juanjodiaz04/Proyecto_Diseno_Productos/Reportes/Proyecto_Diseño_E2.pdf

Diseno Electr ˜ | onico y Captura Esquem ´ | atica CubeSat ´
UD34

Juan Jose Diaz, Kevin Echeverri Universidad de Antiquia
Diseno de Productos Electr ˜ | onicos ´
1. INTRODUCCION´
El presente informe tecnico documenta el dise ´ | no electr ˜ | onico detallado y la captura esquem ´ | atica de la tarjeta de Comunica- ´
ciones y Computador a Bordo (Comms+OBC), correspondiente a la arquitectura segmentada del nanosatelite acad ´ | emico tipo ´
CubeSat 1U (UD34). Partiendo de la arquitectura funcional, las interfaces y la matriz de requisitos consolidadas en las etapas
previas del proyecto, este trabajo aborda la transicion desde la definici ´ | on de bloques a nivel de sistema hacia la especificaci ´ | on´
e implementacion esquem ´ | atica rigurosa a nivel de componentes. ´

La PCB asignada constituye el nucleo de procesamiento central y el enlace de RF de la plataforma espacial. Sus funciones ´
principales abarcan la gestion del software de vuelo, el empaquetado de telemetr ´ | ía y ejecucion de comandos, la recepci ´ | on´
y almacenamiento masivo de las imagenes multiespectrales provenientes de la carga ´ | util, y el acondicionamiento de los ´
enlaces de radiofrecuencia para la descarga de datos hacia la estacion terrestre de referencia en Medell ´ | ín. Para satisfacer estos
requerimientos dentro del volumen y potencia restringidos de un CubeSat 1U, se selecciono una arquitectura h ´ | íbrida System-
on-Chip (SoC Microchip SmartFusion2) combinada con una cadena de comunicacion dual en bandas UHF y Banda S. ´
2. DESCRIPCION´ , FUNCIONES Y REQUISITOS DE LA TARJETA
El alcance de esta seccion del proyecto comprende la definici ´ | on de la arquitectura electr ´ | onica del CubeSat, la selecci ´ | on´
justificada de componentes, la elaboracion de esquem ´ | aticos detallados, el enrutamiento de las tarjetas de circuito impreso ´
(PCBs) y la integracion tridimensional b ´ | asica del hardware. ´
2.1. Descripcion´
La tarjeta COMMS+OBC es la segunda de las tres PCB en que se divide el CubeSat 1U UD34, junto con la tarjeta de
potencia (EPS) y la de carga util y actitud. Re ´ | une en una sola placa la computadora de a bordo y los enlaces de radio del sat ´ | elite. ´
Se conecta con el resto del sistema mediante el bus PC/104, para el que se usan dos conectores Samtec ESQ-126-14-G-D de 52 pines. Un conector de depuracion Samtec HTST10501-LDVDA de 10 pines permite programar y depurar la tarjeta, y dos ´ conectores SMP Rosenberger 18S142-40ML5 sacan las senales de radiofrecuencia hacia las antenas de UHF y banda S. ˜

La tarjeta se organiza en cuatro bloques funcionales: procesamiento y memoria, enlace UHF, enlace en banda S y gestion´ de energía:

2.11. Procesamiento y memoria: El elemento central es el SoC Microchip M2S050-FGG484I (SmartFusion2), que combina un procesador ARM y una FPGA en un mismo encapsulado. Sus controladores de memoria admiten DDR3 con correccion´ de errores SECDED, y el protocolo de la memoria eMMC se implementa en la logica programable. Una memoria ISSI ´ IS43TR16256A-125KBLI (DDR3L) funciona como RAM de trabajo. El firmware se guarda en memoria MRAM Everspin MR4A16BCYS35, de 2 MB por dispositivo, en encapsulado TSOP2-54, con un mínimo de dos y un maximo de cuatro unidades. ´ El almacenamiento masivo esta a cargo de una eMMC Micron MTFC32GAPALBH-AAT. Un oscilador Aker S3A33025 de 50 ´ MHz proporciona el reloj del sistema, y un supervisor con watchdog Texas Instruments TPS3823-33-EP vigila la alimentacion´ de 3.3 V y reinicia el sistema ante fallos.
2.12. Enlace UHF (435 a 438 MHz): Utiliza un transceptor Silicon Labs Si4468-A2A-IM, que sustituye al AX5043
considerado inicialmente. La codificacion de canal Reed-Solomon se ejecuta en la FPGA del SoC. En transmisi ´ | on, un ´
amplificador de potencia Analog Devices ADL5324 entrega cerca de 0.5 W, y un filtro pasa-bajos LC discreto limpia la
salida. Un conmutador SPDT pSemi PE4259 comparte la antena entre transmision y recepci ´ | on. En recepci ´ | on, un LNA Qorvo ´
PSA4-5043 precede a un filtro SAW RFMi SF2446E, de 23 MHz de ancho de banda, colocado solo en la ruta de recepcion. ´

2.13. Enlace en banda S (2.4 a 2.45 GHz): Se basa en el transceptor de radio definido por software Analog Devices AD9364BBCZ, en encapsulado CSP-BGA de 144 bolas, con un oscilador de referencia Aker S733025T de 40 MHz. El AD9364 entrega unos 7.5 dBm, por lo que la cadena de transmision a ´ nade un driver ADL5320 y un amplificador ADL5324, ˜ el mismo de la ruta UHF con otra red de adaptacion, para una potencia estimada de 0.4 a 0.5 W en la antena. Los baluns ´
Johanson 2450BL15B100 convierten entre las senales diferenciales del transceptor y las asim ˜ | etricas de la ruta de RF, y un filtro ´
TDK DEA202450BT limita las emisiones fuera de banda en transmision. La antena se comparte con un segundo conmutador ´
PE4259. El transceptor ya integra un LNA de recepcion; un Maxim MAX2644 queda como opci ´ | on, sujeto a evaluar si se ´
necesita.
2.14. Gestion de energ ´ | ía: La tarjeta recibe su alimentacion desde el bus del sat ´ | elite y genera localmente los rieles que ´
necesita. Un regulador conmutado Texas Instruments TPS62903 produce los rieles de 1.2 V, 1.35 V, 1.8 V. Un regulador lineal de ultra bajo ruido Analog Devices LT3045 alimenta las secciones analogicas del AD9364. Los amplificadores de potencia ´ trabajan con un riel de 5 V que un interruptor de carga Texas Instruments TPS22918-Q1 conecta solo durante los pases de comunicacion, lo que reduce el consumo medio. Un monitor de corriente Texas Instruments INA226 mide el consumo y protege ´ contra latch-up por radiacion (SEL). ´
2.2. Requisitos de la Tarjeta

Tabla I: Requisitos aplicables a la tarjeta de OBC + COMMS (PCB 2)

ID | Tipo | Requisito | Origen o justificacion | Prioridad Criterio de aceptaci ´ | on´
RF-02 | Funcional | El CubeSat debera almacenar tempo- ´ ralmente los datos generados por la
carga util antes de su transmisi ´ | on a ´
| | tierra. | S-05 / Operacion de la ´ carga util. ´
Alta | La capacidad de almacenamiento
| | | | | definida en la eMMC/MRAM de la
PCB debera ser igual o superior al ´ volumen maximo de datos generado ´
| | | | | entre oportunidades de descarga.
RF-03 | Funcional | El CubeSat debera transmitir a la ´
estacion terrestre los datos de misi ´ | on´
| | y la telemetría correspondiente al estado del satelite. ´ | S-08 / Comunicacion´ satelite–tierra. ´
Alta | El presupuesto de enlace de la etapa
| | | | | RF de la tarjeta debera demostrar ´ la capacidad de realizar el enlace descendente durante una ventana de

comunicacion prevista. ´
RF-04 | Funcional | El CubeSat debera recibir comandos ´ provenientes de la estacion terrestre. ´ | S-08 / Comunicacion´ bidireccional.
Alta | La arquitectura de comunicaciones en
la PCB debera contemplar un enlace ´
| | | | | ascendente (UHF) capaz de recibir y entregar comandos al sistema de

manejo de datos.

RNF-01 | No funcional | La plataforma espacial debera ser ´ capaz de operar nominalmente en orbita baja terrestre durante un ´ período mínimo de seis (6) meses sin
degradacion cr ´ | ítica de sus funciones.
| | | S-02 / Duracion nominal ´ de la mision. ´
Alta | La seleccion y an ´ | alisis de los ´
| | | | | componentes activos y pasivos de la
PCB debera demostrar compatibilidad ´
con una duracion m ´ | ínima de mision´
| | | | | de seis meses en el ambiente orbital
considerado.
RNF-03 | No funcional | El sistema de comunicaciones debera proporcionar un enlace con ´ margen positivo bajo las condiciones nominales de comunicacion con la ´ estacion terrestre de referencia. ´ | S-04 y S-08 / Enlace de comunicaciones.
Alta | El presupuesto de enlace de las
| | | | | etapas UHF y Banda S integradas en
la PCB debera presentar un margen ´
| | | | | superior a 0 dB para las condiciones nominales adoptadas.
RNF-04 | No funcional
Los subsistemas electricos deber ´ | an´
| | utilizar interfaces de alimentacion y ´ datos compatibles entre sí.
Integracion del sistema. | Alta | La etapa de regulaci ´ | on local (POL) ´
| | | | | y los buses de datos de la PCB
deberan demostrar compatibilidad ´ de tension, corriente, niveles ´ electricos y protocolos con el resto ´ de subsistemas.
RA-01 | Ambiental | El hardware del CubeSat debera ser ´
compatible con la operacion en vac ´ | ío
| | durante la fase orbital de la mision. ´ | S-03 / Ambiente espacial de operacion. ´
Alta | Los componentes, conectores y ma-
| | | | | teriales de la PCB (sustrato híbrido)
deberan disponer de caracter ´ | ísticas
| | | | | documentadas compatibles con la
operacion en vac ´ | ío.
Continua en la siguiente p ´ | agina ´

Continuacion de la Tabla I ´
ID | Tipo | Requisito | Origen o justificacion | Prioridad Criterio de aceptaci ´ | on´
RA-02 | Ambiental | El CubeSat debera soportar el entorno ´ termico asociado con los ciclos de ´
iluminacion y eclipse de la ´ | orbita ´
| | definida para la mision. ´ | S-03 / Entorno termico ´ orbital.
Alta | El analisis t ´ | ermico de la tarjeta ´
debera demostrar que las temperaturas ´
| | | | | estimadas de los integrados (SoC, PAs de RF, memorias) permanecen dentro de sus límites admisibles.
RA-03 | Ambiental | La estructura y los componentes del CubeSat deberan permanecer ´
mecanicamente ´ | íntegros frente
| | a las cargas previstas durante el lanzamiento y despliegue. | Entorno de lanzamiento / Seguridad.
Alta | La verificacion estructural de la PCB ´
debera demostrar la integridad de los ´
| | | | | encapsulados BGA, TSOP, conectores PC/104 y uniones de soldadura frente a los niveles de vibracion adoptados. ´
RA-04 | Ambiental | Los equipos electronicos cr ´ | íticos
| | del CubeSat deberan mantener su ´ funcionalidad despues de una Dosis ´ Ionizante Total de diseno de al menos ˜ 5 krad(Si). | S-02 y S-03 / Entorno de radiacion correspondiente ´ a una mision de seis ´ meses en SSO a 550 km.
Alta | La tolerancia documentada a TID
| | | | | de los integrados críticos de la PCB (SmartFusion2, MRAM, eMMC,

RFICs) debera ser igual o superior ´ al valor de diseno determinado. ˜
RA-05 | Ambiental | Los componentes electronicos cr ´ | íticos
| | susceptibles a latch-up deberan pre- ´ sentar un umbral de susceptibilidad a SEL por iones pesados igual o superior a 60 MeV cm²

/mg.

| | | S-03 / ECSS-E-ST-10- 12C, entorno de radiacion´ y efectos de evento unico. ´
Alta | Verificar documentalmente o mediante
| | | | | circuitos de proteccion local (*Load ´ Switches*) que los componentes de la PCB susceptibles a SEL presenten LETth ≥ 60 MeV · cm²

/mg.

RN-04 | Normativo | El subsistema de comunicaciones debera operar dentro de bandas y ´ condiciones de emision compatibles ´ con la reglamentacion de espectro ´ aplicable a la mision. ´ | S-08 / Regulacion´ de comunicaciones satelitales.
Alta | Las etapas de transmision UHF y ´
| | | | | Banda S de la PCB deberan ajustarse ´
a la asignacion de frecuencias, anchos ´
| | | | | de banda y potencias de emision´
autorizadas.
2.3. Especificaciones Tecnicas ´
Las especificaciones tecnicas se derivan de los requisitos definidos previamente y establecen los par ´ | ametros necesarios para orientar la ´
arquitectura, la seleccion tecnol ´ | ogica y las interfaces entre subsistemas; se establecen los m ´ | etodos de verificaci ´ | on utilizando las abreviaturas ´
A (analisis), I (inspecci ´ | on o revisi ´ | on documental), T (ensayo) y D (demostraci ´ | on). ´

Tabla II: Especificaciones tecnicas de la tarjeta COMMS+OBC ´

ID de especificacion´

Requisitos
asociados
Parametro t ´ | ecnico | Valor, rango o ´
tolerancia
Unidad Fundamento | Metodo ´
previsto de
verificacion´
ET-MIS-01 | RNF-01 | Vida util nominal de la ´
mision´
≥ 6 | meses | Duracion m ´ | ínima establecida en el
supuesto S-02. Condiciona la seleccion´ de componentes de la tarjeta.

A, I

ET-ORB-01 RA-02, RA-04 Altitud orbital de referencia | 550 nominal | km | Orbita adoptada en el supuesto S-03. Se ´ usa en el presupuesto de enlace y en el
analisis de radiaci ´ | on de la tarjeta. ´

A

ET-GS-01 | RNF-03 | Estacion terrestre de ´
referencia
Medellín | – | Ubicacion definida en el supuesto S-04. ´
Base del presupuesto de enlace de las bandas UHF y S.

A

ET-OBC-01 | RF-02 | Elemento de procesamiento | Microchip M2S050-FGG484I (ARM + FPGA)
– | Se requiere logica programable para im- ´
plementar el host eMMC y la codificacion´ Reed-Solomon del enlace UHF, ademas del ´ procesador de a bordo.

I

ET-OBC-02 | RF-02 | Frecuencia del reloj del sistema
50 | MHz | Oscilador Aker S3A33025 alimentado a 3.3
V.

I

ET-OBC-03 | RNF-01 | Supervision de alimentaci ´ | on´
| | y watchdog

Supervisor de 3.3 V
con watchdod

– Texas Instruments TPS3823-33-EP. Reinicia el sistema ante caídas de tension o bloqueo ´ del software.

A, I, D

ET-MEM-01

RF-02 | Memoria RAM de trabajo | 512 (4 Gb) | MB | ISSI IS43TR16256A-125KBLI (DDR3L, 1.35 V). Capacidad deducida de la
organizacion 256M ´ | × 16;

A, I

ET-MEM-02

RF-02 Memoria no volatil para ´ firmware

2 por dispositivo, de 2
a 4 dispositivos

MB Everspin MR4A16BCYS35 en TSOP2-54. La cantidad de unidades depende de la redundancia de firmware que se adopte.

A, I

Continua en la siguiente p ´ | agina ´

Continuacion de la Tabla II ´

ID de especificacion´

Requisitos
asociados
Parametro t ´ | ecnico | Valor, rango o ´
tolerancia
Unidad Fundamento | Metodo ´
previsto de
verificacion´

ET-MEM-03

RF-02 Capacidad nominal de almacenamiento masivo

32 | GB | Micron MTFC32GAPALBH-AAT (eMMC).
El host se implementa en la fabric del SoC. La capacidad util se verifica contra ´ ET-DAT-02.

A, I

ET-DAT-01 RF-01, RF-02 Volumen de datos por adquisicion´

21 | MB | Se calculara a partir de la resoluci ´ | on del ´
| | sensor, numero de bandas, profundidad de ´ bits y esquema de compresion adoptado. ´

Dimensiona el almacenamiento de la
| | tarjeta.

A

ET-DAT-02 | RF-02 | Capacidad util m ´ | ínima de
almacenamiento masivo
8 | GB | Se calculara a partir del m ´ | aximo volumen ´
de datos acumulado entre oportunidades consecutivas de descarga, y se comparará con ET-MEM-03.

A, I

ET-COM-01

RF-03 Tasa neta mínima de enlace descendente

1.0 | Kbps
Mbps | Se calculara a partir del volumen de datos ´
que debe transmitirse y del tiempo efectivo
de comunicacion con la estaci ´ | on terrestre. ´

A

ET-COM-02

RNF-03 Margen del enlace de comunicaciones

> 0 | dB | Condicion establecida por RNF-03. Se ´ verificara mediante el presupuesto de ´ enlace de cada banda en condiciones nominales.
A

ET-COM-03

RF-03, RF-04,
RN-04

Banda de operacion del ´
enlace UHF
435 a 438 | MHz | Seleccionada en la arquitectura de la tarjeta (Si4468-A2A-IM). La coordinacion y la ´
regulacion de espectro aplicables est ´ | an por ´
| | confirmar.

A, I

ET-COM-04

RF-03, RF-04,
RN-04

Banda de operacion del ´
enlace en banda S
2.4 a 2.45 | GHz | Seleccionada en la arquitectura de la tarjeta (AD9364BBCZ).
A, I

ET-COM-05

RF-03,
RNF-03

Potencia de transmision´
UHF
0.5 nominal | W | Amplificador Analog Devices ADL5324. El valor de P1dB a 436 MHz
A, T

ET-COM-06

RF-03,
RNF-03

Potencia de transmision en ´ banda S en la antena

0.4 a 0.5 (estimada) | W | El AD9364 entrega unos 7.5 dBm. El driver ADL5320 y el amplificador ADL5324 elevan la senal, y el filtro TDK ˜ DEA202450BT introduce unos 1.8 dB de perdida. ´
A, T

ET-COM-07

RF-03, RF-04 Codificacion de canal del ´ enlace UHF

Reed-Solomon en la
fabric del SoC

– El Si4468 no incluye correccion de errores, ´ por lo que la FEC debe implementarse en la logica programable. ´ A, D

ET-COM-08

RF-03, RF-04 Modo de acceso a la antena por banda

Conmutacion TX/RX ´
(semiduplex) ´

– Conmutador SPDT pSemi PE4259 por banda para compartir la antena. I, D

ET-INT-01 | RNF-04 | Tension nominal del bus ´
electrico principal ´
5 | V | Se definira mediante la selecci ´ | on de la ´
arquitectura EPS. Es la entrada de los
| | reguladores de la tarjeta.

A, I

ET-PWR-01 RNF-02,
RNF-04

Rieles generados en la
tarjeta
1.2; 1.35; 1.8 | V | Regulador conmutado TPS62903. Alimentan SoC, DDR3L (incluye VTT y VREF), eMMC, memorias MRAM, transceptores y relojes.
A, I, T

ET-PWR-02 RF-03,
RNF-02

Alimentacion de bajo ruido ´ para el transceptor de banda S

Riel dedicado con
LDO de ultra bajo
ruido
– | Analog Devices LT3045 para limpiar la
alimentacion del AD9364 (n ´ | ucleo de 1.3 ´
V).

A, T

ET-PWR-03 | RNF-02 | Riel de los amplificadores de
potencia

5, conmutado, activo
solo durante los pases
| | V | Interruptor de carga TPS22918-Q1. Reduce el consumo medio de la tarjeta.
A, T

ET-PWR-04 RF-07,
RNF-02
Potencia pico de la tarjeta | 5.5 a 9 | W | Se obtendra del presupuesto de potencia, ´ con los amplificadores UHF y banda S activos. Alimenta el presupuesto del CubeSat.
A, T
ET-PRO-01 | RA-05 | Proteccion contra latch-up de ´ la tarjeta
Corte por hardware
ante sobrecorriente;
umbral

– El pin ALERT del INA226 se conecta por hardware a la habilitacion del interruptor ´ de carga, sin intervencion del software. ´

A, I, T

ET-INT-03 | RNF-04 | Conectores del bus CubeSat
(PC/104)
2 conectores de 52 | pines | Samtec ESQ-126-14-G-D. La asignacion de ´
pines se define en la matriz de interfaces.

I

ET-INT-04 | RNF-04 | Conector de programacion y ´
depuracion´
10 | pines | Samtec HTST10501-LDVDA. Acceso al
SoC para programacion y depuraci ´ | on. ´

I, D

Continua en la siguiente p ´ | agina ´

Continuacion de la Tabla II ´

ID de especificacion´

Requisitos
asociados
Parametro t ´ | ecnico | Valor, rango o ´
tolerancia
Unidad Fundamento | Metodo ´
previsto de
verificacion´

ET-INT-05 RF-03,
RNF-04
Conectores de antena | 2 SMP (UHF y banda
S), 50

Ω Rosenberger 18S142-40ML5. La impedancia de 50 Ω es una inferencia por confirmar con la hoja de datos.

I, T

ET-MEC-01 | RN-01 | Configuracion mec ´ | anica | 1U | – | Formato definido por S-01 y la CubeSat ´
Design Specification Rev. 14.1. Acota el area disponible de la tarjeta. ´

I

ET-PCB-01 RF-03, RF-04 Material del apilamiento de la PCB

Rogers RO4350B +
Isola 370HR; 8 Capas

– Material de bajas perdidas para las capas ´ de RF y material estandar para el resto. ´ El apilamiento se detalla en la guía de enrutamiento. A, I

ET-PCB-02 RF-03, RF-04 Blindaje contra interferencia electromagnetica ´

Blindaje Harwin sobre
las secciones de RF;
referencia TBD

– Separa los circuitos de RF de los circuitos digitales y de potencia de la tarjeta. A, I

ET-ENV-01 | RA-01 | Ambiente de operacion´ durante la fase orbital
Vacío orbital | – | Condicion ambiental derivada de la ´
operacion en ´ | orbita definida en S-03. ´

A, I

ET-TH-01 | RA-02 | Rango termico de dise ´ | no | -20 a 85 ˜
◦C | Se determinara mediante an ´ | alisis ´
termico. La MRAM (-40 a +85 ´

◦C) y el
conmutador PE4259 (maximo 85 ´

◦C) fijan
el límite superior.

A

ET-STR-01 | RA-03 | Nivel de cargas y vibracio-
nes de lanzamiento
14.1 | Grms | Perfil de vibracion aleatoria envolvente ´
(NASA GEVS GSFC-STD-7000A) y
cargas cuasi-estaticas para la verificaci ´ | on´
de encapsulados BGA, TSOP y conectores de la tarjeta.

A, T

ET-RAD-01 | RA-04 | Dosis Ionizante Total de disenõ
5 | krad(Si) Dosis ionizante acumulada calculada para
6 meses en SSO a 550 km, considerando blindaje equivalente de 1.5 mm de aluminio y un margen de diseno RDM de 2.5x. ˜

A

ET-RAD-02 | RA-05 | Umbral mínimo de susceptibilidad a SEL
≥ 60 | MeV·cm²
mg

Valor establecido en RA-05 para los componentes críticos de la tarjeta susceptibles a Single Event Latch-up.

I

ET-RAD-03 | RA-04 | Mitigacion de errores en ´ memoria
SECDED en la
DDR3L; firmware
replicado en 2 a 4
MRAM

– Los controladores DDR del SoC admiten SECDED. La redundancia de MRAM protege el firmware frente a errores por radiacion. ´

A, D

2.4. Funciones
A partir de las funciones requeridas para el cumplimiento de la mision, se realiz ´ | o una asignaci ´ | on preliminar entre hardware ´
y software. Esta clasificacion considera los recursos electr ´ | onicos necesarios para ejecutar cada funci ´ | on y las responsabilidades ´
que debera asumir posteriormente el software de vuelo. Aunque dicho software no ser ´ | a implementado durante el proyecto, ´
esta distribucion permite estimar las necesidades de procesamiento, memoria, almacenamiento, interfaces y temporizaci ´ | on del ´
sistema.

Tabla III: Funciones de hardware y software asignadas a la tarjeta OBC + COMMS

Funcion | Tipo de ´
implementacion´
Recursos de hardware necesarios | Responsabilidad del software futuro | Justificacion´

Procesamiento de datos
de la carga util ´
Software | Procesador dedicado/SoC (Smart-
Fusion2 con matriz FPGA y nucleo ARM), RAM DDR3L y ´ almacenamiento masivo local. | Gestionar los datos adquiridos, generar metadatos, verificar integridad y realizar
operaciones de preparacion o compresi ´ | on´
| antes del almacenamiento o transmision. ´ | La funcion es principal- ´ mente algorítmica. La FPGA y el procesador de la PCB 2 constituyen el recurso físico sobre el cual se ejecuta el software de procesamiento.
Continua en la siguiente p ´ | agina ´

Continuacion de la Tabla III ´

Funcion | Tipo de ´
implementacion´
Recursos de hardware necesarios | Responsabilidad del software futuro | Justificacion´

Almacenamiento de
imagenes ´
| | Mixta | Memoria no volatil (eMMC / NAND ´ Flash de 8–32 GB) con interfaz compatible montada en la tarjeta central.
Administrar archivos o bloques de datos, controlar la ocupacion, verificar integridad ´ mediante CRC y eliminar los datos descargados correctamente.

RF-02. La memoria masiva
local realiza físicamente el almacenamiento,
mientras que el software
administra la organizacion´ e integridad de la
informacion. ´
Buffer temporal de
imagenes ´ | | Software | Memoria RAM disponible mínima de 16 MB en la cadena de procesamiento de la tarjeta.
Gestionar buffers de entrada y salida, controlar transferencias entre la camara, RAM ´
y memoria no volatil y evitar p ´ | erdida de ´
informacion. ´

La funcion corresponde ´
principalmente a gestion de ´ memoria de trabajo para
manipular los paquetes
de imagen antes de su
compresion o guardado. ´
Control y coordinacion´
central del CubeSat
| | Software | Computador de a bordo basado en SoC ARM Cortex-M3, memoria no volatil y buses CAN, SPI, UART, ´ I 2C y LVDS.
Ejecutar la maquina de estados de misi ´ | on, ´
coordinar subsistemas, gestionar modos de operacion, procesar eventos y ejecutar las ´ acciones asociadas a los comandos recibidos.

La coordinacion del siste- ´ ma depende principalmente
de la logica del software ´ de vuelo; el hardware
del OBC proporciona los
recursos computacionales
necesarios.
Temporizacion y ´
referencia temporal
| | Mixta | RTC, oscilador de referencia (TCXO) y temporizadores disponibles en el computador de a bordo.

Mantener el tiempo de mision, generar marcas ´
temporales para imagenes y telemetr ´ | ía y
programar eventos de operacion. ´

El hardware de la tarjeta
proporciona la referencia
temporal estable y el
software la utiliza para
sincronizar los eventos de mision. ´
Deteccion y recuperaci ´ | on´
ante fallos | | Mixta | Watchdog hardware externo, supervisores de alimentacion locales ´ y limitadores de corriente (Load Switches).

Detectar condiciones anomalas, registrar ´ eventos, reiniciar subsistemas y llevar el satelite a un estado seguro cuando sea ´ necesario.

Combina mecanismos
autonomos de protecci ´ | on´
en hardware local
con estrategias de
deteccion y recuperaci ´ | on´
implementadas mediante
software.
Recepcion de comandos ´ críticos | | Mixta | Transceptor UHF (AX5043 / CC1120 o equivalente) en el rango de 400 MHz con tasa nominal de 9,6 kbps.
Validar la integridad de las tramas recibidas, interpretar los comandos y generar las acciones correspondientes sobre los subsistemas.

RF-04. El transceptor
realiza la recepcion´
física en radiofrecuencia, mientras que el software
interpreta y ejecuta el
contenido del comando.
Transmision de telemetr ´ | ía | Mixta | Transceptor UHF con tasa nominal de 9,6 kbps y conexion digital ´ directa con el procesador central.
Construir paquetes de housekeeping con tensiones, corrientes, temperaturas, estados, alarmas y eventos, y gestionar su envío.

RF-03. El software genera
y organiza la telemetría
mientras el hardware de
radiofrecuencia realiza el enlace físico descendente.
Transmision de im ´ | agenes | Mixta | Transmisor de alta velocidad ´
| | | en Banda S (2.2–2.4 GHz) con capacidad de 1 Mbps a 8 Mbps.

Fragmentar las imagenes, organizar los ´ paquetes, gestionar la cola de transmision´ y mantener registro de la informacion´ descargada.

RF-03. El software
gestiona el flujo de
paquetes desde la eMMC
hacia la etapa RF de
Banda S para su descarga
durante la ventana sobre
Medellín.
| 3. RESTRICCIONES PARA EL DISENO DE LA ˜ | PCB

Basado en las hojas de datos, las arquitecturas discutidas y los requisitos del proyecto CubeSat 1U documentados en tus
fuentes, a continuacion se presenta la matriz de restricciones f ´ | ísicas, electricas y t ´ | ermicas para el dise ´ | no de la placa OBC + ˜
COMMS.

Tabla IV: Restricciones para el diseno PCB OBC + COMMS ˜

ID y Trazabilidad | Restriccion y Alcance | Fuente y Fundamento | Aplicaci ´ | on y Verificaci ´ | on´

PCB-01
(RF-03, RN-04)

Apilamiento Híbrido (Stackup): Placa de 8 a 12 capas. Capas externas (Top/Bottom) en Rogers RO4350B (alta frecuencia) y capas internas en FR-4 High-Tg / Isola 370HR para logica digital. ´

Recomendacion de arquitectura ´ RF/Digital: El FR-4 estandar ´ presenta perdidas inaceptables en ´ Banda S (2.4 GHz). El stackup híbrido optimiza costos e integridad de senal. ˜

Directiva de fabricacion: ´ Supuesto preliminar para el fabricante de
PCBs. Verificacion en el ´ | Layer Stack
Manager del CAD.

PCB-02
(RA-01, RA-02)
Disipacion T ´ | ermica (V ´ | ías): Arreglos
de vías termicas ( ´ | | thermal vias) bajo
los PAs de RF (ADL5324) y el SoC SmartFusion2, conectando a planos gruesos de cobre (2 oz) vinculados al chasis.

Inferencia justificada (Entorno Espacial): En el vacío no existe conveccion. Los integrados de alto ´ consumo colapsaran t ´ ermicamente ´ sin conduccion directa a la ´ estructura.

Regla de layout: Colocacion de ´ polígonos termicos y matrices de ´
vías. Verificacion mediante an ´ | alisis ´
termico del CAD y revisi ´ | on visual. ´

PCB-03
(RNF-03, RF-03)

Impedancia Controlada RF y Aislamiento: Microcintas Coplanares con Plano de Masa (CPWG) a 50 Ω hacia conectores SMP, rodeadas por apantallamiento de vías (via fencing).

Datasheet SMP y RFICs: Evita perdidas por desacople, ondas ´ reflejadas y radiacion que degraden ´ la figura de ruido o danen las etapas ˜ de salida.

Directiva de ruteo: El ancho de pista dependera del stackup final. ´ Verificacion por calculadora de ´ impedancia y regla DRC en el CAD.

PCB-04
(RNF-04, IF-02,
IF-07)

Integridad de Senales Diferenciales ˜ (LVDS): Enlaces LVDS/MIPI con impedancia diferencial de 100 Ω. Acoplamiento de longitud (desfase
< 0,3 mm) y plano de masa continuo adyacente.

Estandar LVDS / ECSS Space- ´ Wire: Cancela el ruido de modo comun, minimiza emisiones EMI ´ y previene desalineacion de fase a ´ altas velocidades.

Regla DRC de alta velocidad: Differential Pairs Routing y Length Tuning (Meandering). Verificacion´ automatica en el DRC. ´

PCB-05
(RNF-03, EMC)

Apantallamiento Electromagnetico ´ (EMI): Cajas de blindaje SMD independientes (Shielding Cans) para las secciones UHF, Banda S y reguladores Buck conmutados.

Buena practica RF (Aislamiento): ´ El ruido digital del SoC y la emision UHF (1 W) pueden ´ ensordecer los receptores LNA o acoplar ruido al enlace de Banda S.

Regla de layout: Footprints para clips de blindaje y zonas keep-out sin pistas en la capa top. Revision´ de modelo 3D.

PCB-06
(RNF-04, POL(Point
of Load))
Ubicacion de Regulaci ´ | on RF ´
(LDOs): LDOs de ultra-bajo
ruido (LT3042/LT3045) ubicados a milímetros de las entradas analogicas ´ del AD9364 (1,3 V) y LNAs.

Datasheet AD9364 y LNAs: Los PLLs y sintetizadores son sensibles al rizado de tension. Separarlos de ´ reguladores conmutados asegura un PSRR optimo. ´

Directiva de placement: Aislamiento de dominios de energía en la hoja POL y ruteo directo. Revision´ manual del esquematico. ´

PCB-07
(OBC, Power)

Desacoplamiento SoC y Filtrado LC: Multiples capacitores en paralelo ´ pegados al BGA (1,2 V). Filtrado pasivo LC (ferrita + cap) exclusivo para las líneas VDD PLL.

Guía de aplicacion SmartFusion2: ´ Inductores en el nucleo provocan ´ caídas por dI/dt. Los PLLs requieren filtrado pasivo al consumir corriente estable.

Restriccion de ruteo: ´ | Capacitores
colocados en la misma capa del BGA o con vías cortas directas.
Verificacion visual 3D e inspecci ´ | on´
de ERC.
PCB-08
(RNF-02, EPS)

Control de Pico de Corriente (Soft-Start): Capacitores de 3,3 nF a
10 nF en el pin SS/TR de los Bucks TPS62130A para un arranque suave de ≈ 2 − 4 ms.

Datasheet TPS62130A y dinamica ´
sistemica: ´ | Previene colapsos en el
bus de alimentacion global del EPS ´ al cargar el banco de capacitores del SoC/DDR3L.
Comprobacion esquem ´ | atica ´
(ERC): Verificacion de selecci ´ | on de ´
dielectricos C0G/X7R en la BOM y ´ simulacion de tiempo de arranque. ´
4. CONDICIONES DE FABRICACION´

Con el fin de garantizar la manufacturabilidad (Design for Manufacturing - DFM) y asegurar la confiabilidad del ensamblaje de la tarjeta integrada de OBC + COMMS, se selecciono al proveedor PCBWay (https://www.pcbway.com/advanced-pcb-capabilities.html) como fabricante de referencia (Consultado ´
20/10/2026). Esta eleccion se fundamenta en su capacidad tecnol ´ | ogica para procesar circuitos impresos multicapa de alta ´
densidad (HDI), el soporte para acabados superficiales de grado fino y QFN, y la disponibilidad de procesos para stackups híbridos con sustratos de alta frecuencia.
A partir de las especificaciones y tolerancias del proceso de fabricacion, se definieron los l ´ | ímites geometricos y el ´ | ectricos que ´
deben configurarse como reglas de diseno (Design Rules) en el entorno CAD (Altium Designer). Estas condiciones aseguran ˜ la integridad física de las pistas de impedancia controlada (50 Ω RF y 100 Ω diferencial LVDS), la viabilidad en la perforacion´
y metalizado de vías termicas, y el cumplimiento de los m ´ | argenes de aislamiento electromagn ´ | etico. ´
La Tabla V sintetiza los parametros l ´ | ímite de fabricacion adoptados para el dimensionamiento del layout de la PCB. ´

Tabla V: Parametros de dise ´ | no DFM vs. l ˜ | ímites de fabricacion de PCBWay ´
Parametro DFM | Par ´ | ametro Escogido ´
(PCB 2)
Límite del Fabricante (PCBWay) | Fundamento / Criterio de Seleccion´
Numero de capas | 8 capas | Hasta 64 capas | Requerido para el escape (*fanout*) del BGA ´
de 484 pines (SmartFusion2), ruteo de buses LVDS y planos de masa para RF.
Material base y Stackup | Híbrido: Rogers RO4350B (capas ext.) + FR-4 High- Tg / Isola 370HR (capas int.) | FR-4 High-Tg (Tg170–220), Rogers 4350/4003, PTFE, Ceramico, ´ Prensado mixto (2–20 capas)
Minimiza la atenuacion diel ´ | ectrica en la etapa ´
de Banda S (2,4 GHz) en capas externas y optimiza costos en capas digitales internas.
Espesor nominal de la placa | 1,6 mm ± 7 % | 0,21 mm − 6,0 mm (±7 % para espesores entre 1,0 mm y 2,5 mm)
Estandar mec ´ | anico compatible con los ´
conectores apilables PC/104 de la estructura CubeSat 1U y rigidez ante vibraciones.
Ancho de pista y espaciamiento (W/S) | 4,0 mil/4,0 mil (0,10 mm) | Mínimo 2,0 mil/2,0 mil (0,05 mm) en capas internas y externas
Facilita el ruteo entre los pines del BGA (0,8 mm pitch) manteniendo un alto rendimiento de fabricacion (*yield*). ´
Diametro de perforaci ´ | on´
vía (Drill) | 0,20 mm (8 mil) mecanico ´ pasante | Mínimo 0,15 mm (Mecanizado CNC) / 0,10 mm (Microvía Laser ´ ciega/enterrada)
Permite la transicion entre capas sin recurrir a ´
microvías laser de alto costo (tecnolog ´ | ía HDI
estandar pasante). ´

Relacion de aspecto ´
(*Aspect Ratio*)
8 : 1 (1,6 mm/0,20 mm) | Hasta 12 : 1 (estandar) / ´ | 20 : 1
| | (capacidad maxima) ´

Garantiza la homogeneidad y continuidad del cobreado electrolítico en las paredes internas de las vías pasantes.

Anillo de cobre (*Annular Ring*) | 4,0 mil (0,10 mm) en vías / 6,0 mil en orificios THT | Mínimo 3,0 mil en vías / 5,0 mil en orificios de componentes
Previene la desalineacion de la perforaci ´ | on´
(*breakout*) y asegura la integridad bajo
delaminacion por ciclos t ´ | ermicos. ´
Capacidad para componen- tes BGA | Pitch de 0,8 mm / Pad de 0,35 mm | Pitch mínimo de BGA: 0,4 mm /
Diametro m ´ | ínimo de BGA: 8 mil
| | (0,20 mm)

Adaptado a la matriz FGG484 del SoC SmartFusion2 (M2S050) y chips de memoria masiva.

Puente de mascara de ´ soldadura (*Solder Mask Dam*) | 4,0 mil (0,10 mm) | Mínimo 3,0 mil (mascara verde) / ´ 4,0 mil (mascara negra/otras) ´
Retiene el flujo de soldadura entre pads adyacentes de alta densidad para prevenir cortocircuitos por puentes durante el *reflow*.
Acabado superficial (*Surface Finish*) | **ENIG** (*Electroless Nickel Immersion Gold*) | ENIG, HASL, Lead Free HASL, OSP, Immersion Ag/Sn, Plating Hard Gold

Superficie plana indispensable para encapsulados BGA/QFN de paso fino y excelente resistencia a la oxidacion en ´ almacenamiento/vacío.

Tolerancia de control de impedancia | ±10 % (50 Ω RF CPWG / 100 Ω diferencial LVDS) | ±10 % (±5 Ω para impedancias ≤ 50 Ω)
Asegura la integridad de senal en la interfaz ˜ del SDR AD9364, conector SMP y las trazas de alta velocidad de la camara. ´
Distancia vía a conductor (*Hole to Conductor*) | 8,0 mil (0,20 mm) | Mínimo 6,0 mil (0,15 mm) a conductores internos y externos
Evita acoplamientos capacitivos no deseados y perforaciones sobre pistas activas por tolerancias de taladrado.
Espesor del cobre (*Copper Thickness*) | Capas ext.: 1,0 oz (35 µm) / Capas int.: 0,5 − 1,0 oz | Cobre base mín. 1/3 oz (12 µm) hasta 8 oz maximo final ´
Proporciona la capacidad de conduccion´ necesaria para los reguladores POL y estabilidad para el grabado de líneas de RF.
5. RESTRICCIONES PROYECTO DE ALTIUM
Las restricciones siguientes corresponden a la etapa de captura esquematica ´ | de la tarjeta Comms+OBC. Se distinguen
las comprobaciones que pueden ejecutarse en Altium de las restricciones de PCB que unicamente podr ´ | an verificarse despu ´ | es´
del diseno f ˜ | ísico. Los límites de impedancia, geometría y materiales descritos en las secciones anteriores se conservan como
objetivos de disenõ , no como resultados de fabricacion demostrados. ´

Tabla VI: Matriz de restricciones del proyecto Altium y criterio de comprobacion. ´

ID | Restriccion / criterio de aceptaci ´ | on | Evidencia y m ´ | etodo ´
AL-01 | Cada componente montado debe tener desig-
nador unico, valor o referencia, fabricante, ´ MPN y huella compatible.

Inspeccion de propiedades y compara- ´
cion esquem ´ | atico–BOM; revisar com- ´
ponentes sin footprint.

ID | Restriccion / criterio de aceptaci ´ | on | Evidencia y m ´ | etodo ´
AL-02 | No deben existir redes sin conductor inten-
cional, conflictos de direccion el ´ | ectrica ni pi- ´
nes de alimentacion indebidamente abiertos. ´

Compilacion y ´ Electrical Rules Check (ERC); registrar y justificar excepciones.

AL-03 Todas las hojas deberan usar nombres de ´ red, puertos y conexiones jerarquicas cohe- ´

rentes, sin uniones implícitas no previstas.

| | | | Navegador de redes, cross-probing y
revision manual hoja a hoja. ´
AL-04 | Cada dominio de alimentacion deber ´ | a indi- ´
| car tension nominal, secuencia de encendi- ´
do, retorno y protecciones aplicables.

Revision de hojas POL, reguladores, ´
| | | | load switches, supervisor y secuencia
de arranque.
AL-05 | Las interfaces del SoC, memorias y radios
| deben respetar niveles logicos, direcciones, ´ tensiones de banco y asignacion de pines. ´ | | | Cruce de datasheets, pinout y tabla de interfaces; comprobacion de conexio- ´

nes.

AL-06 | El reloj de referencia, reset, watchdog, pro-
| gramacion y arranque deben estar definidos ´
y sin estados flotantes peligrosos.

Revision de osciladores, resistencias ´ de polarizacion, JTAG y supervisor. ´

AL-07 | Las redes RF deben identificar trayectoria
TX/RX, filtros, adaptacion, alimentaci ´ | on y ´
conectores de impedancia nominal 50 Ω.

Inspeccion de cadena RF y datasheets; ´
| | | | impedancia física pendiente de layout.
AL-08 | Las senales diferenciales y los buses de alta ˜ velocidad deberan tener pares, polaridad, ´ terminacion y restricciones identificables. ´
Revision del esquem ´ | atico y futu- ´
ra definicion de reglas de impedan- ´
| | | | cia/longitud en PCB.
AL-09 | Los dispositivos de potencia y radiofrecuen-
| cia deberan contar con desacoplamiento y ´
filtrado acordes con sus fabricantes.

Revision manual de condensadores, ´
| | | | valores, ubicacion prevista y rutas de ´
retorno.
AL-10 | Los componentes opcionales o no montados
| deberan identificarse inequ ´ | ívocamente para
la configuracion de producci ´ | on. ´
| | | | Variantes de ensamblaje y BOM ex- portada con columna de montaje.
AL-11 | Las librerías deberan tener correspondencia ´
verificable entre símbolo, numeracion de pi- ´
| nes y footprint.
Comparacion con datasheets y revisi ´ | on´
| | | | de modelos en Altium.
AL-12 | El proyecto entregado debe contener fuen-
| tes editables, PDF del esquematico, BOM, ´ evidencias ERC y version identificada. ´ | | | Auditoría del repositorio y compro-
bacion de accesibilidad del com- ´ mit/etiqueta.
5.1. Restricciones derivadas y control de cambios
El inventario actualizado de componentes constituye una entrada de control de configuracion, pero ´ | no reemplaza la BOM
generada desde el proyecto compilado. En particular, se debe reconciliar la mencion previa del regulador TPS62130A con el ´ TPS62903QRYTRQ1 listado actualmente; no se deben trasladar valores de soft-start, compensacion o condensadores de un ´ circuito integrado al otro sin consultar su hoja de datos. Asimismo, las referencias de memorias, osciladores, balunes y filtros se deben contrastar con el voltaje, frecuencia, encapsulado y modo de interfaz realmente cableados. Toda sustitucion debe ´ registrar el requisito afectado, la hoja modificada y la revision del proyecto. ´
6. VERIFICACION DEL ´ | DISENÕ
La verificacion se plantea de acuerdo con el enfoque de ingenier ´ | ía de sistemas de NASA: cada requisito debe vincularse
con un metodo, un criterio de aceptaci ´ | on y una evidencia. Se emplean ´ | I (inspeccion), ´ | A (analisis), ´ | D (demostracion) y ´ | P
(prueba). En esta fase se verifica principalmente la consistencia del diseno esquem ˜ | atico ´ | ; el funcionamiento en hardware, la
compatibilidad electromagnetica y las prestaciones orbitales requieren ensayos posteriores. Ning ´ | un resultado de ERC o de ´
laboratorio se declara aprobado sin evidencia adjunta.

Tabla VII: Plan de verificacion y trazabilidad preliminar. ´

ID | Elemento a verificar | Meto- ´ do
Criterio de aceptacion | Estado / evidencia ´
VER-01 | Integridad | del
esquematico ´
| | I | | Proyecto compilado; sin errores
electricos reales sin resolver. ´

Revisado: reporte
ERC.
VER-02 | Símbolos y huellas | I | | Coincidencia de todos los pines y
encapsulados con el fabricante.

Revisado: revision´
cruzada.
VER-03 | Dominios de tension | I/A | Cada carga recibe alimentaci ´ | on´
| | | | compatible y tiene desacoplamien-
to definido.

Revisado: matriz
de tensiones.
VER-04 | Arranque y supervision I/A | Estados de ´ | reset, reloj y watchdog
coherentes con datasheets.

Revisado: secuencia de arranque.

VER-05 | Memorias y OBC | I/A | Interfaz y asignacion de pines ´
| | | | coherentes con la arquitectura se-
leccionada.

Revisado: revision´
de pinout.
VER-06 | Cadena UHF | I/A | | Trayectoria RF completa y nive- les de control compatibles con los

RFIC.

Revisado: revision´
de hojas RF.
VER-07 | Cadena banda S | I/A | | Transceptor, balunes, amplificacion´ y filtrado compatibles en frecuen-

cia y potencia.

Revisado:
presupuesto
RF.
VER-08 | Distribucion de poten- ´ cia
A/P | Corriente, perdidas y arranque den- ´
| | | | tro de límites de cada componente.

Analisis revisado; ´
prueba futura.
VER-09 | Compatibilidad EMC | A/P | Reglas de particion y filtrado de- ´
finidas; ensayos segun plan aplica- ´ ble.

Layout y pruebas
futuras.
VER-10 | Restricciones físicas | A/I | | Contorno, altura, taladros y conec- tores compatibles con integracion´

1U.

Comprobacion 3D ´
futura.
VER-11 | Reglas PCB | A/I | | DRC conforme al stackup aproba-
do y tolerancias del fabricante.

Revisado en layout.

VER-12 | Coherencia documen- tal
I | Misma revision en esquem ´ | atico, ´
BOM, calculos y repositorio. ´

Revisado:
auditoría final.
6.1. Procedimiento de revision en Altium Designer ´
Se debera (1) compilar el proyecto y exportar el panel ´ | Messages; (2) revisar los errores y advertencias individualmente, sin
deshabilitar reglas de manera global; (3) recorrer cada hoja comprobando alimentacion, conexiones, buses, pines sin conectar ´ y componentes auxiliares; (4) comparar designadores, cantidades y huellas con la BOM; (5) revisar de manera independiente entre ambos integrantes los circuitos de reloj, memoria, RF y potencia; y (6) guardar capturas fechadas y un registro de incidencias. Una advertencia aceptada debe incluir su motivo y el responsable de la decision. ´
6.2. Alcance de la evidencia
La aprobacion del ERC indica consistencia el ´ | ectrica seg ´ | un las reglas configuradas, pero no demuestra estabilidad de ´
reguladores, desempeno de radio, integridad de se ˜ | nal, inmunidad EMC, tolerancia a radiaci ˜ | on ni aptitud de vuelo. La ´ | CubeSat
Design Specification Rev. 14.1 se emplea como referencia para restricciones de integracion; las normas ECSS-E-ST-20C ´ Rev. 2, ECSS-E-ST-20-07C Rev. 2 y ECSS-Q-ST-70-12C Rev. 1 sirven de marco tecnico para electricidad, EMC y PCB, ´
respectivamente. Su aplicacion contractual y el grado de cumplimiento deben definirse para la misi ´ | on concreta. ´
7. BOM Y ANALISIS DE ´ | COSTOS
La lista de referencias suministrada se utiliza como inventario preliminar de componentes principales. Para completar la
BOM de fabricacion deben exportarse desde Altium tambi ´ | en resistencias, condensadores, inductores, ferritas, diodos, conectores, ´

redes de adaptacion y todos los dem ´ | as componentes auxiliares efectivamente presentes en el esquem ´ | atico. No se infieren ´
cantidades ni precios a partir de una lista de enlaces.

Tabla VIII: Referencias principales del inventario actualizado; cantidades y montaje por confirmar en Altium.

Funcion | Referencia | Fabricante ´
SoC/OBC | M2S050-FG484 | Microchip
MRAM | MR4A16BCYS35R | Everspin
RAM | IS43TR16256A-125KBL | ISSI
Almacenamiento | MTFC32GAPALBH-AAT | Micron
Oscilador | S3A33025-50.000-L-X-R | Aker
Supervisor | TPS3823-33DBVT | Texas Instruments
Transceptor RF | SI4464-B1B-FMR | Silicon Labs
Amplificador RF | ADL5324ARKZ-R7 | Analog Devices
Conmutador TX/RX PE4259 | pSemi
Amplificador RF | PSA4-5043+ | Mini-Circuits
Filtro RX | SF2421D | RFMi
SDR | AD9364BBCZ | Analog Devices
Referencia RF | S733025T-40.000-15-R | Aker
Balun | 2450BL15B100E | Johanson
Driver RF | ADL5320ARKZ-R7 | Analog Devices
Filtro TX | DEA202450BT-1294D1-H | TDK
LNA opcional | MAX2644EXT+T | Analog Devices
Buck | TPS62903QRYTRQ1 | Texas Instruments
LDO bajo ruido | LT3045IMSE#PBF | Analog Devices
Monitor de corriente INA226AIDGST | Texas Instruments
Interruptor de carga TPS22918TDBVRQ1 | Texas Instruments
JTAG | HTST-105-01-L-DV-A | Samtec
Bus PC/104 | ESQ-126-14-G-D | Samtec
Conector SMP | 18S142-40ML5 | Rosenberger
Condensador | 0,5 pF, ±0,1 pF, 25 V, 0402 | Generico (sin MPN) ´
Condensador | 1 pF, 50 V, C0G, 0603 | Generico (sin MPN) ´
Condensador | 1,2 pF, 50 V, C0G, 0603 | Generico (sin MPN) ´
Condensador | 1,5 pF, 50 V, CH | Generico (sin MPN) ´
Condensador | 2,2 pF, 16 V, C0G, 0603 | Generico (sin MPN) ´
Condensador | 6,2 pF, 50 V, C0G, 0603 | Generico (sin MPN) ´
Condensador | 10 pF, ±5 %, 50 V, 0603 | Generico (sin MPN) ´
Condensador | 12 pF, ±10 %, 50 V, 0402 | Generico (sin MPN) ´
Condensador | 15 pF, ±10 %, C0G, 0603 | Generico (sin MPN) ´
Condensador | 20 pF, ±10 %, 50 V, C0G, 0603 | Generico (sin MPN) ´
Condensador | 33 pF, 50 V, X8R, 0603 | Generico (sin MPN) ´
Condensador | 100 pF, 50 V, C0G, 0402 | Generico (sin MPN) ´
Condensador | 100 pF, 100 V, C0G, 0603 | Generico (sin MPN) ´

Funcion | Referencia | Fabricante ´
Condensador | 1 nF, ±20 %, 50 V, 0402 | Generico (sin MPN) ´
Condensador | 3,3 nF, 16 V, X7R, 0603 | Generico (sin MPN) ´
Condensador | 10 nF, 50 V, X7R, 0603 | Generico (sin MPN) ´
Condensador | 100 nF, ±20 %, 50 V, 0402 | Generico (sin MPN) ´
Condensador | 100 nF, ±10 %, 50 V, 0603 | Generico (sin MPN) ´
Condensador | 100 nF, ±10 %, 50 V, 0805 | Generico (sin MPN) ´
Condensador | 1 µF, ±10 %, 16 V, 0603 | Generico (sin MPN) ´
Condensador | 1 µF, ±10 %, 50 V, 0805 | Generico (sin MPN) ´
Condensador | 2,2 µF, ±20 %, 10 V, 0402 | Generico (sin MPN) ´
Condensador | 4,7 µF, ±40 %, 25 V, 0805 | Generico (sin MPN) ´
Condensador | 10 µF, 16 V, X5R, 0603 | Generico (sin MPN) ´
Condensador | 10 µF, 25 V, X5R, 0805 | Generico (sin MPN) ´
Condensador | 10 µF, ±20 %, 25 V, 0805 | Generico (sin MPN) ´
Condensador | 22 µF, 6,3 V, X5R, 0805 | Generico (sin MPN) ´
Inductor | 3,3 nH, 0603 | Generico (sin MPN) ´
Inductor | 3,9 nH, 0603 | Generico (sin MPN) ´
Inductor | 5,6 nH, ±5 %, 0603 | Generico (sin MPN) ´
Inductor | 15 nH, ±3 %, 0201 | Generico (sin MPN) ´
Inductor | 20 nH, ±3 %, 0402 | Generico (sin MPN) ´
Inductor | 47 nH, ±5 %, 0402 | Generico (sin MPN) ´
Inductor | 100 nH, ±5 %, 0402 | Generico (sin MPN) ´
Inductor | 120 nH, ±5 %, 1008 | Generico (sin MPN) ´
Inductor | 1 µH, ±20 %, 0806 | Generico (sin MPN) ´
Resistencia | 0,02 Ω, ±1 %, 0603 | Generico (sin MPN) ´
Resistencia | 2 Ω, ±5 %, 0603 | Generico (sin MPN) ´
Resistencia | 10 Ω, ±1 %, 0402 | Generico (sin MPN) ´
Resistencia | 22 Ω, ±5 %, 0402 | Generico (sin MPN) ´
Resistencia | 68 Ω, ±5 %, 0805 | Generico (sin MPN) ´
Resistencia | 240 Ω, ±5 %, 0402 | Generico (sin MPN) ´
Resistencia | 249 Ω, ±0,1 %, 0603 | Generico (sin MPN) ´
Resistencia | 1 kΩ, ±5 %, 0805 | Generico (sin MPN) ´
Resistencia | 1,2 kΩ, ±1 %, 0805 | Generico (sin MPN) ´
Resistencia | 4,7 kΩ, ±1 %, 0603 | Generico (sin MPN) ´
Resistencia | 4,7 kΩ, ±1 %, 0805 | Generico (sin MPN) ´
Resistencia | 10 kΩ, ±1 %, 0603 | Generico (sin MPN) ´
Resistencia | 10 kΩ, ±1 %, 0805 | Generico (sin MPN) ´
Resistencia | 14,3 kΩ, ±0,1 %, 0603 | Generico (sin MPN) ´
Resistencia | 16,9 kΩ, ±1 %, 0805 | Generico (sin MPN) ´
Resistencia | 21 kΩ, ±0,5 %, 0805 | Generico (sin MPN) ´
Resistencia | 30,1 kΩ, ±1 %, 0603 | Generico (sin MPN) ´
Resistencia | 32,4 kΩ, ±0,5 %, 0805 | Generico (sin MPN) ´

Funcion | Referencia | Fabricante ´
Resistencia | 49,9 kΩ, ±1 %, 0201 | Generico (sin MPN) ´
Resistencia | 200 kΩ, ±1 %, 0402 | Generico (sin MPN) ´
Resistencia | 402 kΩ, ±1 %, 0805 | Generico (sin MPN) ´
7.1. Estimacion de costos para lotes de producci ´ | on´
Para cada referencia i y lote de N tarjetas se calcula la demanda qiN, donde qi es la cantidad montada por tarjeta. En
esta estimacion preliminar se presupuestan las 89 l ´ | íneas del BOM de Altium tal como fueron exportadas, equivalentes a 220
componentes por tarjeta, y se compra exactamente la demanda del lote, es decir, Qi(N) = qiN. El precio unitario pi(Qi)
se selecciona segun el tramo de volumen de cada l ´ | ínea (menos de 100, de 100 a 999 y 1000 o mas unidades); cuando una ´
referencia no publica tramos, estos se aproximan. Entonces:

Clote(N) = ∑︂

i

Qi(N) pi

(︁
Qi(N)

)︁

, | Ctarjeta(N) = Clote(N)
N
. | (1)
Como no se consideran mínimos de pedido adicionales ni multiplos de empaque, el sobrante resulta ´ | Si(N) = Qi(N)−qiN = 0.
Se mantiene la misma variante de montaje en los tres escenarios, incluido el LNA MAX2644, que se presupuesta aunque esté anotado como opcional. No se incluyen fabricacion de PCB, ensamblaje, transporte, impuestos, aranceles ni merma. Los precios ´ estan expresados en USD con fecha de referencia del 26 de octubre de 2026. ´

Tabla IX
RESUMEN DE COSTOS DE COMPONENTES POR LOTE (USD, PRECIOS DE REFERENCIA PARCIALMENTE ESTIMADOS).

Lote Costo del lote (USD) Costo por tarjeta (USD)

10 | 6 746,67 | 674,67
100 | 58 829,38 | 588,29
1000 | 502 316,60 | 502,32

Los precios proceden de dos fuentes: datos publicados en los enlaces de los proveedores (WEB), que representan aproximadamente el 49 %, 51 % y 53 % del costo para los lotes de 10, 100 y 1000 tarjetas, respectivamente, y estimaciones de ingeniería para el resto, que no son cotizaciones verificadas. Entre los riesgos identificados estan la obsolescencia de la ´ memoria eMMC de Micron y que el precio del SoC se tomo de una referencia con sufijo distinto (M2S050-FG484I). Si se ´
exige una compra real, deberan verificarse disponibilidad, m ´ | ínimos de pedido y precios actualizados.
Con estos valores se puede graficar el tamano de lote frente al costo de componentes por tarjeta, indicando en la gr ˜ | afica que ´
las cifras combinan precios publicados y estimados. Al consolidar las cotizaciones definitivas, se deberan explicar los efectos ´ de los descuentos por volumen, las cantidades mínimas y los sobrantes. El costo por tarjeta disminuye aproximadamente un 25 % entre los lotes de 10 y 1000 unidades, efecto atribuible a los descuentos por volumen.

El costo de componentes por tarjeta disminuye de 674,67 USD (lote de 10) a 588,29 USD (lote de 100) y a 502,32 USD (lote de 1000), lo que equivale a una reduccion de 12,8 % en el primer salto y de 14,6 % en el segundo, con 25,5 % acumulado. ´ La baja total, de unos 172 USD por tarjeta, se concentra en pocos componentes. El transceptor AD9364BBCZ aporta cerca del 29 % del costo en los tres lotes (195, 172 y 145 USD por unidad), el SoC M2S050-FG484 entre 21,9 % y 23,6 % (147,45, 138,68 y 116,25 USD) y las dos memorias MR4A16BCYS35R entre 17,8 % y 20,2 % (60,10, 55,27 y 50,73 USD cada una). Estas tres referencias suman entre 69 % y 72 % del costo, y con la eMMC y la RAM las cinco mayores llegan a cerca del 79 %. En cambio, los 189 pasivos por tarjeta pesan solo entre 2,2 % y 0,7 % del costo, y su descuento (de 0,075 a 0,009 USD
por unidad) es irrelevante en terminos absolutos. La reducci ´ | on del costo total depende, por tanto, de los tramos de precio de ´
unos pocos circuitos integrados y no del numero de componentes. ´

La disminucion no es uniforme para todas las referencias. El convertidor TPS62903QRYTRQ1 mantiene 5,966 USD por ´
unidad entre los lotes de 100 y 1000, porque el precio de 1000 unidades se igualo al del tramo anterior por falta de cotizaci ´ | on, ´
y su contribucion sube de 3,0 % a 3,6 % del costo total al reducirse el resto. Tres l ´ | íneas con 19 o 20 unidades por tarjeta (los
condensadores de 100 nF en 0402 y 0603 y las resistencias de 10 kΩ en 0805) ya aplican el tramo inferior desde el lote de 10, pues su demanda total supera las 100 unidades, y por eso no cambian entre 100 y 1000. Ademas, hay condiciones de compra ´ que el calculo no refleja: el tramo de 1000 unidades del MR4A16BCYS35R y del ADL5324ARKZ-R7 corresponde a precio ´

por carrete, que podría exigir comprar un carrete completo, y el TPS22918TDBVRQ1 figura sin existencias. Como el modelo asume que se compra exactamente la demanda (Si = 0), sin mínimos de pedido ni multiplos de empaque, puede subestimar el ´ costo en el lote de 10, donde el sobrante sería proporcionalmente mayor. Finalmente, solo el 49 % a 53 % del costo proviene de precios publicados; los tramos del AD9364BBCZ, la eMMC y la RAM son estimaciones, por lo que la pendiente de la curva en esos casos es una hipotesis hasta contar con cotizaciones. ´

REFERENCIAS

[1] California Polytechnic State University, “CubeSat design specification (CDS) rev. 14.1,” Tech. Rep., Cal Poly SLO, 2022.
[2] Lars Alminde, Morten Bisgaard, Kasper Vinther, Tomasz Viscor, and Jens D. Ostergard, “The AAUSAT3 CubeSat mission: Design, implementation and flight results,” in Proceedings of the International Astronautical Congress (IAC), 2014, pp. 1–12.
[3] Pumpkin Inc., CubeSat Kit Hardware Architecture Specification, Pumpkin Systems, 2021.
[4] Microchip Technology Inc., SmartFusion2 SoC FPGA Datasheet, 2023.
[5] XIMEA GmbH, xiSpec Snapshot Mosaic Hyperspectral and Multispectral Cameras, 2024.
[6] AAC Clyde Space, KRYTEN-M3 High Performance OBC Reference Manual, 2023.
[7] AAC Clyde Space, STARBUCK-NANO Electrical Power System Datasheet, 2023.
[8] AAC Clyde Space, TRX-U and PULSAR-HSTX Transceivers Reference Manual, 2023.
[9] AAC Clyde Space, CP400.85 Payload Processor Interface Control Document, 2023.
[10] GomSpace A/S, NanoCam C1U Datasheet, 2023.
[11] GomSpace A/S, 1U CubeSat Avionics Stack (NanoPower, NanoMind, NanoCom) Integration Manual, 2022.
