juanjodiaz04/Proyecto_Diseno_Productos/Reportes/Proyecto_Diseño_E1.pdf

# Requisitos, especificaciones y arquitectura electronica del CubeSat UD34 ´

## Juan Jose Diaz, Kevin Echeverri Universidad de Antiquia

Diseno de Productos Electr ˜ | onicos ´
1. INTERPRETACION DEL PROBLEMA ´ | , ALCANCE, LIMITES Y SUPUESTOS DEL SISTEMA

### 1.1. Interpretacion del problema ´

El proyecto consiste en desarrollar el diseno electr ˜ | onico conceptual y detallado de un nanosat ´ | elite acad ´ | emico tipo CubeSat ´
1U en el contexto del curso Diseno de Productos Electr ˜ | onicos ´ | , cuya mision principal es la adquisici ´ | on de im ´ | agenes ´
multiespectrales de regiones productoras de cafe en Colombia y la posterior transmisi ´ | on de dicha informaci ´ | on hacia una estaci ´ | on´
terrestre de referencia ubicada en Medellín. El formato 1U corresponde a una envolvente estandarizada de aproximadamente 10 cm × 10 cm × 10 cm.
La carga util principal ser ´ | a una c ´ | amara multiespectral capaz de registrar una misma regi ´ | on en diferentes bandas del espectro ´
visible e infrarrojo cercano. La informacion obtenida estar ´ | a orientada a realizar an ´ | alisis experimentales sobre la distribuci ´ | on y ´
el estado relativo de la vegetacion en lotes cafeteros, sin pretender identificar plantas individuales, diagnosticar enfermedades ´

### o generar recomendaciones agronomicas. ´

Desde la perspectiva de la ingeniería electronica, el problema consiste en definir una arquitectura que integre, dentro de las ´

### restricciones físicas y energeticas del formato 1U, los recursos necesarios para: ´

### Adquirir las imagenes multiespectrales. ´ Procesar y almacenar la informacion generada. ´ Suministrar y administrar la energía electrica. ´

Determinar y modificar la orientacion del sat ´ | elite. ´
Supervisar el estado de salud de los subsistemas (telemetría). Gestionar el intercambio de datos y comandos entre subsistemas.
Transmitir telemetría e imagenes hacia la estaci ´ | on terrestre. ´

### Recibir comandos provenientes de la estacion. ´

### 1.2. Alcance del proyecto

El alcance del proyecto comprende la definicion de la arquitectura electr ´ | | onica del CubeSat, la selecci ´ | on justificada de ´
componentes, la elaboracion de esquem ´ | aticos detallados, el enrutamiento de las tarjetas de circuito impreso (PCBs) y la ´
integracion tridimensional b ´ | asica del hardware. ´
El trabajo abarcara los siguientes subsistemas electr ´ | onicos: ´

### Carga util multiespectral. ´

Sistema de potencia y gestion de energ ´ | ía (EPS).
Procesamiento y manejo de datos (OBC).

### Determinacion y control de actitud (ADCS). ´

Sistema de comunicaciones (COMMS).

### Interconexiones electricas, buses de datos e interfaces entre PCBs. ´

El entregable final consistira en una propuesta t ´ | ecnica completamente documentada a nivel de ingenier ´ | ía, que incluye los
esquematicos, la distribuci ´ | on f ´ | ísica en PCBs, el modelo 3D de ensamblaje y los archivos de fabricacion. ´

### Quedan expresamente fuera del alcance:

La fabricacion, ensamblaje f ´ | ísico y pruebas de laboratorio de las PCBs o del satelite. ´
La implementacion del software de vuelo y de los algoritmos de control de actitud o procesamiento de im ´ | agenes. ´
El diseno o fabricaci ˜ | on de la estaci ´ | on terrestre, el dispensador o el veh ´ | ículo de lanzamiento.
La incorporacion de un sistema de propulsi ´ | on. ´
La realizacion de ensayos formales de calificaci ´ | on espacial (las condiciones ambientales como radiaci ´ | on, vac ´ | ío o ciclos
termicos se considerar ´ | an como criterios de dise ´ | no, sin requerir certificaci ˜ | on). ´

### 1.3. Límites del sistema

La frontera del sistema bajo estudio se limita exclusivamente al segmento espacial (hardware electronico alojado dentro de ´ la estructura del CubeSat 1U).

### Se consideran elementos externos fuera del límite del diseno: ˜

La estacion terrestre en Medell ´ | ín.
El vehículo de lanzamiento y el mecanismo dispensador.
Las herramientas de analisis agron ´ | omico de los datos descargados. ´
Estos elementos externos unicamente se utilizar ´ | an para derivar las interfaces, restricciones operativas y presupuestos de ´
enlace correspondientes.

### 1.4. Supuestos del sistema

Tabla I
SUPUESTOS INICIALES DEL PROYECTO CUBESAT
ID | Supuesto
S-01 | El satelite ser ´ | a un CubeSat de formato 1U. ´
S-02 | La vida util nominal del CubeSat ser ´ | a de seis meses. ´
S-03 | Se considerara una ´ | orbita aproximadamente circular, helios ´ | íncrona y a una altitud de 550 km.
S-04 | La estacion terrestre de referencia estar ´ | a ubicada en Medell ´ | ín.
S-05 | La carga util ser ´ | a una c ´ | amara multiespectral orientada al an ´ | alisis experimental de regiones productoras de caf ´ | e.´
S-06 | La energía sera generada mediante paneles solares y almacenada en bater ´ | ías recargables.
S-07 | El CubeSat contara con sensores y actuadores para determinar y modificar su orientaci ´ | on. ´
S-08 | Existira comunicaci ´ | on bidireccional entre el CubeSat y la estaci ´ | on terrestre. ´
S-09 | El satelite no contar ´ | a con un sistema de propulsi ´ | on. ´
S-10 | El software de vuelo no sera implementado durante el desarrollo del proyecto. ´
2. DEFINICION DE REQUISITOS ´

A partir del alcance, los supuestos y las restricciones previamente establecidas, se definen los requisitos tecnicos del sistema. ´ Estos se clasifican en requisitos funcionales, no funcionales, ambientales y normativos.

2.01. Criterio de prioridad: Para facilitar la evaluacion y gesti ´ | on de los requisitos, se establecen tres niveles de prioridad: ´
alta, media y baja. La prioridad asignada no depende unicamente del origen del requisito, sino del efecto que tendr ´ | ía su

### incumplimiento sobre el cumplimiento de la mision y el desarrollo del sistema. ´

Tabla II
CRITERIOS UTILIZADOS PARA LA PRIORIZACION DE REQUISITOS ´
Prioridad | Criterio
Alta | El incumplimiento del requisito impide alcanzar un objetivo principal de la mision, compromete la operaci ´ | on o seguridad ´
| del CubeSat, o produce el incumplimiento de una restriccion o norma obligatoria. ´
Media | El incumplimiento del requisito degrada el desempeno, limita alguna capacidad del sistema o reduce el margen ˜ operacional, pero no impide necesariamente alcanzar el objetivo principal de la mision. ´
Baja | El requisito representa una mejora deseable para el sistema, facilita su integracion, operaci ´ | on o desarrollo, pero su ´
incumplimiento no compromete directamente el exito m ´ | ínimo de la mision. ´

2.02. Matriz de requisitos: Los requisitos identificados se consolidan en una unica matriz con el fin de facilitar su ´
trazabilidad, revision y posterior verificaci ´ | on. Cada requisito se clasifica seg ´ | un su naturaleza como funcional, no funcional, ´
ambiental o normativo.

Tabla III: Matriz preliminar de requisitos del CubeSat

ID | Tipo | Requisito | Origen o justificacion | Prioridad Criterio de aceptaci ´ | on´
RF-01 | Funcional | El CubeSat debera adquirir im ´ | agenes ´
multiespectrales de la superficie terrestre durante el paso sobre las regiones de
interes definidas para la misi ´ | on. ´
S-05 / Objetivo de la mision. | Alta | Se deber ´ | a verificar que la arquitectura ´
de la carga util permita adquirir y ´ entregar al sistema de datos una imagen multiespectral.
RF-02 | Funcional | El CubeSat debera almacenar temporal- ´ mente los datos generados por la carga util ´ antes de su transmision a tierra. ´ | S-05 / Operacion de la carga ´ util. ´
Alta | La capacidad de almacenamiento
definida debera ser igual o superior al ´ volumen maximo de datos generado entre ´
| | | | | oportunidades de descarga.
RF-03 | Funcional | El CubeSat debera transmitir a la ´
estacion terrestre los datos de misi ´ | on y ´
| | la telemetría correspondiente al estado del satelite. ´ | S-08 / Comunicacion´ satelite–tierra. ´
Alta | El presupuesto de enlace debera demostrar ´
| | | | | la capacidad de realizar el enlace descendente durante una ventana de

comunicacion prevista. ´
RF-04 | Funcional | El CubeSat debera recibir comandos ´ provenientes de la estacion terrestre. ´ | S-08 / Comunicacion´ bidireccional.
Alta | La arquitectura de comunicaciones deberá
| | | | | contemplar un enlace ascendente capaz de recibir y entregar comandos al sistema de

manejo de datos.
RF-05 | Funcional | El CubeSat debera determinar su ´
orientacion mediante informaci ´ | on obtenida ´
| | de sensores a bordo. | S-07 / Determinacion de ´ actitud.
Alta | La arquitectura del sistema de determi-
nacion de actitud deber ´ | a disponer de ´
informacion sensorial suficiente para ´
| | | | | estimar las variables de orientacion´ requeridas por la mision. ´
RF-06 | Funcional | El CubeSat debera modificar su ´ orientacion mediante actuadores de control ´ de actitud.
S-07 / Control de actitud. | Alta | El analisis del sistema de control ´
de actitud debera demostrar que los ´
| | | | | actuadores seleccionados permiten realizar los cambios de orientacion requeridos por ´

la mision. ´
RF-07 | Funcional | El CubeSat debera generar energ ´ | ía
electrica a partir de radiaci ´ | on solar durante ´
| | los períodos de iluminacion orbital. ´ | S-06 / Generacion de ´ energía.
Alta | El presupuesto de potencia deberá
demostrar que la generacion de energ ´ | ía
| | | | | satisface las necesidades establecidas para el perfil orbital considerado.
RF-08 | Funcional | El CubeSat debera almacenar energ ´ | ía
| | electrica para alimentar sus subsistemas ´ durante los períodos en los que la generacion solar sea insuficiente. ´ | S-06 / Almacenamiento de energía.
Alta | El analisis energ ´ | etico deber ´ | a demostrar ´
que la capacidad util de almacenamiento ´
| | | | | permite cubrir el período crítico de
operacion, incluyendo los per ´ | íodos de
eclipse.
RNF-01 | No funcional La plataforma espacial debera ser capaz ´
| | de operar nominalmente en orbita baja ´ terrestre durante un período mínimo de
seis (6) meses sin degradacion cr ´ | ítica de
| | sus funciones. | S-02 / Duracion nominal de ´ la mision. ´
Alta | La seleccion y an ´ | alisis de los subsistemas ´
debera demostrar compatibilidad con una ´
duracion m ´ | ínima de mision de seis meses ´
| | | | | en el ambiente orbital considerado.
RNF-02 | No funcional El sistema electrico deber ´ | a mantener un ´
| | balance energetico no negativo para el ´ ciclo orbital nominal de la mision. ´ | S-06 / Continuidad operacional.
Alta | El presupuesto energetico de una ´ | orbita ´
representativa debera presentar una energ ´ | ía
| | | | | disponible igual o superior a la energía consumida, considerando las perdidas ´ definidas en el modelo.
RNF-03 | No funcional El sistema de comunicaciones deberá
| | proporcionar un enlace con margen positivo bajo las condiciones nominales
de comunicacion con la estaci ´ | on terrestre ´
| | de referencia. | S-04 y S-08 / Enlace de comunicaciones.
Alta | El presupuesto de enlace debera presentar ´
| | | | | un margen superior a 0 dB para las condiciones nominales adoptadas.
RNF-04 | No funcional Los subsistemas electricos deber ´ | an´
utilizar interfaces de alimentacion y datos ´ compatibles entre sí.
Integracion del sistema. | Alta | La matriz de interfaces deber ´ | a demostrar ´
compatibilidad de tension, corriente, ´ niveles electricos y protocolos entre los ´ elementos interconectados.
RA-01 | Ambiental | El hardware del CubeSat debera ser ´
compatible con la operacion en vac ´ | ío
durante la fase orbital de la mision. ´

S-03 / Ambiente espacial de operacion. ´

| Alta | | Los componentes y materiales selecciona-
dos deberan disponer de caracter ´ | ísticas
| | | documentadas compatibles con la
operacion en vac ´ | ío o de una justificacion´
tecnica para su utilizaci ´ | on. ´
Continua en la siguiente p ´ | agina ´

Continuacion de la Tabla III ´

ID | Tipo | Requisito | Origen o justificacion | Prioridad Criterio de aceptaci ´ | on´
RA-02 | Ambiental | El CubeSat debera soportar el entorno ´ termico asociado con los ciclos de ´
iluminacion y eclipse de la ´ | orbita definida ´
| | para la mision. ´ | S-03 / Entorno termico ´ orbital.
Alta | El analisis t ´ | ermico deber ´ | a demostrar ´
| | | | | que las temperaturas estimadas de los componentes permanecen dentro de sus límites admisibles durante los casos orbitales considerados.
RA-03 | Ambiental | La estructura y los componentes del
CubeSat deberan permanecer mec ´ | anica- ´
| | mente íntegros frente a las cargas previstas durante el lanzamiento y despliegue. | Entorno de lanzamiento / Seguridad.
Alta | La verificacion structural deber ´ | a demostrar ´
| | | | | compatibilidad con las cargas y niveles de
vibracion adoptados para el dise ´ | no. ˜
RA-04 | Ambiental | Los equipos electronicos cr ´ | íticos
| | del CubeSat deberan mantener su ´ funcionalidad despues de una Dosis ´ Ionizante Total de diseno de al menos ˜ TBD krad(Si). | S-02 y S-03 / Entorno de radiacion correspondiente a ´ una mision de seis meses en ´ SSO a 550 km.
Alta | El valor de TID de diseno se determinar ˜ | á
| | | | | mediante un modelo de radiacion´ orbital para una mision de seis meses ´ a 550 km, considerando el blindaje equivalente adoptado y el margen de

diseno correspondiente. La tolerancia ˜
| | | | | documentada de los elementos críticos
debera ser igual o superior a dicho valor. ´
RA-05 | Ambiental | Los componentes electronicos cr ´ | íticos
| | susceptibles a latch-up deberan presentar ´ un umbral de susceptibilidad a SEL por iones pesados igual o superior a 60 MeV cm²/mg. | S-03 / ECSS-E-ST-10- 12C, entorno de radiacion´ y efectos de evento unico. ´
Alta | Verificar documentalmente que todos los
| | | | | componentes críticos susceptibles a SEL presenten LETth ≥ 60 MeV · cm²/mg.
RN-01 | Normativo | La configuracion mec ´ | anica del sat ´ | elite ´
| | debera ser compatible con el formato ´
CubeSat 1U definido por la CubeSat Design Specification aplicable al proyecto.

S-01 / CubeSat Design
Specification Rev. 14.1.
Alta | Las dimensiones, envolvente, masa e
interfaces mecanicas del modelo deber ´ | an´
verificarse contra las especificaciones aplicables de la CubeSat Design Specification.
RN-02 | Normativo | Todas las partes del CubeSat deberan´
permanecer unidas al satelite durante ´
lanzamiento, eyeccion y operaci ´ | on. ´

CubeSat Design Specification Rev. 14.1.

Alta | El diseno mec ˜ | anico deber ´ | a demostrar que ´
los elementos del CubeSat permanecen asegurados durante las fases consideradas.
RN-03 | Normativo | Los materiales empleados en el CubeSat
| | deberan cumplir los criterios de ´ desgasificacion aplicables al ambiente ´

espacial definidos para el diseno. ˜

CubeSat Design Specification Rev. 14.1.

Alta La lista de materiales debera incluir ´ evidencia documental de cumplimiento de los criterios de desgasificacion adoptados ´ o una justificacion para las excepciones ´ identificadas.
RN-04 | Normativo | El subsistema de comunicaciones deberá
operar dentro de bandas y condiciones de
emision compatibles con la reglamentaci ´ | on´
de espectro aplicable a la mision. ´

S-08 / Regulacion de ´
comunicaciones satelitales.
Alta | La banda y los parametros de transmisi ´ | on´
seleccionados deberan contrastarse con ´
la asignacion y autorizaci ´ | on regulatoria ´
aplicable antes de establecer el disenõ definitivo.
3. ESPECIFICACIONES TECNICAS PRELIMINARES ´
Las especificaciones tecnicas se derivan de los requisitos definidos previamente y establecen los par ´ | | | | ametros necesarios ´
para orientar la arquitectura, la seleccion tecnol ´ | ogica y las interfaces entre subsistemas; los valores que dependen de an ´ | alisis ´
posteriores se identifican mediante la marca TBD (to be determined) junto con su fundamento de calculo, utilizando las ´
abreviaturas A (analisis), I (inspecci ´ | on o revisi ´ | on documental), T (ensayo) y D (demostraci ´ | on) para los m ´ | etodos previstos de ´

### verificacion. ´

| | Tabla IV: Especificaciones tecnicas preliminares del CubeSat ´

ID de especificacion´

Requisitos
asociados
Parametro t ´ | ecnico | Valor, rango o ´
tolerancia
Unidad Fundamento | Metodo ´
previsto de
verificacion´
ET-MIS-01 | RNF-01 | Vida util nominal de la ´
mision´
≥ 6 | meses | Duracion m ´ | ínima establecida en el supuesto
S-02.

A, I

ET-ORB-01 RA-02, RA-04 Altitud orbital de referencia | 550 nominal | km | Orbita adoptada en el supuesto S-03 para ´
los analisis preliminares de misi ´ | on. ´

A

ET-ORB-02 RA-02, RA-04 Configuracion orbital | SSO ´
aproximadamente
circular
– | Condicion orbital establecida en S-03. | A ´
Continua en la siguiente p ´ | agina ´

Continuacion de la Tabla IV ´

ID de especificacion´

Requisitos
asociados
Parametro t ´ | ecnico | Valor, rango o ´
tolerancia
Unidad Fundamento | Metodo ´
previsto de
verificacion´
ET-PL-01 | RF-01 | Numero de bandas ´
espectrales
TBD | – | Se determinara a partir de las bandas ´
requeridas para el analisis experimental ´ de las regiones productoras de cafe y de la ´ arquitectura de la carga util. ´

A

ET-PL-02 | RF-01 | Resolucion espacial en ´ superficie (GSD)
TBD | m/píxel Se determinara a partir del objetivo ´
de observacion, la altitud orbital y las ´
características opticas de la carga ´ | util. ´

A

ET-DAT-01 RF-01, RF-02 Volumen de datos por adquisicion´

TBD | MB | Se calculara a partir de la resoluci ´ | on del ´
| | sensor, numero de bandas, profundidad ´
de bits y esquema de procesamiento o
| | compresion adoptado. ´

A

ET-DAT-02 | RF-02 | Capacidad util m ´ | ínima de
almacenamiento
TBD | GB | Se calculara a partir del m ´ | aximo volumen ´
de datos acumulado entre oportunidades consecutivas de descarga.

A, I

ET-COM-01

RF-03 Tasa neta mínima de enlace descendente

TBD | kbps/MbpsSe calculara a partir del volumen de datos ´
que debe transmitirse y del tiempo efectivo
disponible de comunicacion con la estaci ´ | on´
terrestre.

A

ET-COM-02

RNF-03 Margen del enlace de comunicaciones

> 0 | dB | Condicion establecida por RNF-03. ´ El valor sera verificado mediante el ´ presupuesto de enlace para las condiciones nominales de mision. ´
A

ET-COM-03

RF-03, RF-04,
RN-04

Banda de operacion del ´
enlace
TBD | – | Se seleccionara considerando la tasa de ´ datos requerida, presupuesto de enlace,
disponibilidad tecnologica y regulaci ´ | on de ´
| | espectro aplicable.

A, I

ET-GS-01 | RNF-03 | Estacion terrestre de ´
referencia
Medellín | – | Ubicacion definida en el supuesto S- ´
04 para los analisis de contacto y ´ comunicacion. ´

A

ET-ADCS-01

RF-05 Error maximo de conoci- ´ miento de actitud

TBD | ◦ | Se determinara a partir de las necesidades ´
de adquisicion y georreferenciaci ´ | on de la ´
| | carga util. ´

A, D

ET-ADCS-02

RF-06 Error maximo de apunta- ´ miento

TBD | ◦ | Se determinara mediante un presupuesto de ´ apuntamiento considerando la resolucion´ espacial y el desplazamiento maximo ´ permitido sobre el terreno.
A, D
ET-EPS-01 | RF-07 | Fuente primaria de
generacion de energ ´ | ía
| | | | Solar fotovoltaica | – | Arquitectura energetica establecida en el ´ supuesto S-06.
I
ET-EPS-02 | RF-08 | Sistema de almacenamiento
| | de energía | | Batería recargable | – | Arquitectura energetica establecida en el ´ supuesto S-06.
I
ET-EPS-03 | RNF-02 | Balance energetico por ´ | orbita ´ | ∆E ≥ 0 | Wh | Derivado de RNF-02, donde ∆E = Egenerada − Econsumida.
A
ET-EPS-04 | RF-08, RNF-02 | Capacidad util m ´ | ínima de
almacenamiento de energía
| | | | TBD | Wh | Se calculara considerando el consumo ´ durante eclipse, profundidad de descarga admisible, eficiencia y perdidas del sistema. ´
A

ET-EPS-05 RF-07,
RNF-02

Potencia pico requerida por el CubeSat

TBD | W | Se obtendra mediante el presupuesto ´ de potencia considerando los modos de
operacion y las cargas simult ´ | aneamente ´
| | activas.

A

ET-INT-01 | RNF-04 | Tension nominal del bus ´
electrico principal ´
TBD | V | Se definira mediante la selecci ´ | on de la ´
arquitectura EPS y la compatibilidad de
| | alimentacion de los subsistemas. ´

A, I

ET-INT-02 | RNF-04 | Interfaces de comunicacion´
interna
TBD | – | Se estableceran despu ´ | es de definir OBC, ´
| | carga util, ADCS y comunicaciones, ´
verificando compatibilidad de niveles
| | electricos y protocolos. ´

A, I

ET-ENV-01 | RA-01 | Ambiente de operacion´ durante la fase orbital
Vacío orbital | – | Condicion ambiental derivada de la ´
operacion en ´ | orbita definida en S-03. ´

A, I

ET-TH-01 | RA-02 | Rango termico de dise ´ | no | TBD ˜
◦C | Se determinara mediante an ´ | alisis t ´ | ermico ´
para las condiciones de iluminacion y ´ eclipse de la orbita definida. ´

A

Continua en la siguiente p ´ | agina ´

Continuacion de la Tabla IV ´

ID de especificacion´

Requisitos
asociados
Parametro t ´ | ecnico | Valor, rango o ´
tolerancia
Unidad Fundamento | Metodo ´
previsto de
verificacion´
ET-STR-01 | RA-03 | Nivel de cargas y vibracio-
nes de lanzamiento
TBD | – | Se determinara utilizando el perfil del ´
proveedor de lanzamiento o el estandar ´ de verificacion ambiental adoptado para el ´ diseno. ˜

A, T

ET-RAD-01 | RA-04 | Dosis Ionizante Total de
disenõ
TBD | krad(Si) Se calculara para una misi ´ | on de seis ´
meses en SSO a 550 km, considerando el blindaje equivalente y el margen de disenõ adoptado.

A

ET-RAD-02 | RA-05 | Umbral mínimo de susceptibilidad a SEL
≥ 60 | MeV · cm²Valor establecido en RA-05 para los /mg
componentes electronicos cr ´ | íticos
susceptibles a Single Event Latch-up.

I

ET-MEC-01 | RN-01 | Configuracion mec ´ | anica | 1U | – | Formato definido por S-01 y la CubeSat ´
Design Specification Rev. 14.1.

I

ET-MEC-02 | RN-01 | Masa total maxima ´ | ≤ 2,00 | kg | Límite de masa para una configuracion´
CubeSat 1U establecido por la CubeSat Design Specification Rev. 14.1.

I

ET-MEC-03 | RN-01 | Desplazamiento maximo del ´
centro de gravedad
±20 en X, Y y Z | mm | Límites para una configuracion 1U ´
establecidos por la CubeSat Design Specification Rev. 14.1.

A, I

ET-MEC-04 | RN-01 | Protrusion m ´ | axima respecto ´
al plano de los rieles
≤ 6,5 | mm | Límite geometrico establecido por la ´
CubeSat Design Specification Rev. 14.1 para las superficies aplicables.

I

ET-MEC-05 | RN-02 | Numero permitido de ´
elementos desprendidos
0 | – | RN-02 y CubeSat Design Specification
Rev. 14.1 establecen que todas las partes deben permanecer unidas durante
lanzamiento, eyeccion y operaci ´ | on. ´

I, T

ET-MAT-01 | RN-03 | Perdida total de masa (TML) ´ | ≤ 1,0 | % | Criterio de baja desgasificacion establecido ´ por la CubeSat Design Specification Rev. 14.1.
I
ET-MAT-02 | RN-03 | Material volatil condensable ´
(CVCM)
≤ 0,1 | % | Criterio de baja desgasificacion establecido ´
por la CubeSat Design Specification Rev. 14.1.

I

4. FUNCIONES DE HARDWARE Y SOFTWARE
A partir de las funciones requeridas para el cumplimiento de la mision, se realiz ´ | o una asignaci ´ | on preliminar entre hardware ´
y software. Esta clasificacion considera los recursos electr ´ | onicos necesarios para ejecutar cada funci ´ | on y las responsabilidades ´
que debera asumir posteriormente el software de vuelo. Aunque dicho software no ser ´ | a implementado durante el proyecto, ´
esta distribucion permite estimar las necesidades de procesamiento, memoria, almacenamiento, interfaces y temporizaci ´ | on del ´
sistema.

Tabla V: Distribucion preliminar de funciones entre hardware y software ´

Funcion | Tipo de ´
implementacion´
Recursos de hardware necesarios | Responsabilidad del software futuro | Justificacion´
Adquisicion de im ´ | agenes ´
multiespectrales
Mixta | Camara multiespectral de referencia ´
con resolucion de ´ | 2048 × 1088
píxeles, profundidad de 10 bits, 15 bandas espectrales entre 600 y 860 nm e interfaz USB 3.0.
Configurar los parametros de exposici ´ | on, ´
iniciar la adquisicion, recibir los datos, ´ asociar marcas temporales y detectar errores durante la captura.

RF-01. La adquisicion´
requiere tanto el sensor
físico como el control
y gestion digital de la ´
captura. Una imagen ocupa
aproximadamente 4,46 MB
al almacenarse a 16 bits
por píxel.
Procesamiento de datos
de la carga util ´
Software | Procesador dedicado para carga util. ´
Como referencia se considera el AAC Clyde Space CP400.85, con procesador ARM, aproximadamente 512 MB de RAM y capacidad de almacenamiento masivo.

Gestionar los datos adquiridos, generar metadatos, verificar integridad y realizar
operaciones de preparacion o compresi ´ | on´
antes del almacenamiento o transmision. ´

La funcion es principal- ´ mente algorítmica. El
procesador constituye el
recurso físico sobre el cual se ejecutara el software de ´ procesamiento.
Continua en la siguiente p ´ | agina ´

Continuacion de la Tabla V ´

Funcion | Tipo de ´
implementacion´
Recursos de hardware necesarios | Responsabilidad del software futuro | Justificacion´

Almacenamiento de
imagenes ´
Mixta | Memoria no volatil con capacidad ´
util m ´ | ínima de 4 GB y una interfaz
de almacenamiento compatible con el procesador de carga util. ´

Administrar archivos o bloques de datos, controlar la ocupacion, verificar integridad ´ mediante CRC y eliminar los datos descargados correctamente.

RF-02. La memoria
realiza físicamente
el almacenamiento,
mientras que el software
administra la organizacion´ e integridad de la
informacion. ´
Buffer temporal de
imagenes ´
Software | Memoria RAM disponible mínima
de 16 MB para la cadena de adquisicion. ´

Gestionar buffers de entrada y salida, controlar transferencias entre la camara, RAM ´
y memoria no volatil y evitar p ´ | erdida de ´
informacion. ´

La funcion corresponde ´
principalmente a gestion´
de memoria. Una imagen
requiere aproximadamente
4,46 MB y un doble
buffer aproximadamente
8,92 MB, por lo que
se adopta un mínimo de
16 MB.

Control y coordinacion´
central del CubeSat
Software | Computador de a bordo. Como
referencia se considera el AAC Clyde Space KRYTEN-M3, con procesador ARM Cortex-M3, memoria no volatil ´ y buses I²C, SPI, UART, CAN, RS-422 y LVDS.
Ejecutar la maquina de estados de misi ´ | on, ´
coordinar subsistemas, gestionar modos de operacion, procesar eventos y ejecutar las ´ acciones asociadas a los comandos recibidos.

La coordinacion del ´
sistema depende principalmente de la logica del ´ software de vuelo; el OBC
proporciona unicamente los ´ recursos computacionales
necesarios.
Temporizacion y ´
referencia temporal
Mixta | RTC, oscilador de referencia y
temporizadores disponibles en el computador de a bordo.

Mantener el tiempo de mision, generar marcas ´
temporales para imagenes y telemetr ´ | ía y
programar eventos de operacion. ´

El hardware proporciona
la referencia temporal y
el software la utiliza para sincronizar los eventos de mision. ´
Deteccion y recuperaci ´ | on´
ante fallos
Mixta | Watchdog hardware, supervisores
de alimentacion, protecciones del ´ EPS e interruptores electronicos ´ controlables.

Detectar condiciones anomalas, registrar ´ eventos, reiniciar subsistemas y llevar el satelite a un estado seguro cuando sea ´ necesario.

Combina mecanismos
autonomos de protecci ´ | on´
en hardware con estrategias de deteccion y recupe- ´
racion implementadas ´
mediante software.
Recepcion de comandos ´
críticos
Mixta | Transceptor UHF. Como referencia
se considera el AAC Clyde Space TRX-U dentro del rango de 370–470 MHz, con una tasa nominal adoptada de 9,6 kbps.

Validar la integridad de las tramas recibidas, interpretar los comandos y generar las acciones correspondientes sobre los subsistemas.

RF-04. El transceptor
realiza la recepcion f ´ ísica, mientras que el software
interpreta y ejecuta el
contenido del comando.
Transmision de telemetr ´ | ía | Mixta | Transceptor UHF TRX-U o
equivalente, con tasa nominal de 9,6 kbps y conexion digital con el ´ OBC.

Construir paquetes de housekeeping con tensiones, corrientes, temperaturas, estados, alarmas y eventos, y gestionar su envío.

RF-03. El software genera
y organiza la telemetría
mientras el hardware
realiza el enlace físico
de radiofrecuencia.
Transmision de im ´ | agenes | Mixta | Transmisor de alta velocidad en ´
banda S. Como referencia se considera el AAC Clyde Space PULSAR-HSTX-C, dentro de 2.2– 2.3 GHz y con capacidad de hasta aproximadamente 8 Mbps.

Fragmentar las imagenes, organizar los ´ paquetes, gestionar la cola de transmision´ y mantener registro de la informacion´ descargada.

RF-03. Se establece una
tasa neta mínima inicial
de 1 Mbps. A 8 Mbps,
una imagen de 4,46 MB
requiere aproximadamente
4,46 s de transmision´
teorica. ´
Determinacion de actitud | Mixta | Magnet ´ | ometro, sensores solares y ´
sensores inerciales. Como referencias iniciales se consideran dispositivos AAC Clyde Space MM200 y SS200.

Adquirir y calibrar las mediciones y ejecutar posteriormente el algoritmo de estimacion de ´
orientacion del sat ´ | elite. ´

RF-05. Los sensores
proporcionan las
mediciones físicas,
mientras que el software
realiza la estimacion de ´ actitud.
Control de actitud | Mixta | Actuadores de actitud y electronica ´
de potencia asociada. Como referencia preliminar se consideran ruedas de reaccion AAC Clyde Space ´ RW222 y magnetorquers compatibles con una plataforma 1U.

Calcular las acciones de control, generar consignas para los actuadores y gestionar
maniobras de orientacion y desaturaci ´ | on. ´

RF-06. El software
determina la accion de ´
control y los actuadores
generan físicamente el
torque requerido.
Continua en la siguiente p ´ | agina ´

Continuacion de la Tabla V ´

Funcion | Tipo de ´
implementacion´
Recursos de hardware necesarios | Responsabilidad del software futuro | Justificacion´
Generacion de energ ´ | ía
electrica ´

Hardware Paneles solares fotovoltaicos, acondicionamiento de entrada, MPPT
y electronica de conversi ´ | on asociada ´
al EPS.

Supervisar variables de operacion y reportar ´ el estado energetico del subsistema. ´

RF-07. La conversion de ´
energía solar en energía
electrica es una funci ´ | on´
realizada directamente
por elementos físicos y
electronicos. ´
Almacenamiento y
distribucion de energ ´ | ía
Hardware | Batería recargable, convertidores
DC/DC, circuitos de proteccion´ y distribucion de potencia. Como ´ referencia preliminar se considera la familia AAC Clyde Space STARBUCK-NANO para CubeSat 1U, con buses de 3.3 V, 5 V y 12 V.

Supervisar el estado de la batería y ordenar la
activacion o desactivaci ´ | on de cargas seg ´ | un el ´
modo de operacion. ´

RF-08 y RNF-02. La
batería, convertidores y
elementos de distribucion´ realizan físicamente
el almacenamiento y
suministro de energía.

Supervision del sistema ´
de potencia
Mixta | Sensores de tension, corriente y ´
temperatura integrados o asociados al EPS, ADC y circuitos de proteccion. ´

Leer las variables electricas, generar ´ telemetría, detectar condiciones anomalas ´ y ordenar la desconexion de cargas cuando ´ corresponda.

Los sensores realizan
las mediciones físicas
y el software utiliza
dicha informacion para ´
supervisar el estado
energetico y tomar ´
decisiones de operacion. ´
| 5. ARQUITECTURA ELECTRONICA DEL ´ | | SISTEMA

### 5.1. Subsistemas del CubeSat

Para cumplir con los objetivos de la mision dentro del formato 1U, la arquitectura electr ´ | onica se divide en los siguientes ´

### bloques funcionales:

Carga Util (PL): ´ | Camara multiespectral. ´
Gestion de Potencia (EPS): ´ | Generacion, almacenamiento y distribuci ´ | on de energ ´ | ía.

### Computador de a Bordo (OBC): Procesamiento, manejo de datos y coordinacion central. ´

Determinacion y Control de Actitud (ADCS): ´ | Sensores y actuadores de orientacion. ´

### Comunicaciones (COMMS): Enlace bidireccional de telemetría y descarga de imagenes. ´

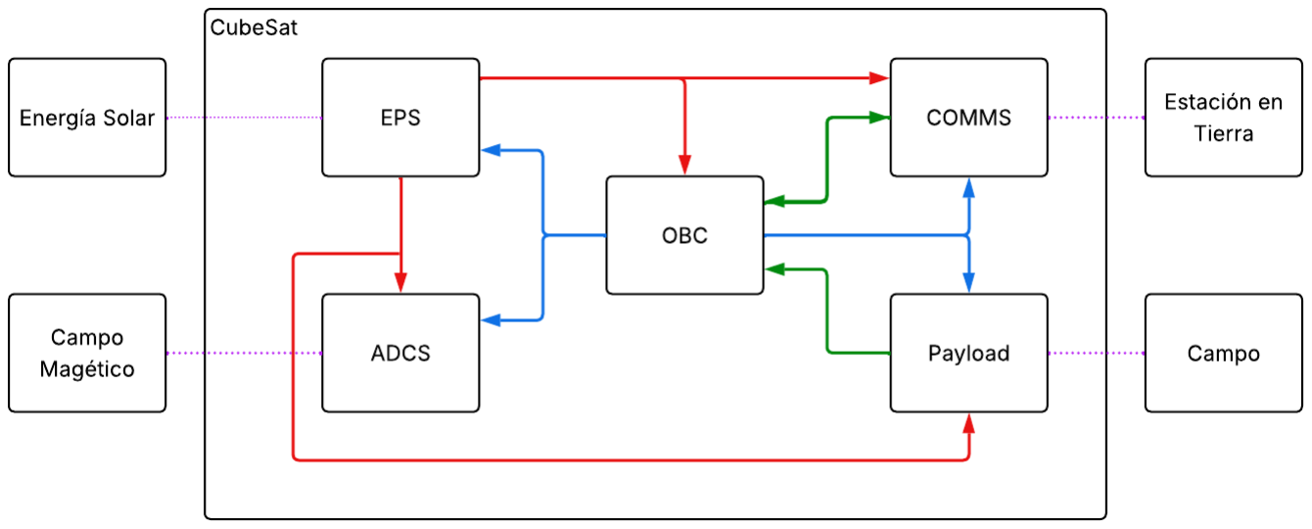
[picture p1: figure]

Figura 1. Diagrama de Bloques

Como se observa en la Figura ??, el Computador de a Bordo (OBC) actua como el nodo central del sistema. Los flujos de ´
potencia (líneas rojas en el diagrama) parten del EPS hacia todos los bloques para su energizacion. Los flujos de ´ | control y
telemetría (líneas azules) conectan el OBC bidireccionalmente con el EPS, ADCS, COMMS y la Carga Util. Finalmente, los ´ flujos de datos de alta velocidad (líneas verdes) se trazan de manera independiente desde la camara multiespectral hacia el ´
OBC para su procesamiento, y desde el OBC hacia el modulo de comunicaciones para su descarga a la estaci ´ | on terrestre. ´

### 5.2. Alternativas de Arquitectura

Durante la fase de diseno conceptual, se definieron y evaluaron diferentes alternativas arquitect ˜ | onicas para los subsistemas ´
críticos del CubeSat 1U, considerando las severas restricciones de potencia, masa y volumen establecidas por los supuestos
de la mision. El an ´ | alisis se centr ´ | o en cuatro ´ | areas fundamentales: el procesamiento central, el control de actitud, los buses de ´
comunicacion interna y la partici ´ | | on f ´ | ísica del hardware.

5.21. Arquitectura de Procesamiento y Manejo de Datos (OBC y PL): Para la captura de imagenes multiespectrales y el ´ control general de la plataforma, se evaluaron tres enfoques de procesamiento de hardware:
Microcontrolador (MCU) tradicional: Presenta un consumo de potencia estatico muy bajo y facilita la implementaci ´ | on´
de maquinas de estado para el software de vuelo. Sin embargo, carece del paralelismo y ancho de banda en memoria ´ necesarios para adquirir, procesar y comprimir eficientemente el gran volumen de datos de una camara multiespectral de ´ 2048 × 1088 píxeles y 15 bandas en tiempo real.
Arreglo de Compuertas Programables (FPGA) puro: Ofrece capacidad de procesamiento paralelo determinista, ideal
para el manejo masivo de la carga util ´ | optica. Su principal desventaja es el elevado consumo de potencia est ´ | atica (corriente ´
de leakage) y la complejidad de implementar tareas secuenciales de alto nivel (protocolos de red, telemetría y supervision´ de fallos).
Arquitectura Híbrida System-on-Chip (SoC): Integra un nucleo de procesamiento r ´ | ígido (ej. ARM Cortex) junto con
una matriz reprogramable FPGA en un mismo silicio. Esta topología permite delegar la telemetría y el control permanente a la MCU operando en modos de ultra bajo consumo, habilitando el encendido de la porcion FPGA de manera intermitente ´

### y exclusiva durante las ventanas de captura de la camara. ´

5.22. Actuadores para el Control de Actitud (ADCS): Considerando que la mision exige la orientaci ´ | on de la c ´ | amara hacia ´
regiones cafeteras en Colombia sin necesidad de apuntar a plantas individuales ni alcanzar resoluciones microscopicas, se ´
plantearon dos alternativas tecnologicas de actuaci ´ | on: ´
Ruedas de reaccion ( ´ | Reaction Wheels): Proporcionan alta agilidad y precision de apuntamiento (t ´ | ípicamente < 0,1

◦
).
No obstante, requieren motores continuos que consumen entre 1,0W y 2,0W, lo cual compromete de forma directa el
balance energetico de un CubeSat 1U (cuya generaci ´ | on m ´ | axima ronda los ´ | 2,5W), ademas de ocupar un volumen y masa ´
sustanciales dentro del chasis.
Actuacion puramente magn ´ | etica ( ´ | Magnetorquers): Emplea bobinas electromagneticas ortogonales para interactuar con ´
el campo magnetico terrestre y generar torques de control. Ofrecen una precisi ´ | on moderada ( ´ | 2

◦
a 5

◦

### ), que resulta suficiente

para la toma de imagenes experimentales agron ´ | omicas a ´ | 550 km de altitud, con consumos transitorios del orden de los
milivatios y la ventaja mecanica de poder integrarse directamente embebidos en las capas de las tarjetas de circuito ´ impreso (PCBs).
5.23. Buses de Comunicacion Interna: ´ | Para el intercambio de datos de telemetría y el enrutamiento de las imagenes entre la ´
carga util, el OBC y los m ´ | odulos de radiofrecuencia (UHF y Banda S), se analizaron los siguientes est ´ | andares de interconexi ´ | on: ´
SpaceWire (ECSS-E-ST-50-52C): Estandar espacial de alta velocidad ( ´ | > 2 Mbps). Aunque es ideal y normativo para el
manejo masivo de datos de cargas utiles complejas, requiere 8 hilos f ´ | ísicos (senalizaci ˜ | on diferencial LVDS bidireccional) ´
por enlace punto a punto. Su implementacion exige recursos l ´ | ogicos considerables y satura la densidad de pines de los ´
conectores apilables (PC/104) limitados en el formato 1U.
Topología Mixta (CAN Bus + Interfaces Dedicadas): Consiste en desplegar un bus de campo determinista, robusto y multipunto (CAN) para la red de telemetría, gestion del sistema de potencia (EPS) y comandos de baja velocidad ´ (ocupando solo 2 hilos compartidos); y reservar buses locales dedicados (SPI Quad/Octal o MIPI CSI-2) exclusivamente
para la interconexion directa de alta velocidad entre el sensor de la c ´ | amara y la FPGA del procesador. ´
5.24. Particion F ´ | ísica del Hardware (Division de PCBs): ´ | Dada la estricta limitacion de volumen del formato 1U ( ´ | 10 ×
10 × 10 cm) y el requerimiento de alojar el tren optico de la c ´ | amara y el paquete de bater ´ | ías, se evaluaron dos alternativas

### para el apilamiento de las tarjetas internas:

Alta Modularidad (3 o 4 PCBs): Asigna una tarjeta independiente a cada subsistema principal (EPS, OBC, COMMS,
ADCS). Maximiza el aislamiento frente a interferencias electromagneticas (EMI) y facilita el desarrollo y depuraci ´ | on´
individual de cada modulo. Sin embargo, satura la envolvente vertical (eje Z), incrementa la masa total y multiplica los ´ puntos de falla potenciales en los conectores de apilamiento ante las vibraciones del lanzamiento.
Alta Integracion (2 PCBs): ´ | Propone consolidar el sistema en dos tarjetas: una dedicada exclusivamente a la etapa de
potencia y baterías (EPS) para aislar el ruido de los reguladores conmutados, y otra altamente integrada que agrupa el
computo (OBC), las radios (COMMS), el control de actitud (ADCS) y la interfaz de la carga ´ | util. Esta topolog ´ | ía libera
espacio crítico vertical y minimiza la cantidad de conectores de transito, a cambio de requerir un dise ´ | no de ruteo de ˜

### pistas y apantallamiento RF mucho mas riguroso. ´

5.3. Comparacion y Selecci ´ | on de Arquitectura ´
Para la seleccion definitiva de las tecnolog ´ | ías a implementar en los subsistemas críticos, se utilizo una matriz de decisi ´ | on´
ponderada (escala de 1 a 5, donde 5 es el desempenõ optimo). Los pesos se asignaron en funci ´ | on de las restricciones m ´ | as´
severas del formato 1U: consumo de potencia, volumen disponible y requerimientos de la mision. ´

Tabla VI: Matriz de comparacion y selecci ´ | on de alternativas de arquitectura ´
Criterio | Peso | Alternativa A | Alternativa B | Justificacion de la valoraci ´ | on´
Decision 1: Procesamiento Central – A: SoC H ´ | íbrido (MCU+FPGA) — B: MCU Tradicional

Capacidad de procesamiento paralelo

40 % | 5 | 1 | La matriz FPGA del SoC (Alt A) permite adquirir
la rafaga de im ´ | agenes a alta velocidad; un MCU ´
tradicional (Alt B) carece del ancho de banda y paralelismo para esta carga masiva.
Consumo de potencia
estatica ´
35 % | 4 | 5 | El MCU puro (Alt B) consume menos energía. Sin
embargo, el SoC (Alt A) permite apagar por completo la FPGA en reposo, logrando un consumo competitivo. Complejidad de hardware
(Area PCB) ´
25 % | 5 | 4 | El SoC (Alt A) integra procesador y logica programa- ´
ble en un solo encapsulado, ahorrando espacio crítico frente a soluciones discretas o pines adicionales.
Puntaje Ponderado | 100 % | 4.65 | 2.15 | Seleccion: Alternativa A (SoC H ´ | íbrido - SmartFu-
| | | | sion2).
Decision 2: Actuadores ADCS – A: Magnetorques — B: Ruedas de Reacci ´ | on´

Consumo de potencia
(Pico/Nominal)
40 % | 5 | 1 | Los magnetorques (Alt A) consumen < 0,2W por
impulsos. Las ruedas de reaccion (Alt B) consumen ´ > 1W continuos, excediendo el presupuesto de 1U. Precision de apuntamien- ´ to
30 % | 3 | 5 | Las ruedas (Alt B) logran precisiones < 0,1
| | | | | ◦. Los
magnetorques (Alt A) logran 2
| | | | | ◦ − 5 ◦, valor aceptable
| | | | ya que la mision agr ´ | ícola no requiere resolucion´
| | | | microscopica. ´
Impacto en volumen y
masa
30 % | 5 | 1 | Los magnetorques (Alt A) pueden embeberse en las
capas de la PCB sin ocupar volumen interno. Las ruedas (Alt B) ocupan gran parte del centro del satelite. ´
Puntaje Ponderado | 100 % | 4.40 | 2.20 | Seleccion: Alternativa A (Magnetorques). ´

Decision 3: Buses Internos – A: CAN + Interfaz Local Dedicada — B: SpaceWire ´

Ahorro de pines y
recursos logicos ´
| 40 % | 5 | 1 | CAN (Alt A) utiliza solo 2 hilos compartidos y el controlador ya esta en el SoC. SpaceWire (Alt B) exige ´ 8 hilos por enlace punto a punto y consume mucha logica FPGA. ´
Velocidad para carga util | 30 % | 4 | 5 | SpaceWire (Alt B) es superior para redes masivas ´
| | | | espaciales. Alt A compensa conectando la camara ´ directamente a la FPGA por SPI/MIPI para un flujo local sin saturar el bus CAN.
Escalabilidad de telemetría | 30 % | 5 | 3 | El bus CAN (Alt A) es multipunto y permite agregar
nodos facilmente en la misma l ´ | ínea. SpaceWire (Alt B)
| | | | requeriría implementar un router complejo en la FPGA.
Puntaje Ponderado | 100 % | 4.70 | 2.80 | Seleccion: Alternativa A (Bus CAN + Bus ´ Dedicado).
Decision 4: Divisi ´ | on F ´ | ísica (PCBs) – A: 2 PCBs (Alta Integracion) — B: 3 PCBs (Modularidad) ´
Modularidad y facilidades de prueba (AIV) | 35 % | 2 | 5 | Un apilado modular de 3 tarjetas (Alt B) permite energizar, depurar y validar de forma independiente el EPS, el OBC/RF y la Carga Util/ADCS antes del ´ ensamblaje. En 2 PCBs (Alt A), la depuracion de ´ bloques aislados es altamente compleja.

Aislamiento electro-
magnetico y de se ´ | nal ˜
(EMI/EMC) | 25 % | 3 | 5 | Separar los subsistemas en tarjetas independientes (Alt
B) previene el acoplamiento de ruido de conmutacion´
| | | | del EPS y la interferencia de RF sobre los sensores delicados del ADCS y el sensor de la camara. ´
Compatibilidad con el volumen interno (Eje Z) | 25 % | 5 | 4 | Aunque 2 PCBs (Alt A) liberan mas espacio vertical, ´ un apilado de 3 PCBs (Alt B) ocupa solo ≈ 34,8 mm en el eje Z, garantizando espacio suficiente (≈ 55 mm) para las baterías y el lente de la camara. ´
Confiabilidad y densidad de interconexion´ | 15 % | 4 | 3 | Alt A minimiza conectores de transito. Alt B requiere ´ conectores de apilamiento estandar (ej. PC/104), pero ´ este impacto se mitiga gracias a la amplia herencia de vuelo de la plataforma modular 1U.
Puntaje Ponderado | 100 % | 3.30 | 4.45 | Seleccion: Alternativa B (3 PCBs - Arquitectura ´ Modular).

### 5.4. Definicion Detallada de la Arquitectura ´

5.41. Subsistemas del Cubesat: La arquitectura electronica del CubeSat UD34 consolida las funciones de misi ´ | on en m ´ | odulos ´
de hardware estandarizados para el formato 1U. A partir de la seleccion tecnol ´ | ogica previa, el sistema se compone de los ´

### siguientes bloques funcionales:

Computo Central y Carga ´ | Util (OBC/PL): ´ | Basado en una arquitectura SoC híbrida (tipo SmartFusion2, con referencias
de rendimiento similares al CP400.85 y KRYTEN-M3). El nucleo ARM gestiona la m ´ | aquina de estados, el sistema de ´
archivos y la telemetría, mientras que la FPGA integrada se enciende de manera dedicada para procesar la rafaga de ´
imagenes proveniente de la c ´ | amara multiespectral (resoluci ´ | on´ 2048 × 1088, 15 bandas).
Gestion de Potencia (EPS): ´ | Sistema compatible con la arquitectura STARBUCK-NANO, encargado del seguimiento del
punto de maxima potencia (MPPT) de los paneles solares, carga del pack de bater ´ | ías cilíndricas y distribucion de buses ´
regulados de 3,3 V y 5 V con proteccion LCL ( ´ | Latch-up Current Limiter).
Control de Actitud (ADCS): Compuesto por tres magnetorques ortogonales gobernados por puentes H, eliminando el
volumen de las ruedas de reaccion. Se apoya en la estimaci ´ | on vectorial de un magnet ´ | ometro (referencia MM200), sensores ´
solares (referencia SS200) y un giroscopio MEMS para estabilizar el satelite hacia el Nadir. ´
Comunicaciones (COMMS): Sistema dual. Un transceptor UHF (referencia TRX-U) operando a 9,6 kbps maneja la telemetría crítica y recepcion de comandos. Un transmisor en Banda S (referencia PULSAR-HSTX-C) operando en el ´

### rango de 2,2 − 2,3 GHz descarga el volumen masivo de datos agronomicos. ´

5.42. Division de la PCB: ´ | Para cumplir con las restricciones del formato 1U (10×10×10 cm) garantizando modularidad,
aislamiento frente a interferencias electromagneticas (EMI) y facilidad de pruebas (AIV), el hardware se divide f ´ | ísicamente
en tres (3) tarjetas de circuito impreso (PCBs) apiladas longitudinalmente en el eje Z mediante conectores estandarizados tipo PC/104:
1. PCB 1 (Sistema de Potencia - EPS): Ubicada en la base del satelite. A ´ | ísla el ruido de conmutacion de los convertidores ´
DC/DC de los demas subsistemas. Integra el empaquetado de bater ´ | ías, los reguladores MPPT y las interfaces hacia los
interruptores de despliegue (kill-switches).
2. PCB 2 (Computo Central y Comunicaciones - OBC+COMMS): ´ | Tarjeta intermedia de alta densidad. Alberga el
SoC principal (SmartFusion2), memorias asociadas y los modulos de radiofrecuencia (UHF y Banda S) debidamente ´

### apantallados para evitar acoplamientos con la logica digital. ´

3. PCB 3 (Carga Util y Actitud - PL+ADCS): ´ | Ubicada en la cara superior apuntando al Nadir. Aloja el sensor de la
camara multiespectral, los sensores de orientaci ´ | on inercial y magn ´ | etica (alejados del ruido de corrientes del EPS), y la ´
etapa de potencia de control (drivers PWM) para los magnetorques.
5.43. Interfaces de datos y control: La siguiente tabla define las interconexiones electricas transversales a trav ´ | es del bus ´
de apilamiento PC/104 y las líneas dedicadas que enlazan las 3 PCBs, ajustada al formato de especificacion de interfaces ´ requerido.

Tabla VII: Matriz de interfaces de datos y control del CubeSat

ID | Origen | Destino | Funcion | Se ´ | nal o ˜
protocolo

Características
electricas prelimi- ´
nares

Tasa o volumen
de datos

Observaciones

IF-01 PCB 1
(EPS)

PCB 2
(OBC)

Telemetría del
sistema de potencia
y comandos de
carga
Bus CAN | Diferencial, niveles
logicos de ´ | 3,3 V
(CAN Transceiver)

500 kbps
(Nominal)

Ocupa solo 2 pines en
el bus de apilamiento
vertical.
IF-02 | PCB 3 (PL) | PCB 2 (OBC)

Transmision´
de imagenes ´
multiespectrales
capturadas

Sub-LVDS /
MIPI CSI-2

Diferencial de
baja tension, pares ´
enrutados con
impedancia controlada
(100 Ω)

≈ 7,37 MB por
frame capturado

Enlace de alta
velocidad directo a
los pines de la FPGA
para evitar cuellos de
botella.
IF-03 | PCB 2 (OBC) | Memoria (PCB 2)

Almacenamiento
masivo temporal de
imagenes ´

SPI Quad /
Octal

Single-ended, niveles
logicos CMOS de ´
3,3 V

> 100 Mbps Conexion local ´ dentro de la misma
placa para minimizar
interferencias EMI.
Continua en la siguiente p ´ | agina ´

Continuacion de la Tabla VII ´

ID | Origen | Destino | Funcion | Se ´ | nal o ˜
protocolo

Características
electricas prelimi- ´
nares

Tasa o volumen
de datos

Observaciones

IF-04 PCB 3
(ADCS)

PCB 2
(OBC)

Lectura de vectores
del magnetometro ´
y sensores solares

I

2C / SPI Single-ended, bus compartido con
resistencias pull-up,
3,3 V

400 kbps (I

2C
Fast Mode)

Los sensores se ubican
en la placa superior
para alejarlos de las
corrientes del EPS.

IF-05 PCB 2
(OBC)

PCB 3
(ADCS)

Senales de ˜
control hacia
los actuadores
magneticos ´

PWM (Digital) Senales digitales de ˜ 3,3 V dirigidas a las
compuertas de los
puentes H

10 kHz−50 kHz
(Frecuencia de
conmutacion) ´

Modulacion generada ´
por los temporizadores
del ARM Cortex.

IF-06 PCB 2
(OBC)

COMMS
(UHF)

Transmision de ´
paquetes de estado
(housekeeping) y
comandos

UART / SPI Single-ended, UART a 3,3 V

9,6 kbps Interfaz crítica y de ultra bajo consumo
hacia el transceptor
TRX-U.

IF-07 PCB 2
(OBC)

COMMS
(Banda S)

Descarga de
carga util hacia ´
la estacion terrestre ´
LVDS | Diferencial de baja
tension ( ´ | 100 Ω
de impedancia
característica)

1 Mbps −
8 Mbps

El transmisor de
Banda S se enciende
unicamente durante el ´
pase sobre Medellín.
5.44. Conexiones con Perifericos: ´ | La interaccion directa de los subsistemas internos con el entorno f ´ | ísico, las antenas y

### las caras estructurales de la plataforma 1U se detalla a continuacion. ´

Tabla VIII: Matriz de conexiones con perifericos ´

Periferico / M ´ | odulo | Subsistema | Tipo de Conexi ´ | on | Funci ´ | on y Descripci ´ | on´

Paneles Solares
(Caras X, Y, Z)
EPS (PCB 1) | Potencia (DC) | Arneses de cableado directo desde las caras
estructurales hacia los reguladores MPPT en la tarjeta de potencia.
Pack de Baterías | EPS (PCB 1) | Potencia y Termica | Conexi ´ | on de potencia bidireccional y lectura del ´
termistor interno para monitoreo y proteccion´ contra temperaturas extremas en vacío. Sensor Optico ´
(Lente)
Carga Util (PCB 3) ´ | Optico-Mec ´ | anica | Integraci ´ | on del tren ´ | optico acoplado f ´ | ísicamente
sobre el sensor multiespectral en la PCB 3, alineado con la ventana del chasis. Magnetorques
Triaxiales
ADCS (PCB 3) | Potencia de Control Cables enrutados desde los puentes H en la tarjeta
superior hacia las bobinas con nucleo magn ´ | etico ´
montadas en la estructura.
Antena UHF
Desplegable
COMMS (PCB 2) | Radiofrecuencia | Cable coaxial micro-RF (U.FL a SMA) de 50 Ω
hacia el mecanismo de despliegue en la cara de radiacion UHF. ´
Antena Banda S
(Parche)
COMMS (PCB 2) | Radiofrecuencia | Línea coaxial rígida de baja perdida en ´ | 2,4 GHz
hacia el arreglo de parche direccional en la cara externa de transmision. ´
Microinterruptores
(Kill-Switches)
EPS (PCB 1) | Senal Discreta | Conectores dedicados para los switches mec ˜ | anicos ´
de los rieles que aíslan la batería mientras el satelite permanece en el P-POD. ´
6. PRESUPUESTOS PRELIMINARES
Una vez definida la arquitectura electronica preliminar del CubeSat UD34, se realiz ´ | o una estimaci ´ | on de los principales ´
recursos requeridos por el sistema. El objetivo de estos presupuestos no es establecer valores definitivos, sino comprobar que las decisiones realizadas para los subsistemas de potencia, procesamiento, almacenamiento, comunicaciones, carga util y control ´ de actitud sean compatibles con las restricciones de una plataforma CubeSat 1U.

Las estimaciones se realizaron considerando la arquitectura seleccionada: un sistema de tres PCBs, un computador central basado en un SoC híbrido tipo SmartFusion2, un sistema de control de actitud basado en magnetorques, un enlace UHF
para telemetría y comandos, un enlace en banda S para la descarga de imagenes y un EPS con generaci ´ | on fotovoltaica y ´

almacenamiento mediante baterías recargables.

### 6.1. Presupuesto preliminar de masa

La masa maxima adoptada para el CubeSat 1U es de ´ | 2 kg. A partir de los componentes de referencia y de estimaciones
preliminares para aquellos elementos que todavía no han sido seleccionados de manera definitiva, se obtiene el presupuesto mostrado en la Tabla IX.

Tabla IX
PRESUPUESTO PRELIMINAR DE MASA
Elemento | Masa [g] Fuente de estimacion´
Estructura CubeSat 1U | 180 | Estimacion preliminar ´
EPS STARBUCK-NANO | 86 | Referencia comercial
Pack de baterías | | 100 | | Estimacion preliminar ´
Paneles solares | | 150 | | Estimacion preliminar ´
OBC + memorias | | 100 | | SmartFusion2 / Kryten-M3
Transceptor UHF | 140 | TRX-U
Transmisor Banda S | 70 | Transmisor S-band
| | | | equivalente
Camara + sistema ´ | optico | 180 | Estimaci ´ | on preliminar ´
Sensores ADCS | | 40 | | MM200 + SS200 + IMU
Tres magnetorques | | 42 | | ≈ 14 g por eje
Antenas y mecanismos | 80 | Estimacion preliminar ´
Cableado y conectores | 70 | Margen de integracion´
Masa estimada | 1138 | –
Margen de diseno (20 %) | 228 | – ˜
Masa total con margen | 1366 | –
Margen respecto a 2 kg | 634 | –

La masa preliminar obtenida es de aproximadamente 1,14 kg antes de aplicar margen. Considerando un margen de disenõ del 20 %, se obtiene una masa de aproximadamente 1,37 kg, por debajo del límite de 2 kg establecido para el diseno. Esto deja ˜
aproximadamente 0,63 kg disponibles para variaciones posteriores en la carga util, bater ´ | ías, estructura, cableado y mecanismos.

### 6.2. Presupuesto preliminar de potencia y energía

El presupuesto energetico se construy ´ | o considerando un per ´ | íodo orbital preliminar de 95,5 minutos para una orbita LEO ´
cercana a 550 km. Debido a que varios subsistemas no operan de manera continua, se introduce un ciclo de actividad Di para cada carga.

### La energía consumida por un subsistema durante una orbita se estima mediante ´

Ei = PiDiTorb, | (1)

donde Pi corresponde a la potencia nominal durante el estado activo, Di corresponde al ciclo de actividad estimado y

Torb =

95,5
60
≃ 1,592 h. | (2)

La Tabla X presenta el presupuesto preliminar de potencia y recursos de los principales subsistemas.

### La potencia media equivalente del CubeSat puede calcularse mediante

Pmedia =

∑︂

i

### PiDi

, | (3)

### obteniendose aproximadamente ´

Pmedia ≃ 1,07 W. | (4)

### La energía requerida durante una orbita es entonces aproximadamente ´

Econs ≃ 1,70 Wh/orbita. | (5)
Para una estimacion inicial se considera una potencia solar disponible de ´ | 2,5W durante iluminacion, una fracci ´ | on iluminada ´
de aproximadamente 0.62 y una eficiencia global de almacenamiento y conversion del 85 %. La energ ´ | ía util generada por ´ | orbita ´

### puede estimarse como

Tabla X
PRESUPUESTO PRELIMINAR DE POTENCIA Y RECURSOS
Subsistema | Potencia nominal [W]
Potencia
maxima ´
[W]

Ciclo de
actividad
estimado

Energía
estimada
[Wh/orbita] ´

Masa
estimada [g]

Volumen
asignado
[cm³
]

Fuente de la estimacion´

EPS | 0.15 | 0.25 | 100 % | 0.239 | 186 | 260 | | STARBUCK-NANO + batería
OBC + memoria | 0.40 | 0.80 | 100 % | 0.637 | 100 | 55 | | Kryten-M3 / SmartFusion2
Carga util | 1.50 | 2.00 | 2 % | 0.048 | 180 | 150 | C ´ | amara multiespectral ´
Sensores ADCS | 0.20 | 0.30 | 100 % | 0.318 | 40 | 30 | | MM200 + SS200 + IMU
Magnetorques | 0.45 | 0.75 | 25 % | 0.179 | 42 | 30 | | Tres actuadores magneticos ´
COMMS UHF | 0.50 | 3.00 | 10 % | 0.080 | 140 | 76 | | TRX-U
COMMS Banda S | 2.50 | 3.00 | 5 % | 0.199 | 70 | 36 | | Transmisor S-band
Total | – | – | – | 1.70 | 758 | 637 | –
Egen = PsolarDsolTorbη. | (6)

Por lo tanto,

Egen = (2,5)(0,62)(1,592)(0,85) ≃ 2,10 Wh/orbita. | (7)

### El balance energetico preliminar resulta ´

∆E = Egen − Econs ≃ 0,40 Wh/orbita, | (8)

### lo que representa un margen energetico aproximado de ´

ME =

∆E

Econs

× 100 ≃ 23,5 %. | (9)

El resultado preliminar satisface el criterio de mantener un balance energetico no negativo, ´

∆E > 0 | . | (10)
Debe observarse que las potencias maximas de los diferentes subsistemas no se presentan simult ´ | aneamente durante la ´
operacion nominal. El software de vuelo deber ´ | a administrar los modos de misi ´ | on para evitar, por ejemplo, la operaci ´ | on´
simultanea de la c ´ | amara, el procesamiento intensivo de la FPGA, los magnetorques y el transmisor de banda S. De esta ´
manera, la gestion mediante software contribuye directamente al cumplimiento del presupuesto energ ´ | etico. ´
6.21. Capacidad preliminar de la batería: Considerando una fraccion de eclipse aproximada de ´
Decl = 1 − 0,62 = 0,38, | (11)

### el tiempo de eclipse por orbita es aproximadamente ´

| Tecl = 0,38(1,592) ≃ 0,605 h. | | (12)

### Utilizando la potencia media estimada, la energía requerida durante el eclipse es

| Eecl = (1,07)(0,605) ≃ 0,65 Wh. | | (13)
Si se considera una profundidad maxima de descarga del 80 % y una eficiencia del 90 %, la capacidad m ´ | ínima teorica ser ´ | ía

Cbat,min =

0,65
0,8(0,9) ≃ 0,90 Wh. | (14)
Sin embargo, para proporcionar margen frente a degradacion, variaciones t ´ | ermicas, consumos transitorios y operaciones de ´
comunicacion, se adopta preliminarmente un pack de bater ´ | ías del orden de 10 Wh. Este valor debera actualizarse una vez se ´
seleccione la batería definitiva.

### 6.3. Presupuesto preliminar de memoria y datos

La camara multiespectral seleccionada como referencia posee una resoluci ´ | on de ´ | 2048×1088 píxeles y 15 bandas espectrales.
Para simplificar el manejo de memoria, se considera que cada muestra de 10 bits se almacena en una palabra de 16 bits, equivalente a 2 bytes.

### El tamano correspondiente a una banda es ˜

Vbanda = 2048 × 1088 × 2 ≃ 4,46 MB. | (15)

### Por tanto, una adquisicion multiespectral completa de 15 bandas requiere ´

Vadq = 4,46 × 15 ≃ 66,85 MB. | (16)

Para el presupuesto preliminar se considera la adquisicion de diez conjuntos multiespectrales entre oportunidades de descarga. ´
El volumen de informacion sin compresi ´ | on resulta ´
Vtotal = 10(66,85) = 668,5 MB. | (17)

El sistema dispone preliminarmente de al menos 4 GB de memoria no volatil, por lo cual existe un margen amplio incluso ´

### antes de aplicar compresion. ´

La Tabla XI presenta el presupuesto preliminar del volumen de informacion generado por la carga ´ | util y por el sistema de ´
comunicaciones.
| | Tabla XI
PRESUPUESTO PRELIMINAR DE VOLUMEN DE INFORMACION´
Fuente de datos | Datos por adquisicion´ | Adquisiciones estimadas | Volumen acumulado | Almacenamiento requerido | Tasa mínima de transferencia
Camara multiespectral | 66.85 MB | 10 | 668.5 MB ´ | ≥ 0,67 GB | ≈ 5,6 Mbps
Telemetría de estado | ≈ 1 kB | ≈ 100/orbita ´ | ≈ 0,1 MB | < 1 MB | 9.6 kbps
Comandos desde tierra | < 1 kB | Esporadico | Despreciable ´ | < 1 MB | 9.6 kbps
Para la carga util se considera adem ´ | as una compresi ´ | on preliminar de ´ | 2 : 1 ejecutada por el SoC antes de la transmision. El ´
volumen que debería descargarse despues de diez adquisiciones ser ´ | ía

### VTX =

668,5
2
≃ 334,25 MB. | (18)
Suponiendo una ventana efectiva de comunicacion en banda S de aproximadamente ocho minutos, la tasa neta m ´ | ínima

### necesaria para descargar este volumen durante un unico contacto es ´

Rmin =

334,25 × 8
8 × 60
≃ 5,57 Mbps. | (19)

Por tanto, la tasa requerida se encuentra dentro de la capacidad preliminar de hasta 8 Mbps adoptada para el transmisor de banda S.
A la tasa maxima considerada de ´ | 8 Mbps, el tiempo teorico para descargar una adquisici ´ | on multiespectral sin compresi ´ | on´
es

timagen =

66,85 × 8
8
≃ 66,9 s, | (20)

### mientras que con una compresion´ 2 : 1 el tiempo se reduce a

timagen,comp ≃ 33,4 s. | (21)

### 6.4. Consistencia entre los presupuestos

Los presupuestos anteriores muestran que las decisiones de diseno no fueron realizadas de manera independiente. La selecci ˜ | on´
de una arquitectura SoC híbrida permite mantener activo el nucleo de control con un consumo reducido y utilizar la FPGA ´
unicamente durante las operaciones de adquisici ´ | on y procesamiento de im ´ | agenes. De igual forma, la selecci ´ | on de magnetorques ´

### evita el consumo continuo y la masa asociada a las ruedas de reaccion. ´

El volumen de datos generado por la carga util conduce a la necesidad de disponer de memoria no vol ´ | atil del orden de varios ´
gigabytes y justifica la utilizacion de un enlace de banda S de varios megabits por segundo. El enlace UHF puede reservarse ´
para telemetría, balizas y recepcion de comandos, cuyo volumen de informaci ´ | on es mucho menor. ´

Finalmente, el software de vuelo debera coordinar los modos de operaci ´ | on para limitar la concurrencia de cargas de alta ´
potencia. En particular, la adquisicion de im ´ | agenes, el procesamiento intensivo mediante FPGA y la transmisi ´ | on en banda S ´
seran actividades programadas y de corta duraci ´ | on. De esta manera se mantiene un balance energ ´ | etico preliminar positivo y ´
se reduce la capacidad necesaria de la batería, demostrando la viabilidad inicial de la arquitectura propuesta.
7. RIESGOS Y LIMITACIONES

### 7.1. Limitaciones del Disenõ

La arquitectura propuesta para el CubeSat UD34 presenta restricciones inherentes derivadas del formato estandarizado y los

### objetivos de la mision: ´

Generacion de Potencia Limitada: ´ | El formato 1U restringe el area superficial disponible para la instalaci ´ | on de paneles ´
solares fotovoltaicos. Esta limitacion f ´ | ísica condiciona el ciclo de trabajo de los subsistemas de alto consumo, exigiendo
que el transmisor de Banda S y la FPGA se enciendan exclusivamente durante breves ventanas operativas.
Precision de Apuntamiento: ´ | La decision de descartar ruedas de reacci ´ | on en favor de una actuaci ´ | on puramente magn ´ | etica ´
(magnetorques) limita la precision del control de actitud a un rango de ´ | 2

◦
a 5

◦

### . Esto es suficiente para el analisis ´

experimental macro de parcelas cafeteras, pero imposibilita la captura de objetivos puntuales o el seguimiento de
características geograficas de alta resoluci ´ | on. ´
Ausencia de Propulsion y Control Orbital: ´ | El sistema no cuenta con ningun m ´ | odulo de propulsi ´ | on a bordo. Por lo tanto, ´
el satelite no tiene capacidad para realizar maniobras de evasi ´ | on de desechos espaciales ni para compensar el decaimiento ´
orbital, limitando su vida util a la degradaci ´ | on natural en ´ | orbita LEO. ´
Control Termico Pasivo: ´ | Dado el límite de masa (≤ 2,00 kg) y potencia, la arquitectura carece de calentadores activos
o radiadores dinamicos. La gesti ´ | on t ´ | ermica depender ´ | a exclusivamente de la disipaci ´ | on conductiva a trav ´ | es de los planos ´

### de cobre de las PCBs y de los recubrimientos opticos externos. ´

### 7.2. Matriz de Riesgos y Mitigacion´

A continuacion se identifican los principales riesgos t ´ | ecnicos que amenazan el cumplimiento de los requisitos ambientales ´
y operacionales, junto con las estrategias de mitigacion incorporadas en la arquitectura electr ´ | onica. ´
Tabla XII: Matriz de riesgos tecnicos y estrategias de mitigaci ´ | on´
Descripcion del Riesgo | Probabilidad | Impacto | Estrategia de Mitigaci ´ | on en el Dise ´ | nõ

Eventos Singulares por
Radiacion (SEU / SEL) ´
Alteracion de bits l ´ | ogicos o ´
cortocircuitos destructivos causados por iones pesados en el ambiente espacial de 550 km.
Media | Alto | Hardware: Uso de limitadores de corriente (LCL) en
la PCB del EPS para aislar cortocircuitos. Software/Logica: ´ Implementacion de Watchdog Timers ´ en el OBC y memoria ECC (Error Correction Code) en los datos críticos.

Falla Estructural en
Interconexiones
Desconexion de los pines de ´ transito del bus PC/104 entre ´ las 3 PCBs debido a cargas
acusticas y vibraci ´ | on extrema ´
en el lanzamiento.
Baja | Crítico | Mecanica: ´ | Fijacion r ´ | ígida del apilamiento utilizando
4 separadores pasantes de aluminio. Electrica: ´
| | Duplicacion de pines para las l ´ | | íneas críticas de
potencia (3,3 V, 5 V y GND) en el bus del sistema.

Saturacion del Almacena- ´ miento Masivo
Generacion de datos de ´
la camara multiespectral ´ superior a la capacidad de descarga durante el corto pase
sobre la estacion en Medell ´ | ín.
Alta | Medio | Operacional: La matriz FPGA del SmartFusion2 se
utilizara para realizar compresi ´ | on sin p ´ | erdidas antes de ´
guardar las imagenes. Se implementar ´ | a una pol ´ | ítica de
borrado automatico tras recibir el acuse de recibo de la ´ estacion terrestre. ´

Degradacion T ´ ermica de ´ Baterías
Operacion de las celdas de ´ iones de litio por fuera de su rango seguro (0

◦C a 45◦C)
durante ciclos prolongados de eclipse solar.
Media | Alto | Hardware: Inclusion de un termistor en el pack ´ de baterías conectado al EPS. El circuito integrado
de gestion suspender ´ | a f ´ ísicamente los ciclos de
| | carga/descarga si se detectan temperaturas críticas.
Continua en la siguiente p ´ | agina ´

Continuacion de la Tabla XII ´

Descripcion del Riesgo | Probabilidad | Impacto | Estrategia de Mitigaci ´ | on en el Dise ´ | nõ

Desaturacion Insuficiente ´
del ADCS
Acumulacion excesiva ´
de momento magnetico ´
residual que impida a los
magnetorques estabilizar la orientacion requerida para la ´ toma de imagenes. ´
Baja | Alto | Operacional: Configuracion de rutinas pasivas B- ´ Dot previas a la mision principal, asegurando que las ´ bobinas operen con margen suficiente respecto a la intensidad del campo geomagnetico orbital. ´

REFERENCIAS

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
