juanjodiaz04/Proyecto_Diseno_Productos/Tablas/BOM_CubeSat_1U_OBC_Comms.xlsx

Categoría | Función | Fabricante | Referencia | Voltaje / Rieles | Notas / Estado
Lógica y Memoria | SoC (FPGA + ARM) | Microchip | M2S050-FGG484I | 1.2 V (Núcleo), 1.35 V, 3.3 V | Controladores DDR soportan LPDDR, DDR2, DDR3 con SECDED.
Lógica y Memoria | Memoria No Volátil (MRAM) | Everspin | MR4A16BCYS35 | 3.0 V a 3.6 V | 2 MB cada una (TSOP2-54). Usar de 2 a 4 unidades para firmware. -40 a +85 °C.
Lógica y Memoria | Memoria RAM (DDR3L) | ISSI | IS43TR16256A-125KBLI | 1.35 V, VTT, VREF | Sin verificar.
Lógica y Memoria | Almacenamiento masivo (eMMC) | Micron | MTFC32GAPALBH-AAT | 1.8 V / 3.3 V | Sin verificar. Host implementado en la fabric. Alternativa: SLC NAND con EDAC.
Lógica y Memoria | Reloj / Oscilador | Aker | S3A33025 | 3,3 V | Reloj Oscilador 50 Mhz
Lógica y Memoria | Supervisor / Watchdog | Texas Instruments | TPS3823-33-EP | 3.3 V | Sin verificar.
UHF (435 - 438 MHz) | Transceptor RFIC | Silicon Labs | Si4468-A2A-IM | 3.3 V | Reemplaza al AX5043. QFN-20. Requiere FEC (Reed-Solomon) en la fabric.
UHF (435 - 438 MHz) | PA (Amplificador de Potencia) | Analog Devices | ADL5324 | 3.3 V a 5 V | 0.5 W. Confirmar valor de P1dB a 436 MHz.
UHF (435 - 438 MHz) | Switch TX/RX | pSemi | PE4259 | 3.3 V | SPDT UltraCMOS, 34 dBm, temp máxima 85 °C.
UHF (435 - 438 MHz) | LNA de Recepción | Qorvo | PSA4-5043 | 3/5 V | Reemplaza al TQP3M9008. Consume 85 mA. Confirmar datasheet.
UHF (435 - 438 MHz) | Filtro de RX (SAW) | RFMi | SF2446E | - | Ancho banda 23 MHz. Poner SOLO en recepción. TX requiere pasa-bajos LC discreto.
Banda S (2.4 - 2.45 GHz) | Transceptor RF / SDR | Analog Devices | AD9364BBCZ | 1.3 V (Núcleo), 1.8 V (Interfaz), 3.3 V (GPO) | CSP-BGA 144 bolas. Entrega ~7.5 dBm.
Banda S (2.4 - 2.45 GHz) | Reloj de Referencia | Aker | S733025T | 3.3V | Oscilador 40 MHz
Banda S (2.4 - 2.45 GHz) | Baluns (TX y RX) | Johanson Technology | 2450BL15B100 | - | Validar impedancia balanceada contra el diseño de referencia de ADI. Relación 1:2.
Banda S (2.4 - 2.45 GHz) | Driver RF | Analog Devices | ADL5320 | 5 V | Recomendado para nuevos diseños.
Banda S (2.4 - 2.45 GHz) | PA (Amplificador de Potencia) | Analog Devices | ADL5324 | 5 V | Mismo de UHF con otra red de adaptación. Estima 0.4 - 0.5 W en antena.
Banda S (2.4 - 2.45 GHz) | Filtro de TX | TDK | DEA202450BT | - | Pérdida 1.8 dB. Soporta 2 W.
Banda S (2.4 - 2.45 GHz) | Switch TX/RX | pSemi | PE4259 | 3.3 V | Mismo switch utilizado en UHF.
Banda S (2.4 - 2.45 GHz) | LNA de Recepción (Opcional) | Maxim Integrated | MAX2644 | 3.3 V | El AD9364 ya trae LNA. Evaluar necesidad.
Energía | Regulador Switching (Buck) | Texas Instruments | TPS62903 | Varios (1.2V, 1.35V, 1.8V, 3.3V) | Sin verificar.
Energía | LDO de Ultra Bajo Ruido | Analog Devices | LT3045 | Regulador Ajustable 0-15V | Sin verificar. Esencial para limpiar el AD9364.
Energía | Monitor de Corriente / Protección SEL | Texas Instruments | INA226 | 3.3 V | Sin verificar. ALERT del INA226 cableado por hardware al enable del switch.
Energía | Load Switch (Control de Potencia) | Texas Instruments | TPS22918-Q1 | 5 V (Riel de PAs) | Sin verificar. Alimentar 5V solo durante los pases.
Mecánica e Interfaces | Conector Debug | Samtec | HTST10501 -LDVDA | 10 pines | Sin verificar.
Mecánica e Interfaces | Conector Bus CubeSat (PC/104) | Samtec | ESQ-126-14-G-D | 52 Pines | Sin verificar. Se usarán 2 unidades.
Mecánica e Interfaces | Conectores de Antena | Rosenberger | 18S142-40ML5 | - | Conector SMP
Mecánica e Interfaces | Materiales PCB (Stackup) | Rogers / Isola | RO4350B + 370HR | - | Sin verificar.
Mecánica e Interfaces | Blindaje EMI (Shielding) | Harwin | - | - | Sin verificar.
