juanjodiaz04/Proyecto_Diseno_Productos/Tablas/Tablas_CubeSat_UD34_costos_actualizados.xlsx

Sheet: Indice
HOJA | CONTENIDO | FILAS
Requisitos | Requisitos aplicables a la tarjeta de OBC + COMMS (PCB 2) | 12
Especificaciones | Especificaciones técnicas de la tarjeta COMMS+OBC | 37
Funciones | Funciones de hardware y software asignadas a la tarjeta OBC + COMMS | 9
Restricciones PCB | Restricciones para el diseño PCB OBC + COMMS | 8
DFM fabricante | Parámetros de diseño DFM vs. límites de fabricación de PCBWay | 13
Restricciones Altium | Matriz de restricciones del proyecto Altium y criterio de comprobación. | 12
Plan verificacion | Plan de verificación y trazabilidad preliminar. | 12
Registro incidencias | Registro de incidencias y evidencias de verificación (por completar con resultados reales). | 2
Inventario componentes | Referencias principales del inventario actualizado; cantidades y montaje por confirmar en Altium. | 24
Resumen costos | Resumen costos | 3

Sheet: Requisitos
ID | Tipo | Requisito | Origen o justificación | Prioridad | Criterio de aceptación
RF-02 | Funcional | El CubeSat deberá almacenar temporalmente los datos generados por la carga útil antes de su transmisión a tierra. | S-05 / Operación de la carga útil. | Alta | La capacidad de almacenamiento definida en la eMMC/MRAM de la PCB deberá ser igual o superior al volumen máximo de datos generado entre oportunidades de descarga.
RF-03 | Funcional | El CubeSat deberá transmitir a la estación terrestre los datos de misión y la telemetría correspondiente al estado del satélite. | S-08 / Comunicación satélite–tierra. | Alta | El presupuesto de enlace de la etapa RF de la tarjeta deberá demostrar la capacidad de realizar el enlace descendente durante una ventana de comunicación prevista.
RF-04 | Funcional | El CubeSat deberá recibir comandos provenientes de la estación terrestre. | S-08 / Comunicación bidireccional. | Alta | La arquitectura de comunicaciones en la PCB deberá contemplar un enlace ascendente (UHF) capaz de recibir y entregar comandos al sistema de manejo de datos.
RNF-01 | No funcional | La plataforma espacial deberá ser capaz de operar nominalmente en órbita baja terrestre durante un período mínimo de seis (6) meses sin degradación crítica de sus funciones. | S-02 / Duración nominal de la misión. | Alta | La selección y análisis de los componentes activos y pasivos de la PCB deberá demostrar compatibilidad con una duración mínima de misión de seis meses en el ambiente orbital considerado.
RNF-03 | No funcional | El sistema de comunicaciones deberá proporcionar un enlace con margen positivo bajo las condiciones nominales de comunicación con la estación terrestre de referencia. | S-04 y S-08 / Enlace de comunicaciones. | Alta | El presupuesto de enlace de las etapas UHF y Banda S integradas en la PCB deberá presentar un margen superior a 0 dB para las condiciones nominales adoptadas.
RNF-04 | No funcional | Los subsistemas eléctricos deberán utilizar interfaces de alimentación y datos compatibles entre sí. | Integración del sistema. | Alta | La etapa de regulación local (POL) y los buses de datos de la PCB deberán demostrar compatibilidad de tensión, corriente, niveles eléctricos y protocolos con el resto de subsistemas.
RA-01 | Ambiental | El hardware del CubeSat deberá ser compatible con la operación en vacío durante la fase orbital de la misión. | S-03 / Ambiente espacial de operación. | Alta | Los componentes, conectores y materiales de la PCB (sustrato híbrido) deberán disponer de características documentadas compatibles con la operación en vacío.
RA-02 | Ambiental | El CubeSat deberá soportar el entorno térmico asociado con los ciclos de iluminación y eclipse de la órbita definida para la misión. | S-03 / Entorno térmico orbital. | Alta | El análisis térmico de la tarjeta deberá demostrar que las temperaturas estimadas de los integrados (SoC, PAs de RF, memorias) permanecen dentro de sus límites admisibles.
RA-03 | Ambiental | La estructura y los componentes del CubeSat deberán permanecer mecánicamente íntegros frente a las cargas previstas durante el lanzamiento y despliegue. | Entorno de lanzamiento / Seguridad. | Alta | La verificación estructural de la PCB deberá demostrar la integridad de los encapsulados BGA, TSOP, conectores PC/104 y uniones de soldadura frente a los niveles de vibración adoptados.
RA-04 | Ambiental | Los equipos electrónicos críticos del CubeSat deberán mantener su funcionalidad después de una Dosis Ionizante Total de diseño de al menos 5 krad(Si). | S-02 y S-03 / Entorno de radiación correspondiente a una misión de seis meses en SSO a 550 km. | Alta | La tolerancia documentada a TID de los integrados críticos de la PCB (SmartFusion2, MRAM, eMMC, RFICs) deberá ser igual o superior al valor de diseño determinado.
RA-05 | Ambiental | Los componentes electrónicos críticos susceptibles a latch-up deberán presentar un umbral de susceptibilidad a SEL por iones pesados igual o superior a 60 MeV cm^2/mg. | S-03 / ECSS-E-ST-10-12C, entorno de radiación y efectos de evento único. | Alta | Verificar documentalmente o mediante circuitos de protección local (*Load Switches*) que los componentes de la PCB susceptibles a SEL presenten LET_th 60 MeV cm^2/mg.
RN-04 | Normativo | El subsistema de comunicaciones deberá operar dentro de bandas y condiciones de emisión compatibles con la reglamentación de espectro aplicable a la misión. | S-08 / Regulación de comunicaciones satelitales. | Alta | Las etapas de transmisión UHF y Banda S de la PCB deberán ajustarse a la asignación de frecuencias, anchos de banda y potencias de emisión autorizadas.

Sheet: Especificaciones
ID de especificación | Requisitos asociados | Parámetro técnico | Valor, rango o tolerancia | Unidad | Fundamento | Método previsto de verificación
ET-MIS-01 | RNF-01 | Vida útil nominal de la misión | 6 | meses | Duración mínima establecida en el supuesto S-02. Condiciona la selección de componentes de la tarjeta. | A, I
ET-ORB-01 | RA-02, RA-04 | Altitud orbital de referencia | 550 nominal | km | Órbita adoptada en el supuesto S-03. Se usa en el presupuesto de enlace y en el análisis de radiación de la tarjeta. | A
ET-GS-01 | RNF-03 | Estación terrestre de referencia | Medellín | – | Ubicación definida en el supuesto S-04. Base del presupuesto de enlace de las bandas UHF y S. | A
ET-OBC-01 | RF-02 | Elemento de procesamiento | Microchip M2S050-FGG484I (ARM + FPGA) | – | Se requiere lógica programable para implementar el host eMMC y la codificación Reed-Solomon del enlace UHF, además del procesador de a bordo. | I
ET-OBC-02 | RF-02 | Frecuencia del reloj del sistema | 50 | MHz | Oscilador Aker S3A33025 alimentado a 3.3 V. | I
ET-OBC-03 | RNF-01 | Supervisión de alimentación y watchdog | Supervisor de 3.3 V con watchdod | – | Texas Instruments TPS3823-33-EP. Reinicia el sistema ante caídas de tensión o bloqueo del software. | A, I, D
ET-MEM-01 | RF-02 | Memoria RAM de trabajo | 512 (4 Gb) | MB | ISSI IS43TR16256A-125KBLI (DDR3L, 1.35 V). Capacidad deducida de la organización 256M 16; | A, I
ET-MEM-02 | RF-02 | Memoria no volátil para firmware | 2 por dispositivo, de 2 a 4 dispositivos | MB | Everspin MR4A16BCYS35 en TSOP2-54. La cantidad de unidades depende de la redundancia de firmware que se adopte. | A, I
ET-MEM-03 | RF-02 | Capacidad nominal de almacenamiento masivo | 32 | GB | Micron MTFC32GAPALBH-AAT (eMMC). El host se implementa en la fabric del SoC. La capacidad útil se verifica contra ET-DAT-02. | A, I
ET-DAT-01 | RF-01, RF-02 | Volumen de datos por adquisición | 21 | MB | Se calculará a partir de la resolución del sensor, número de bandas, profundidad de bits y esquema de compresión adoptado. Dimensiona el almacenamiento de la tarjeta. | A
ET-DAT-02 | RF-02 | Capacidad útil mínima de almacenamiento masivo | 8 | GB | Se calculará a partir del máximo volumen de datos acumulado entre oportunidades consecutivas de descarga, y se comparará con ET-MEM-03. | A, I
ET-COM-01 | RF-03 | Tasa neta mínima de enlace descendente | 1.0 | KbpsMbps | Se calculará a partir del volumen de datos que debe transmitirse y del tiempo efectivo de comunicación con la estación terrestre. | A
ET-COM-02 | RNF-03 | Margen del enlace de comunicaciones | >0 | dB | Condición establecida por RNF-03. Se verificará mediante el presupuesto de enlace de cada banda en condiciones nominales. | A
ET-COM-03 | RF-03, RF-04, RN-04 | Banda de operación del enlace UHF | 435 a 438 | MHz | Seleccionada en la arquitectura de la tarjeta (Si4468-A2A-IM). La coordinación y la regulación de espectro aplicables están por confirmar. | A, I
ET-COM-04 | RF-03, RF-04, RN-04 | Banda de operación del enlace en banda S | 2.4 a 2.45 | GHz | Seleccionada en la arquitectura de la tarjeta (AD9364BBCZ). | A, I
ET-COM-05 | RF-03, RNF-03 | Potencia de transmisión UHF | 0.5 nominal | W | Amplificador Analog Devices ADL5324. El valor de P1dB a 436 MHz | A, T
ET-COM-06 | RF-03, RNF-03 | Potencia de transmisión en banda S en la antena | 0.4 a 0.5 (estimada) | W | El AD9364 entrega unos 7.5 dBm. El driver ADL5320 y el amplificador ADL5324 elevan la señal, y el filtro TDK DEA202450BT introduce unos 1.8 dB de pérdida. | A, T
ET-COM-07 | RF-03, RF-04 | Codificación de canal del enlace UHF | Reed-Solomon en la fabric del SoC | – | El Si4468 no incluye corrección de errores, por lo que la FEC debe implementarse en la lógica programable. | A, D
ET-COM-08 | RF-03, RF-04 | Modo de acceso a la antena por banda | Conmutación TX/RX (semidúplex) | – | Conmutador SPDT pSemi PE4259 por banda para compartir la antena. | I, D
ET-INT-01 | RNF-04 | Tensión nominal del bus eléctrico principal | 5 | V | Se definirá mediante la selección de la arquitectura EPS. Es la entrada de los reguladores de la tarjeta. | A, I
ET-PWR-01 | RNF-02, RNF-04 | Rieles generados en la tarjeta | 1.2; 1.35; 1.8 | V | Regulador conmutado TPS62903. Alimentan SoC, DDR3L (incluye VTT y VREF), eMMC, memorias MRAM, transceptores y relojes. | A, I, T
ET-PWR-02 | RF-03, RNF-02 | Alimentación de bajo ruido para el transceptor de banda S | Riel dedicado con LDO de ultra bajo ruido | – | Analog Devices LT3045 para limpiar la alimentación del AD9364 (núcleo de 1.3 V). | A, T
ET-PWR-03 | RNF-02 | Riel de los amplificadores de potencia | 5, conmutado, activo solo durante los pases | V | Interruptor de carga TPS22918-Q1. Reduce el consumo medio de la tarjeta. | A, T
ET-PWR-04 | RF-07, RNF-02 | Potencia pico de la tarjeta | 5.5 a 9 | W | Se obtendrá del presupuesto de potencia, con los amplificadores UHF y banda S activos. Alimenta el presupuesto del CubeSat. | A, T
ET-PRO-01 | RA-05 | Protección contra latch-up de la tarjeta | Corte por hardware ante sobrecorriente; umbral | – | El pin ALERT del INA226 se conecta por hardware a la habilitación del interruptor de carga, sin intervención del software. | A, I, T
ET-INT-03 | RNF-04 | Conectores del bus CubeSat (PC/104) | 2 conectores de 52 | pines | Samtec ESQ-126-14-G-D. La asignación de pines se define en la matriz de interfaces. | I
ET-INT-04 | RNF-04 | Conector de programación y depuración | 10 | pines | Samtec HTST10501-LDVDA. Acceso al SoC para programación y depuración. | I, D
ET-INT-05 | RF-03, RNF-04 | Conectores de antena | 2 SMP (UHF y banda S), 50 |  | Rosenberger 18S142-40ML5. La impedancia de 50 es una inferencia por confirmar con la hoja de datos. | I, T
ET-MEC-01 | RN-01 | Configuración mecánica | 1U | – | Formato definido por S-01 y la CubeSat Design Specification Rev. 14.1. Acota el área disponible de la tarjeta. | I
ET-PCB-01 | RF-03, RF-04 | Material del apilamiento de la PCB | Rogers RO4350B + Isola 370HR; 8 Capas | – | Material de bajas pérdidas para las capas de RF y material estándar para el resto. El apilamiento se detalla en la guía de enrutamiento. | A, I
ET-PCB-02 | RF-03, RF-04 | Blindaje contra interferencia electromagnética | Blindaje Harwin sobre las secciones de RF; referencia TBD | – | Separa los circuitos de RF de los circuitos digitales y de potencia de la tarjeta. | A, I
ET-ENV-01 | RA-01 | Ambiente de operación durante la fase orbital | Vacío orbital | – | Condición ambiental derivada de la operación en órbita definida en S-03. | A, I
ET-TH-01 | RA-02 | Rango térmico de diseño | -20 a 85 | ^C | Se determinará mediante análisis térmico. La MRAM (-40 a +85 ^C) y el conmutador PE4259 (máximo 85 ^C) fijan el límite superior. | A
ET-STR-01 | RA-03 | Nivel de cargas y vibraciones de lanzamiento | 14.1 | Grms | Perfil de vibración aleatoria envolvente (NASA GEVS GSFC-STD-7000A) y cargas cuasi-estáticas para la verificación de encapsulados BGA, TSOP y conectores de la tarjeta. | A, T
ET-RAD-01 | RA-04 | Dosis Ionizante Total de diseño | 5 | krad(Si) | Dosis ionizante acumulada calculada para 6 meses en SSO a 550 km, considerando blindaje equivalente de 1.5 mm de aluminio y un margen de diseño RDM de 2.5x. | A
ET-RAD-02 | RA-05 | Umbral mínimo de susceptibilidad a SEL | 60 | MeV cm^2mg | Valor establecido en RA-05 para los componentes críticos de la tarjeta susceptibles a Single Event Latch-up. | I
ET-RAD-03 | RA-04 | Mitigación de errores en memoria | SECDED en la DDR3L; firmware replicado en 2 a 4 MRAM | – | Los controladores DDR del SoC admiten SECDED. La redundancia de MRAM protege el firmware frente a errores por radiación. | A, D

Sheet: Funciones
Función | Tipo de implementación | Recursos de hardware necesarios | Responsabilidad del software futuro | Justificación
Procesamiento de datos de la carga útil | Software | Procesador dedicado/SoC (SmartFusion2 con matriz FPGA y núcleo ARM), RAM DDR3L y almacenamiento masivo local. | Gestionar los datos adquiridos, generar metadatos, verificar integridad y realizar operaciones de preparación o compresión antes del almacenamiento o transmisión. | La función es principalmente algorítmica. La FPGA y el procesador de la PCB 2 constituyen el recurso físico sobre el cual se ejecuta el software de procesamiento.
Almacenamiento de imágenes | Mixta | Memoria no volátil (eMMC / NAND Flash de 8–32 GB) con interfaz compatible montada en la tarjeta central. | Administrar archivos o bloques de datos, controlar la ocupación, verificar integridad mediante CRC y eliminar los datos descargados correctamente. | RF-02. La memoria masiva local realiza físicamente el almacenamiento, mientras que el software administra la organización e integridad de la información.
Buffer temporal de imágenes | Software | Memoria RAM disponible mínima de 16 MB en la cadena de procesamiento de la tarjeta. | Gestionar buffers de entrada y salida, controlar transferencias entre la cámara, RAM y memoria no volátil y evitar pérdida de información. | La función corresponde principalmente a gestión de memoria de trabajo para manipular los paquetes de imagen antes de su compresión o guardado.
Control y coordinación central del CubeSat | Software | Computador de a bordo basado en SoC ARM Cortex-M3, memoria no volátil y buses CAN, SPI, UART, I^2C y LVDS. | Ejecutar la máquina de estados de misión, coordinar subsistemas, gestionar modos de operación, procesar eventos y ejecutar las acciones asociadas a los comandos recibidos. | La coordinación del sistema depende principalmente de la lógica del software de vuelo; el hardware del OBC proporciona los recursos computacionales necesarios.
Temporización y referencia temporal | Mixta | RTC, oscilador de referencia (TCXO) y temporizadores disponibles en el computador de a bordo. | Mantener el tiempo de misión, generar marcas temporales para imágenes y telemetría y programar eventos de operación. | El hardware de la tarjeta proporciona la referencia temporal estable y el software la utiliza para sincronizar los eventos de misión.
Detección y recuperación ante fallos | Mixta | Watchdog hardware externo, supervisores de alimentación locales y limitadores de corriente (Load Switches). | Detectar condiciones anómalas, registrar eventos, reiniciar subsistemas y llevar el satélite a un estado seguro cuando sea necesario. | Combina mecanismos autónomos de protección en hardware local con estrategias de detección y recuperación implementadas mediante software.
Recepción de comandos críticos | Mixta | Transceptor UHF (AX5043 / CC1120 o equivalente) en el rango de 400 MHz con tasa nominal de 9.6 kbps. | Validar la integridad de las tramas recibidas, interpretar los comandos y generar las acciones correspondientes sobre los subsistemas. | RF-04. El transceptor realiza la recepción física en radiofrecuencia, mientras que el software interpreta y ejecuta el contenido del comando.
Transmisión de telemetría | Mixta | Transceptor UHF con tasa nominal de 9.6 kbps y conexión digital directa con el procesador central. | Construir paquetes de housekeeping con tensiones, corrientes, temperaturas, estados, alarmas y eventos, y gestionar su envío. | RF-03. El software genera y organiza la telemetría mientras el hardware de radiofrecuencia realiza el enlace físico descendente.
Transmisión de imágenes | Mixta | Transmisor de alta velocidad en Banda S (2.2–2.4 GHz) con capacidad de 1 Mbps a 8 Mbps. | Fragmentar las imágenes, organizar los paquetes, gestionar la cola de transmisión y mantener registro de la información descargada. | RF-03. El software gestiona el flujo de paquetes desde la eMMC hacia la etapa RF de Banda S para su descarga durante la ventana sobre Medellín.

Sheet: Restricciones PCB
ID y Trazabilidad | Restricción y Alcance | Fuente y Fundamento | Aplicación y Verificación
PCB-01 (RF-03, RN-04) | Apilamiento Híbrido (Stackup): Placa de 8 a 12 capas. Capas externas (Top/Bottom) en Rogers RO4350B (alta frecuencia) y capas internas en FR-4 High-Tg / Isola 370HR para lógica digital. | Recomendación de arquitectura RF/Digital: El FR-4 estándar presenta pérdidas inaceptables en Banda S (2.4 GHz). El stackup híbrido optimiza costos e integridad de señal. | Directiva de fabricación: Supuesto preliminar para el fabricante de PCBs. Verificación en el Layer Stack Manager del CAD.
PCB-02 (RA-01, RA-02) | Disipación Térmica (Vías): Arreglos de vías térmicas (thermal vias) bajo los PAs de RF (ADL5324) y el SoC SmartFusion2, conectando a planos gruesos de cobre (2 oz) vinculados al chasis. | Inferencia justificada (Entorno Espacial): En el vacío no existe convección. Los integrados de alto consumo colapsarán térmicamente sin conducción directa a la estructura. | Regla de layout: Colocación de polígonos térmicos y matrices de vías. Verificación mediante análisis térmico del CAD y revisión visual.
PCB-03 (RNF-03, RF-03) | Impedancia Controlada RF y Aislamiento: Microcintas Coplanares con Plano de Masa (CPWG) a 50 hacia conectores SMP, rodeadas por apantallamiento de vías (via fencing). | Datasheet SMP y RFICs: Evita pérdidas por desacople, ondas reflejadas y radiación que degraden la figura de ruido o dañen las etapas de salida. | Directiva de ruteo: El ancho de pista dependerá del stackup final. Verificación por calculadora de impedancia y regla DRC en el CAD.
PCB-04 (RNF-04, IF-02, IF-07) | Integridad de Señales Diferenciales (LVDS): Enlaces LVDS/MIPI con impedancia diferencial de 100 . Acoplamiento de longitud (desfase <0.3 mm) y plano de masa continuo adyacente. | Estándar LVDS / ECSS SpaceWire: Cancela el ruido de modo común, minimiza emisiones EMI y previene desalineación de fase a altas velocidades. | Regla DRC de alta velocidad: Differential Pairs Routing y Length Tuning (Meandering). Verificación automática en el DRC.
PCB-05 (RNF-03, EMC) | Apantallamiento Electromagnético (EMI): Cajas de blindaje SMD independientes (Shielding Cans) para las secciones UHF, Banda S y reguladores Buck conmutados. | Buena práctica RF (Aislamiento): El ruido digital del SoC y la emisión UHF (1 W) pueden ensordecer los receptores LNA o acoplar ruido al enlace de Banda S. | Regla de layout: Footprints para clips de blindaje y zonas keep-out sin pistas en la capa top. Revisión de modelo 3D.
PCB-06 (RNF-04, POL(Point of Load)) | Ubicación de Regulación RF (LDOs): LDOs de ultra-bajo ruido (LT3042/LT3045) ubicados a milímetros de las entradas analógicas del AD9364 (1.3 V) y LNAs. | Datasheet AD9364 y LNAs: Los PLLs y sintetizadores son sensibles al rizado de tensión. Separarlos de reguladores conmutados asegura un PSRR óptimo. | Directiva de placement: Aislamiento de dominios de energía en la hoja POL y ruteo directo. Revisión manual del esquemático.
PCB-07 (OBC, Power) | Desacoplamiento SoC y Filtrado LC: Múltiples capacitores en paralelo pegados al BGA (1.2 V). Filtrado pasivo LC (ferrita + cap) exclusivo para las líneas VDD_PLL. | Guía de aplicación SmartFusion2: Inductores en el núcleo provocan caídas por dI/dt. Los PLLs requieren filtrado pasivo al consumir corriente estable. | Restricción de ruteo: Capacitores colocados en la misma capa del BGA o con vías cortas directas. Verificación visual 3D e inspección de ERC.
PCB-08 (RNF-02, EPS) | Control de Pico de Corriente (Soft-Start): Capacitores de 3.3 nF a 10 nF en el pin SS/TR de los Bucks TPS62130A para un arranque suave de 2-4 ms. | Datasheet TPS62130A y dinámica sistémica: Previene colapsos en el bus de alimentación global del EPS al cargar el banco de capacitores del SoC/DDR3L. | Comprobación esquemática (ERC): Verificación de selección de dieléctricos C0G/X7R en la BOM y simulación de tiempo de arranque.

Sheet: DFM fabricante
Parámetro DFM | Parámetro Escogido (PCB 2) | Límite del Fabricante (PCBWay) | Fundamento / Criterio de Selección
Número de capas | 8 capas | Hasta 64 capas | Requerido para el escape (*fanout*) del BGA de 484 pines (SmartFusion2), ruteo de buses LVDS y planos de masa para RF.
Material base y Stackup | Híbrido: Rogers RO4350B (capas ext.) + FR-4 High-Tg / Isola 370HR (capas int.) | FR-4 High-Tg (Tg170–220), Rogers 4350/4003, PTFE, Cerámico, Prensado mixto (2–20 capas) | Minimiza la atenuación dieléctrica en la etapa de Banda S (2.4 GHz) en capas externas y optimiza costos en capas digitales internas.
Espesor nominal de la placa | 1.6 mm 7% | 0.21 mm - 6.0 mm ( 7% para espesores entre 1.0 mm y 2.5 mm) | Estándar mecánico compatible con los conectores apilables PC/104 de la estructura CubeSat 1U y rigidez ante vibraciones.
Ancho de pista y espaciamiento (W/S) | 4.0 mil / 4.0 mil (0.10 mm) | Mínimo 2.0 mil / 2.0 mil (0.05 mm) en capas internas y externas | Facilita el ruteo entre los pines del BGA (0.8 mm pitch) manteniendo un alto rendimiento de fabricación (*yield*).
Diámetro de perforación vía (Drill) | 0.20 mm (8 mil) mecánico pasante | Mínimo 0.15 mm (Mecanizado CNC) / 0.10 mm (Microvía Láser ciega/enterrada) | Permite la transición entre capas sin recurrir a microvías láser de alto costo (tecnología HDI estándar pasante).
Relación de aspecto (*Aspect Ratio*) | 8:1 (1.6 mm / 0.20 mm) | Hasta 12:1 (estándar) / 20:1 (capacidad máxima) | Garantiza la homogeneidad y continuidad del cobreado electrolítico en las paredes internas de las vías pasantes.
Anillo de cobre (*Annular Ring*) | 4.0 mil (0.10 mm) en vías / 6.0 mil en orificios THT | Mínimo 3.0 mil en vías / 5.0 mil en orificios de componentes | Previene la desalineación de la perforación (*breakout*) y asegura la integridad bajo delaminación por ciclos térmicos.
Capacidad para componentes BGA | Pitch de 0.8 mm / Pad de 0.35 mm | Pitch mínimo de BGA: 0.4 mm / Diámetro mínimo de BGA: 8 mil (0.20 mm) | Adaptado a la matriz FGG484 del SoC SmartFusion2 (M2S050) y chips de memoria masiva.
Puente de máscara de soldadura (*Solder Mask Dam*) | 4.0 mil (0.10 mm) | Mínimo 3.0 mil (máscara verde) / 4.0 mil (máscara negra/otras) | Retiene el flujo de soldadura entre pads adyacentes de alta densidad para prevenir cortocircuitos por puentes durante el *reflow*.
Acabado superficial (*Surface Finish*) | **ENIG** (*Electroless Nickel Immersion Gold*) | ENIG, HASL, Lead Free HASL, OSP, Immersion Ag/Sn, Plating Hard Gold | Superficie plana indispensable para encapsulados BGA/QFN de paso fino y excelente resistencia a la oxidación en almacenamiento/vacío.
Tolerancia de control de impedancia | 10% (50 RF CPWG / 100 diferencial LVDS) | 10% ( 5 para impedancias 50 ) | Asegura la integridad de señal en la interfaz del SDR AD9364, conector SMP y las trazas de alta velocidad de la cámara.
Distancia vía a conductor (*Hole to Conductor*) | 8.0 mil (0.20 mm) | Mínimo 6.0 mil (0.15 mm) a conductores internos y externos | Evita acoplamientos capacitivos no deseados y perforaciones sobre pistas activas por tolerancias de taladrado.
Espesor del cobre (*Copper Thickness*) | Capas ext.: 1.0 oz (35 ) / Capas int.: 0.5 - 1.0 oz | Cobre base mín. 1/3 oz (12 ) hasta 8 oz máximo final | Proporciona la capacidad de conducción necesaria para los reguladores POL y estabilidad para el grabado de líneas de RF.

Sheet: Restricciones Altium
ID | Restricción / criterio de aceptación | Evidencia y método
AL-01 | Cada componente montado debe tener designador único, valor o referencia, fabricante, MPN y huella compatible. | Inspección de propiedades y comparación esquemático–BOM; revisar componentes sin footprint.
AL-02 | No deben existir redes sin conductor intencional, conflictos de dirección eléctrica ni pines de alimentación indebidamente abiertos. | Compilación y Electrical Rules Check (ERC); registrar y justificar excepciones.
AL-03 | Todas las hojas deberán usar nombres de red, puertos y conexiones jerárquicas coherentes, sin uniones implícitas no previstas. | Navegador de redes, cross-probing y revisión manual hoja a hoja.
AL-04 | Cada dominio de alimentación deberá indicar tensión nominal, secuencia de encendido, retorno y protecciones aplicables. | Revisión de hojas POL, reguladores, load switches, supervisor y secuencia de arranque.
AL-05 | Las interfaces del SoC, memorias y radios deben respetar niveles lógicos, direcciones, tensiones de banco y asignación de pines. | Cruce de datasheets, pinout y tabla de interfaces; comprobación de conexiones.
AL-06 | El reloj de referencia, reset, watchdog, programación y arranque deben estar definidos y sin estados flotantes peligrosos. | Revisión de osciladores, resistencias de polarización, JTAG y supervisor.
AL-07 | Las redes RF deben identificar trayectoria TX/RX, filtros, adaptación, alimentación y conectores de impedancia nominal 50 . | Inspección de cadena RF y datasheets; impedancia física pendiente de layout.
AL-08 | Las señales diferenciales y los buses de alta velocidad deberán tener pares, polaridad, terminación y restricciones identificables. | Revisión del esquemático y futura definición de reglas de impedancia/longitud en PCB.
AL-09 | Los dispositivos de potencia y radiofrecuencia deberán contar con desacoplamiento y filtrado acordes con sus fabricantes. | Revisión manual de condensadores, valores, ubicación prevista y rutas de retorno.
AL-10 | Los componentes opcionales o no montados deberán identificarse inequívocamente para la configuración de producción. | Variantes de ensamblaje y BOM exportada con columna de montaje.
AL-11 | Las librerías deberán tener correspondencia verificable entre símbolo, numeración de pines y footprint. | Comparación con datasheets y revisión de modelos en Altium.
AL-12 | El proyecto entregado debe contener fuentes editables, PDF del esquemático, BOM, evidencias ERC y versión identificada. | Auditoría del repositorio y comprobación de accesibilidad del commit/etiqueta.

Sheet: Plan verificacion
ID | Elemento a verificar | Método | Criterio de aceptación | Estado / evidencia
VER-01 | Integridad del esquemático | I | Proyecto compilado; sin errores eléctricos reales sin resolver. | Pendiente: reporte ERC.
VER-02 | Símbolos y huellas | I | Coincidencia de todos los pines y encapsulados con el fabricante. | Pendiente: revisión cruzada.
VER-03 | Dominios de tensión | I/A | Cada carga recibe alimentación compatible y tiene desacoplamiento definido. | Pendiente: matriz de tensiones.
VER-04 | Arranque y supervisión | I/A | Estados de reset, reloj y watchdog coherentes con datasheets. | Pendiente: secuencia de arranque.
VER-05 | Memorias y OBC | I/A | Interfaz y asignación de pines coherentes con la arquitectura seleccionada. | Pendiente: revisión de pinout.
VER-06 | Cadena UHF | I/A | Trayectoria RF completa y niveles de control compatibles con los RFIC. | Pendiente: revisión de hojas RF.
VER-07 | Cadena banda S | I/A | Transceptor, balunes, amplificación y filtrado compatibles en frecuencia y potencia. | Pendiente: presupuesto RF.
VER-08 | Distribución de potencia | A/P | Corriente, pérdidas y arranque dentro de límites de cada componente. | Análisis pendiente; prueba futura.
VER-09 | Compatibilidad EMC | A/P | Reglas de partición y filtrado definidas; ensayos según plan aplicable. | Layout y pruebas futuras.
VER-10 | Restricciones físicas | A/I | Contorno, altura, taladros y conectores compatibles con integración 1U. | Comprobación 3D futura.
VER-11 | Reglas PCB | A/I | DRC conforme al stackup aprobado y tolerancias del fabricante. | Pendiente de layout.
VER-12 | Coherencia documental | I | Misma revisión en esquemático, BOM, cálculos y repositorio. | Pendiente: auditoría final.

Sheet: Inventario componentes
Función | Referencia | Fabricante
SoC/OBC | M2S050-FG484 | Microchip
MRAM | MR4A16BCYS35R | Everspin
RAM | IS43TR16256A-125KBL | ISSI
Almacenamiento | MTFC32GAPALBH-AAT | Micron
Oscilador | S3A33025-50.000-L-X-R | Aker
Supervisor | TPS3823-33DBVT | Texas Instruments
Transceptor RF | SI4464-B1B-FMR | Silicon Labs
Amplificador RF | ADL5324ARKZ-R7 | Analog Devices
Conmutador TX/RX | PE4259 | pSemi
Amplificador RF | PSA4-5043+ | Mini-Circuits
Filtro RX | SF2421D | RFMi
SDR | AD9364BBCZ | Analog Devices
Referencia RF | S733025T-40.000-15-R | Aker
Balun | 2450BL15B100E | Johanson
Driver RF | ADL5320ARKZ-R7 | Analog Devices
Filtro TX | DEA202450BT-1294D1-H | TDK
LNA opcional | MAX2644EXT+T | Analog Devices
Buck | TPS62903QRYTRQ1 | Texas Instruments
LDO bajo ruido | LT3045IMSE#PBF | Analog Devices
Monitor de corriente | INA226AIDGST | Texas Instruments
Interruptor de carga | TPS22918TDBVRQ1 | Texas Instruments
JTAG | HTST-105-01-L-DV-A | Samtec
Bus PC/104 | ESQ-126-14-G-D | Samtec
Conector SMP | 18S142-40ML5 | Rosenberger

Sheet: BOM Altium valorizada
Línea | Referencia / nombre Altium | Descripción Altium | Designadores | Cant./tarjeta | Tipo precio | Fuente / proveedor | URL fuente | Advertencias | Ref 10-99 USD/u | Ref 100-999 USD/u | Ref >=1000 USD/u | USD/u lote 10 | USD/u lote 100 | USD/u lote 1000 | USD lote 10 | USD lote 100 | USD lote 1000 | USD/tarj lote 10 | USD/tarj lote 100 | USD/tarj lote 1000
1 | ind 5.6nH 0603 | General Purpose Inductor, 0.0056uH, 5%, 1 Element, Film-Core, Reflow soldering, 0603/0201 | 203 | 1 | ESTIMADO | Supuesto discreto SMD |  | Sin MPN fabricante concreto; precio genérico provisional | $0.24 | $0.15 | $0.10 | $0.24 | $0.15 | $0.10 | $2.40 | $15.00 | $100.00 | $0.24 | $0.15 | $0.10
2 | DEA202450BT-1294D1-H | No Description Available | 300 | 1 | ESTIMADO | Sin cotización exacta |  | Estimación presupuestal; solicitar cotización exacta del MPN | $2.80 | $2.20 | $1.70 | $2.80 | $2.20 | $1.70 | $28.00 | $220.00 | $1700.00 | $2.80 | $2.20 | $1.70
3 | 2450BL15B100E | RF Balun 2.4GHz ~ 2.5GHz 50 / 100Ohm 0805 (2012 Metric) | 302, U304 | 2 | ESTIMADO | Sin cotización exacta |  | Estimación presupuestal; solicitar cotización exacta del MPN | $1.70 | $1.30 | $1.05 | $1.70 | $1.30 | $1.05 | $34.00 | $260.00 | $2100.00 | $3.40 | $2.60 | $2.10
4 | cap 10uf 25v 0805 | 0805 C 10UF Ceramic Multilayer Capacitor, 25 VDC, +85DEGC, X5R Dielec, +/-10% | C1, C3, C5, C10, C11, C18 | 6 | ESTIMADO | Supuesto discreto SMD |  | Sin MPN fabricante concreto; precio genérico provisional | $0.07 | $0.03 | $0.01 | $0.07 | $0.03 | $0.01 | $4.50 | $15.00 | $54.00 | $0.45 | $0.15 | $0.05
5 | cap 3.3nF 0603 16v | Ceramic Capacitor, Multilayer, Ceramic, 16V, 5% +Tol, 5% -Tol, X7R, 15% TC, 0.0033uF, Surface Mount, 0603 | C2, C4, C6 | 3 | ESTIMADO | Supuesto discreto SMD |  | Sin MPN fabricante concreto; precio genérico provisional | $0.07 | $0.03 | $0.01 | $0.07 | $0.03 | $0.01 | $2.25 | $7.50 | $27.00 | $0.23 | $0.07 | $0.03
6 | cap 22uf 0805 | 0805 C0805C 22UF Ceramic Multilayer Capacitor, 6.3V, +85C, X5R Dielectric, +/-10% | C7, C8, C9 | 3 | ESTIMADO | Supuesto discreto SMD |  | Sin MPN fabricante concreto; precio genérico provisional | $0.07 | $0.03 | $0.01 | $0.07 | $0.03 | $0.01 | $2.25 | $7.50 | $27.00 | $0.23 | $0.07 | $0.03
7 | Capacitor 1nF +/-20% 50V 0402 | Chip Capacitor, 1nF +/-20%, 50V, 0402, Thickness 0.33 mm | C12, C13 | 2 | ESTIMADO | Supuesto discreto SMD |  | Sin MPN fabricante concreto; precio genérico provisional | $0.07 | $0.03 | $0.01 | $0.07 | $0.03 | $0.01 | $1.50 | $5.00 | $18.00 | $0.15 | $0.05 | $0.02
8 | Capacitor 1 uF +/- 10% 50 V 0805 | Chip Capacitor, 1 uF, +/- 10%, 50 V, 0805 (2012 Metric) | C14, C15 | 2 | ESTIMADO | Supuesto discreto SMD |  | Sin MPN fabricante concreto; precio genérico provisional | $0.07 | $0.03 | $0.01 | $0.07 | $0.03 | $0.01 | $1.50 | $5.00 | $18.00 | $0.15 | $0.05 | $0.02
9 | Capacitor 4.7µF +/-40% 25V 0805 | Chip Capacitor, 4.7µF +/-40%, 25V, 0805, Thickness 1.45 mm | C16, C17 | 2 | ESTIMADO | Supuesto discreto SMD |  | Sin MPN fabricante concreto; precio genérico provisional | $0.07 | $0.03 | $0.01 | $0.07 | $0.03 | $0.01 | $1.50 | $5.00 | $18.00 | $0.15 | $0.05 | $0.02
10 | Capacitor 100 nF +/-10% 50 V 0805 | Chip Capacitor, 100 nF, +/- 10%, 50 V, 0805 (2012 Metric) | C19, C207, C316 | 3 | ESTIMADO | Supuesto discreto SMD |  | Sin MPN fabricante concreto; precio genérico provisional | $0.07 | $0.03 | $0.01 | $0.07 | $0.03 | $0.01 | $2.25 | $7.50 | $27.00 | $0.23 | $0.07 | $0.03
11 | Capacitor 100nF +/-20% 50V 0402 | Chip Capacitor, 100nF +/-20%, 50V, 0402, Thickness 0.6 mm | C20, C21, C22, C23, C24, C25, C26, C27, C28, C30, C31, C32, C33, C34, C35, C36, C37, C38, C40, C41 | 20 | ESTIMADO | Supuesto discreto SMD |  | Sin MPN fabricante concreto; precio genérico provisional | $0.07 | $0.03 | $0.01 | $0.03 | $0.01 | $0.01 | $5.00 | $18.00 | $180.00 | $0.50 | $0.18 | $0.18
12 | Capacitor 10µF +/-20% 25V 0805 | Chip Capacitor, 10µF +/-20%, 25V, 0805, Thickness 1.45 mm | C29, C39 | 2 | ESTIMADO | Supuesto discreto SMD |  | Sin MPN fabricante concreto; precio genérico provisional | $0.07 | $0.03 | $0.01 | $0.07 | $0.03 | $0.01 | $1.50 | $5.00 | $18.00 | $0.15 | $0.05 | $0.02
13 | Capacitor 1 uF +/- 10% 50 V 0805 | Chip Capacitor, 1 uF, +/- 10%, 50 V, 0805 (2012 Metric) | C42 | 1 | ESTIMADO | Supuesto discreto SMD |  | Sin MPN fabricante concreto; precio genérico provisional | $0.07 | $0.03 | $0.01 | $0.07 | $0.03 | $0.01 | $0.75 | $2.50 | $9.00 | $0.07 | $0.03 | $0.01
14 | Capacitor 100 nF +/-10% 50 V 0805 | Chip Capacitor, 100 nF, +/- 10%, 50 V, 0805 (2012 Metric) | C43, C44, C45, C46, C47, C49, C50, C51, C52 | 9 | ESTIMADO | Supuesto discreto SMD |  | Sin MPN fabricante concreto; precio genérico provisional | $0.07 | $0.03 | $0.01 | $0.07 | $0.03 | $0.01 | $6.75 | $22.50 | $81.00 | $0.68 | $0.23 | $0.08
15 | Capacitor 2,2µF +/-20% 10V 0402 | Chip Capacitor, 2,2µF +/-20%, 10V, 0402, Thickness 0.6 mm | C48, C53 | 2 | ESTIMADO | Supuesto discreto SMD |  | Sin MPN fabricante concreto; precio genérico provisional | $0.07 | $0.03 | $0.01 | $0.07 | $0.03 | $0.01 | $1.50 | $5.00 | $18.00 | $0.15 | $0.05 | $0.02
16 | Capacitor 100 nF +/-10% 50 V 0805 | Chip Capacitor, 100 nF, +/- 10%, 50 V, 0805 (2012 Metric) | C54, C55, C56, C57 | 4 | ESTIMADO | Supuesto discreto SMD |  | Sin MPN fabricante concreto; precio genérico provisional | $0.07 | $0.03 | $0.01 | $0.07 | $0.03 | $0.01 | $3.00 | $10.00 | $36.00 | $0.30 | $0.10 | $0.04
17 | cap 100p | Ceramic Capacitor, Multilayer, Ceramic, 50V, 1% +Tol, 1% -Tol, C0G, 30ppm/Cel TC, 0.0001uF, Surface Mount, 0402 | C200, C204, C205, C206, C208, C209, C301, C302 | 8 | ESTIMADO | Supuesto discreto SMD |  | Sin MPN fabricante concreto; precio genérico provisional | $0.07 | $0.03 | $0.01 | $0.07 | $0.03 | $0.01 | $6.00 | $20.00 | $72.00 | $0.60 | $0.20 | $0.07
18 | Capacitor 0.5 pF +/- 0.1pF 25 V 0402 | Chip Capacitor, 0.5 pF, +/- 0.1pF, 25 V, 0402 (1005 Metric) | C201, C202, C303, C304 | 4 | ESTIMADO | Supuesto discreto SMD |  | Sin MPN fabricante concreto; precio genérico provisional | $0.16 | $0.10 | $0.07 | $0.16 | $0.10 | $0.07 | $6.40 | $40.00 | $280.00 | $0.64 | $0.40 | $0.28
19 | Capacitor 100nF +/-20% 50V 0402 | Chip Capacitor, 100nF +/-20%, 50V, 0402, Thickness 0.6 mm | C203, C305 | 2 | ESTIMADO | Supuesto discreto SMD |  | Sin MPN fabricante concreto; precio genérico provisional | $0.07 | $0.03 | $0.01 | $0.07 | $0.03 | $0.01 | $1.50 | $5.00 | $18.00 | $0.15 | $0.05 | $0.02
20 | Capacitor 10 pF +/- 5% 50 V 0603 | Chip Capacitor, 10 pF, +/- 5%, 50 V, 0603 (1608 Metric) | C211, C220, C318 | 3 | ESTIMADO | Supuesto discreto SMD |  | Sin MPN fabricante concreto; precio genérico provisional | $0.07 | $0.03 | $0.01 | $0.07 | $0.03 | $0.01 | $2.25 | $7.50 | $27.00 | $0.23 | $0.07 | $0.03
21 | cap 20p 0603 | 0603 20 pF 50 V ±10 % Tolerance C0G/NP0 SMT Multilayer Ceramic Capacitor | C212, C216 | 2 | ESTIMADO | Supuesto discreto SMD |  | Sin MPN fabricante concreto; precio genérico provisional | $0.07 | $0.03 | $0.01 | $0.07 | $0.03 | $0.01 | $1.50 | $5.00 | $18.00 | $0.15 | $0.05 | $0.02
22 | cap 100pF 0603 | Ceramic Capacitor, Multilayer, Ceramic, 100V, 10% +Tol, 10% -Tol, C0G, 30ppm/Cel TC, 0.0001uF, Surface Mount, 0603 | C213, C223, C300, C317 | 4 | ESTIMADO | Supuesto discreto SMD |  | Sin MPN fabricante concreto; precio genérico provisional | $0.07 | $0.03 | $0.01 | $0.07 | $0.03 | $0.01 | $3.00 | $10.00 | $36.00 | $0.30 | $0.10 | $0.04
23 | cap 10nF 0603 | Ceramic Capacitor, Multilayer, Ceramic, 50V, 10% +Tol, 10% -Tol, X7R, 15% TC, 0.01uF, Surface Mount, 0603 | C214, C311, C320 | 3 | ESTIMADO | Supuesto discreto SMD |  | Sin MPN fabricante concreto; precio genérico provisional | $0.07 | $0.03 | $0.01 | $0.07 | $0.03 | $0.01 | $2.25 | $7.50 | $27.00 | $0.23 | $0.07 | $0.03
24 | cap 10uF 0603 | 16V 10uF X5R ±10% 0603 Multilayer Ceramic Capacitors MLCC - SMD/SMT ROHS | C215, C312 | 2 | ESTIMADO | Supuesto discreto SMD |  | Sin MPN fabricante concreto; precio genérico provisional | $0.07 | $0.03 | $0.01 | $0.07 | $0.03 | $0.01 | $1.50 | $5.00 | $18.00 | $0.15 | $0.05 | $0.02
25 | cap 6.2pF 0603 | 50V 6.2pF C0G 0603 Multilayer Ceramic Capacitors MLCC - SMD/SMT ROHS | C217 | 1 | ESTIMADO | Supuesto discreto SMD |  | Sin MPN fabricante concreto; precio genérico provisional | $0.07 | $0.03 | $0.01 | $0.07 | $0.03 | $0.01 | $0.75 | $2.50 | $9.00 | $0.07 | $0.03 | $0.01
26 | cap 1.5pF | Ceramic Capacitor, Multilayer, Ceramic, 50V, 16.67% +Tol, 16.67% -Tol, CH, 60ppm/Cel TC, 0.0000015uF, Surface Mount,... | C218, C219 | 2 | ESTIMADO | Supuesto discreto SMD |  | Sin MPN fabricante concreto; precio genérico provisional | $0.16 | $0.10 | $0.07 | $0.16 | $0.10 | $0.07 | $3.20 | $20.00 | $140.00 | $0.32 | $0.20 | $0.14
27 | Capacitor 2,2µF +/-20% 10V 0402 | Chip Capacitor, 2,2µF +/-20%, 10V, 0402, Thickness 0.6 mm | C221 | 1 | ESTIMADO | Supuesto discreto SMD |  | Sin MPN fabricante concreto; precio genérico provisional | $0.07 | $0.03 | $0.01 | $0.07 | $0.03 | $0.01 | $0.75 | $2.50 | $9.00 | $0.07 | $0.03 | $0.01
28 | Capacitor 100 nF +/-10% 50 V 0603 | Chip Capacitor, 100 nF, +/- 10%, 50 V, 0603 (1608 Metric) | C222, C225, C319, C323, C324, C325, C326, C327, C328, C329, C330, C331, C332, C333, C334, C335, C336, C337, C338 | 19 | ESTIMADO | Supuesto discreto SMD |  | Sin MPN fabricante concreto; precio genérico provisional | $0.07 | $0.03 | $0.01 | $0.03 | $0.01 | $0.01 | $4.75 | $17.10 | $171.00 | $0.47 | $0.17 | $0.17
29 | cap 33pF 0603 | Ceramic Capacitor, Multilayer, Ceramic, 50V, 20% +Tol, 20% -Tol, X8R, 15% TC, 3.3e-05uF, Surface Mount, 0603 | C224, C313, C314 | 3 | ESTIMADO | Supuesto discreto SMD |  | Sin MPN fabricante concreto; precio genérico provisional | $0.07 | $0.03 | $0.01 | $0.07 | $0.03 | $0.01 | $2.25 | $7.50 | $27.00 | $0.23 | $0.07 | $0.03
30 | Capacitor 12pF +/-10% 50V 0402 | Chip Capacitor, 12pF +/-10%, 50V, 0402, Thickness 0.33 mm | C306, C310 | 2 | ESTIMADO | Supuesto discreto SMD |  | Sin MPN fabricante concreto; precio genérico provisional | $0.07 | $0.03 | $0.01 | $0.07 | $0.03 | $0.01 | $1.50 | $5.00 | $18.00 | $0.15 | $0.05 | $0.02
31 | cap 1.2pF 0603 | Cap Ceramic 1.2pF 50V C0G 0.5pF SMD 0603 125°C Paper T/R | C307 | 1 | ESTIMADO | Supuesto discreto SMD |  | Sin MPN fabricante concreto; precio genérico provisional | $0.16 | $0.10 | $0.07 | $0.16 | $0.10 | $0.07 | $1.60 | $10.00 | $70.00 | $0.16 | $0.10 | $0.07
32 | cap 2.2pF 0603 | Ceramic Capacitor, Multilayer, Ceramic, 16V, 0% +Tol, 0% -Tol, C0G, 30ppm/Cel TC, 0.0000022uF, Surface Mount, 0603 | C308 | 1 | ESTIMADO | Supuesto discreto SMD |  | Sin MPN fabricante concreto; precio genérico provisional | $0.07 | $0.03 | $0.01 | $0.07 | $0.03 | $0.01 | $0.75 | $2.50 | $9.00 | $0.07 | $0.03 | $0.01
33 | cap 1pF 0603 | Ceramic Capacitor, Multilayer, Ceramic, 50V, 10% +Tol, 10% -Tol, C0G, 30ppm/Cel TC, 1e-06uF, Surface Mount, 0603 | C309 | 1 | ESTIMADO | Supuesto discreto SMD |  | Sin MPN fabricante concreto; precio genérico provisional | $0.07 | $0.03 | $0.01 | $0.07 | $0.03 | $0.01 | $0.75 | $2.50 | $9.00 | $0.07 | $0.03 | $0.01
34 | cap 15pF 0603 | VJ 0603 (1608Metric) Ceramic Capacitor 0.063Lx0.031W 1.60mmx0.80mm C0G NP0 ±10% 15pF | C315 | 1 | ESTIMADO | Supuesto discreto SMD |  | Sin MPN fabricante concreto; precio genérico provisional | $0.07 | $0.03 | $0.01 | $0.07 | $0.03 | $0.01 | $0.75 | $2.50 | $9.00 | $0.07 | $0.03 | $0.01
35 | Capacitor 1uF +/- 10% 16V 0603 | Chip Capacitor, 1 uF, +/- 10%, 16 V, 0603 (1608 Metric) | C321, C322 | 2 | ESTIMADO | Supuesto discreto SMD |  | Sin MPN fabricante concreto; precio genérico provisional | $0.07 | $0.03 | $0.01 | $0.07 | $0.03 | $0.01 | $1.50 | $5.00 | $18.00 | $0.15 | $0.05 | $0.02
36 | SF2421D | No Description Available | FL200 | 1 | ESTIMADO | Sin cotización exacta |  | Estimación presupuestal; solicitar cotización exacta del MPN | $5.50 | $4.20 | $3.20 | $5.50 | $4.20 | $3.20 | $55.00 | $420.00 | $3200.00 | $5.50 | $4.20 | $3.20
37 | SI4464-B1B-FMR | IC RF TxRx + MCU General ISM < 1GHz - 119MHz ~ 1.05GHz 20-VFQFN Exposed Pad | IC200 | 1 | WEB | Mouser | https://www.mouser.com/ProductDetail/Silicon-Labs/SI4464-B1B-FMR?qs=v11sNlF%252BHAdMGha0TrMSMw%3D%3D | Not recommended for new designs (DigiKey) | $7.77 | $6.65 | $5.90 | $7.77 | $6.65 | $5.90 | $77.70 | $665.00 | $5900.00 | $7.77 | $6.65 | $5.90
38 | 18S142-40ML5 | SMP, Mini Connector Plug, Male Pin 50 Ohms Surface Mount Solder | J1, J300 | 2 | ESTIMADO | Sin cotización exacta |  | Estimación presupuestal; solicitar cotización exacta del MPN | $11.00 | $9.50 | $8.20 | $11.00 | $9.50 | $8.20 | $220.00 | $1900.00 | $16400.00 | $22.00 | $19.00 | $16.40
39 | HTST-105-01-L-DV-A | 148 | J3 | 1 | ESTIMADO | Sin cotización exacta |  | Estimación presupuestal; solicitar cotización exacta del MPN | $4.50 | $3.60 | $2.90 | $4.50 | $3.60 | $2.90 | $45.00 | $360.00 | $2900.00 | $4.50 | $3.60 | $2.90
40 | ESQ-126-14-G-D | 148 | J4 | 1 | WEB | DigiKey/Mouser | https://www.digikey.com/es/products/detail/samtec-inc/ESQ-126-14-G-D/6695078 | Mouser 1000 tier; source report lists two PC104 but BOM one | $11.00 | $8.84 | $8.43 | $11.00 | $8.84 | $8.43 | $110.00 | $883.75 | $8430.00 | $11.00 | $8.84 | $8.43
41 | PSA4-5043+ | RF Amplifier IC Cellular, GSM, GPS, ISM, LTE, WCDMA, WiMAX, WLAN 50MHz ~ 4GHz MMM1362 | J200 | 1 | ESTIMADO | Sin cotización exacta |  | Estimación presupuestal; solicitar cotización exacta del MPN | $4.40 | $3.30 | $2.50 | $4.40 | $3.30 | $2.50 | $44.00 | $330.00 | $2500.00 | $4.40 | $3.30 | $2.50
42 | ind 1uH | Inductor General Purpose Chip Wirewound 1uH 20% 7.96MHz Ferrite 0.69A 0.13Ohm DCR 0806 T/R | L1, L2, L3 | 3 | ESTIMADO | Supuesto discreto SMD |  | Sin MPN fabricante concreto; precio genérico provisional | $0.24 | $0.15 | $0.10 | $0.24 | $0.15 | $0.10 | $7.20 | $45.00 | $300.00 | $0.72 | $0.45 | $0.30
43 | ind 100nH | General Purpose Inductor, 0.1uH, 5%, 1 Element, Ceramic-Core, SMD, 0402 | L200 | 1 | ESTIMADO | Supuesto discreto SMD |  | Sin MPN fabricante concreto; precio genérico provisional | $0.24 | $0.15 | $0.10 | $0.24 | $0.15 | $0.10 | $2.40 | $15.00 | $100.00 | $0.24 | $0.15 | $0.10
44 | ind 47nH | Ind RF Chip Unshielded Multi-Layer 47nH 5% 100MHz 6Q-Factor 200mA 0402 Punched Paper T/R | L201 | 1 | ESTIMADO | Supuesto discreto SMD |  | Sin MPN fabricante concreto; precio genérico provisional | $0.24 | $0.15 | $0.10 | $0.24 | $0.15 | $0.10 | $2.40 | $15.00 | $100.00 | $0.24 | $0.15 | $0.10
45 | ind 120nH | Ind Chip Wirewound 120nH 5% 25MHz 60Q-Factor Ceramic 650mA 1008 T/R | L202 | 1 | ESTIMADO | Supuesto discreto SMD |  | Sin MPN fabricante concreto; precio genérico provisional | $0.24 | $0.15 | $0.10 | $0.24 | $0.15 | $0.10 | $2.40 | $15.00 | $100.00 | $0.24 | $0.15 | $0.10
46 | ind 20nH 0402 | General Purpose Inductor, 0.02uH, 3%, 1 Element, Reflow soldering, 1005/0402 | L204, L205, L206 | 3 | ESTIMADO | Supuesto discreto SMD |  | Sin MPN fabricante concreto; precio genérico provisional | $0.24 | $0.15 | $0.10 | $0.24 | $0.15 | $0.10 | $7.20 | $45.00 | $300.00 | $0.72 | $0.45 | $0.30
47 | ind 15nH 0201 | Inductor RF Chip Thin Film 15nH 3% 500MHz 12Q-Factor 250mA 700mOhm DCR 0201 Paper T/R | L300 | 1 | ESTIMADO | Supuesto discreto SMD |  | Sin MPN fabricante concreto; precio genérico provisional | $0.24 | $0.15 | $0.10 | $0.24 | $0.15 | $0.10 | $2.40 | $15.00 | $100.00 | $0.24 | $0.15 | $0.10
48 | ind 3.3nH 0603 | General Purpose Inductor, 0.0033uH, 9.0909%, 1 Element, Reflow soldering, 1608/0603 | L301 | 1 | ESTIMADO | Supuesto discreto SMD |  | Sin MPN fabricante concreto; precio genérico provisional | $0.24 | $0.15 | $0.10 | $0.24 | $0.15 | $0.10 | $2.40 | $15.00 | $100.00 | $0.24 | $0.15 | $0.10
49 | ind 3.9nH 0603 | General Purpose Inductor, 0.0039uH, 7.6923%, 1 Element, Reflow soldering, 1608/0603 | L302 | 1 | ESTIMADO | Supuesto discreto SMD |  | Sin MPN fabricante concreto; precio genérico provisional | $0.24 | $0.15 | $0.10 | $0.24 | $0.15 | $0.10 | $2.40 | $15.00 | $100.00 | $0.24 | $0.15 | $0.10
50 | RES 32.4K 0805 | Fixed Resistor, Metal Glaze/thick Film, 0.25W, 32400ohm, 150V, 0.5% +/-Tol, 100ppm/Cel, Surface Mount, 0805 | R1, R2, R3 | 3 | ESTIMADO | Supuesto discreto SMD |  | Sin MPN fabricante concreto; precio genérico provisional | $0.07 | $0.03 | $0.01 | $0.07 | $0.03 | $0.01 | $2.25 | $7.50 | $27.00 | $0.23 | $0.07 | $0.03
51 | 16.9k 0805 | Fixed Resistor, Metal Glaze/Thick Film, 0.125W, 16900ohm, 150V, 1% +/-Tol, Surface Mount, 0805 | R4 | 1 | ESTIMADO | Supuesto accesorio |  | Clasificación o MPN por precisar | $0.35 | $0.20 | $0.12 | $0.35 | $0.20 | $0.12 | $3.50 | $20.00 | $120.00 | $0.35 | $0.20 | $0.12
52 | res 21k 0805 | 125mW Thin Film Resistor 150V ±0.5% ±25ppm/℃ 21kΩ 0805 Chip Resistor - Surface Mount ROHS | R5 | 1 | ESTIMADO | Supuesto discreto SMD |  | Sin MPN fabricante concreto; precio genérico provisional | $0.07 | $0.03 | $0.01 | $0.07 | $0.03 | $0.01 | $0.75 | $2.50 | $9.00 | $0.07 | $0.03 | $0.01
53 | 68 0805 | Res Thick Film 0805 68 Ohm 5% 0.125W(1/8W) ±200ppm/C Pad SMD T/R Automotive AEC-Q200 | R6, R7 | 2 | ESTIMADO | Supuesto accesorio |  | Clasificación o MPN por precisar | $0.35 | $0.20 | $0.12 | $0.35 | $0.20 | $0.12 | $7.00 | $40.00 | $240.00 | $0.70 | $0.40 | $0.24
54 | Resistor 200K +/-1 % 0402 63 mW | Chip Resistor, 200 kOhms, +/-1 %, 63 mW, -55 to 155 degC, 0402 | R8 | 1 | ESTIMADO | Supuesto discreto SMD |  | Sin MPN fabricante concreto; precio genérico provisional | $0.07 | $0.03 | $0.01 | $0.07 | $0.03 | $0.01 | $0.75 | $2.50 | $9.00 | $0.07 | $0.03 | $0.01
55 | res 30.1k 0603 | Res Thick Film 0603 30.1K Ohm 1% 0.1W(1/10W) ±100ppm/C Pad SMD Automotive T/R | R9 | 1 | ESTIMADO | Supuesto discreto SMD |  | Sin MPN fabricante concreto; precio genérico provisional | $0.07 | $0.03 | $0.01 | $0.07 | $0.03 | $0.01 | $0.75 | $2.50 | $9.00 | $0.07 | $0.03 | $0.01
56 | res 249 0603 | 100mW Thin Film Resistor 75V ±25ppm/℃ ±0.1% 249Ω 0603 Chip Resistor - Surface Mount ROHS | R10 | 1 | ESTIMADO | Supuesto discreto SMD |  | Sin MPN fabricante concreto; precio genérico provisional | $0.07 | $0.03 | $0.01 | $0.07 | $0.03 | $0.01 | $0.75 | $2.50 | $9.00 | $0.07 | $0.03 | $0.01
57 | res 402k 0805 | Fixed Resistor, Metal Glaze/Thick Film, 0.125W, 402000ohm, 150V, 1% +/-Tol, Surface Mount, 0805 | R11 | 1 | ESTIMADO | Supuesto discreto SMD |  | Sin MPN fabricante concreto; precio genérico provisional | $0.07 | $0.03 | $0.01 | $0.07 | $0.03 | $0.01 | $0.75 | $2.50 | $9.00 | $0.07 | $0.03 | $0.01
58 | res 49.9k | Res Thick Film 0201 49.9K Ohm 1% 1/20W ±200ppm/°C Molded SMD SMD T/R | R12 | 1 | ESTIMADO | Supuesto discreto SMD |  | Sin MPN fabricante concreto; precio genérico provisional | $0.07 | $0.03 | $0.01 | $0.07 | $0.03 | $0.01 | $0.75 | $2.50 | $9.00 | $0.07 | $0.03 | $0.01
59 | Resistor 4k7 +/-1% 0805 125 mW | Chip Resistor, 4.7 KOhm, +/- 1%, 0.125 W, -55 to 155 degC, 0805 (2012 Metric) | R13, R14, R16 | 3 | ESTIMADO | Supuesto discreto SMD |  | Sin MPN fabricante concreto; precio genérico provisional | $0.07 | $0.03 | $0.01 | $0.07 | $0.03 | $0.01 | $2.25 | $7.50 | $27.00 | $0.23 | $0.07 | $0.03
60 | res 0.02 0603 | Res Thick Film 0603 0.02 Ohm 1% 0.125W ±300ppm/°C Molded SMD Paper T/R | R15 | 1 | ESTIMADO | Supuesto discreto SMD |  | Sin MPN fabricante concreto; precio genérico provisional | $0.07 | $0.03 | $0.01 | $0.07 | $0.03 | $0.01 | $0.75 | $2.50 | $9.00 | $0.07 | $0.03 | $0.01
61 | Resistor 4k7 +/-1% 0603 100 mW | Chip Resistor, 4.7 KOhm, +/- 1%, 0.1 W, -55 to 155 degC, 0603 (1608 Metric) | R17 | 1 | ESTIMADO | Supuesto discreto SMD |  | Sin MPN fabricante concreto; precio genérico provisional | $0.07 | $0.03 | $0.01 | $0.07 | $0.03 | $0.01 | $0.75 | $2.50 | $9.00 | $0.07 | $0.03 | $0.01
62 | Resistor 1K +/-5% 0805 125 mW | Chip Resistor, 1 kOhms, +/-5%, 125 mW, -55 to 155 degC, 0805 | R18, R19, R21, R22 | 4 | ESTIMADO | Supuesto discreto SMD |  | Sin MPN fabricante concreto; precio genérico provisional | $0.07 | $0.03 | $0.01 | $0.07 | $0.03 | $0.01 | $3.00 | $10.00 | $36.00 | $0.30 | $0.10 | $0.04
63 | Resistor 10k +/-1% 0805 125 mW | Chip Resistor, 10 KOhm, +/- 1%, 125 mW, -55 to 155 degC, 0805 (2012 Metric) | R20, R24 | 2 | ESTIMADO | Supuesto discreto SMD |  | Sin MPN fabricante concreto; precio genérico provisional | $0.07 | $0.03 | $0.01 | $0.07 | $0.03 | $0.01 | $1.50 | $5.00 | $18.00 | $0.15 | $0.05 | $0.02
64 | 240R2J | 240R 0.063W 5% 0402 (1005 Metric) SMD | R23 | 1 | ESTIMADO | Supuesto discreto SMD |  | Sin MPN fabricante concreto; precio genérico provisional | $0.07 | $0.03 | $0.01 | $0.07 | $0.03 | $0.01 | $0.75 | $2.50 | $9.00 | $0.07 | $0.03 | $0.01
65 | 22R2J | 22R 0.063W 5% 0402 (1005 Metric) SMD | R25 | 1 | ESTIMADO | Supuesto discreto SMD |  | Sin MPN fabricante concreto; precio genérico provisional | $0.07 | $0.03 | $0.01 | $0.07 | $0.03 | $0.01 | $0.75 | $2.50 | $9.00 | $0.07 | $0.03 | $0.01
66 | Resistor 10k +/-1% 0805 125 mW | Chip Resistor, 10 KOhm, +/- 1%, 125 mW, -55 to 155 degC, 0805 (2012 Metric) | R26, R27, R28, R29, R30, R31, R32, R33, R34, R35, R36, R37, R38, R39, R40, R41, R42, R43, R44, R45 | 20 | ESTIMADO | Supuesto discreto SMD |  | Sin MPN fabricante concreto; precio genérico provisional | $0.07 | $0.03 | $0.01 | $0.03 | $0.01 | $0.01 | $5.00 | $18.00 | $180.00 | $0.50 | $0.18 | $0.18
67 | Resistor 1K +/-5% 0805 125 mW | Chip Resistor, 1 kOhms, +/-5%, 125 mW, -55 to 155 degC, 0805 | R200, R300 | 2 | ESTIMADO | Supuesto discreto SMD |  | Sin MPN fabricante concreto; precio genérico provisional | $0.07 | $0.03 | $0.01 | $0.07 | $0.03 | $0.01 | $1.50 | $5.00 | $18.00 | $0.15 | $0.05 | $0.02
68 | res 2ohms 0603 | Res Thick Film 0603 2 Ohm 5% 0.1W(1/10W) ±200ppm/C Pad SMD Automotive T/R | R201 | 1 | ESTIMADO | Supuesto discreto SMD |  | Sin MPN fabricante concreto; precio genérico provisional | $0.07 | $0.03 | $0.01 | $0.07 | $0.03 | $0.01 | $0.75 | $2.50 | $9.00 | $0.07 | $0.03 | $0.01
69 | Resistor 10k +/-1% 0805 125 mW | Chip Resistor, 10 KOhm, +/- 1%, 125 mW, -55 to 155 degC, 0805 (2012 Metric) | R202, R302 | 2 | ESTIMADO | Supuesto discreto SMD |  | Sin MPN fabricante concreto; precio genérico provisional | $0.07 | $0.03 | $0.01 | $0.07 | $0.03 | $0.01 | $1.50 | $5.00 | $18.00 | $0.15 | $0.05 | $0.02
70 | res 1.2k 0805 | Fixed Resistor, Metal Glaze/thick Film, 0.125W, 1200ohm, 500V, 1% +/-Tol, 100ppm/Cel, Surface Mount, 0805 | R301 | 1 | ESTIMADO | Supuesto discreto SMD |  | Sin MPN fabricante concreto; precio genérico provisional | $0.07 | $0.03 | $0.01 | $0.07 | $0.03 | $0.01 | $0.75 | $2.50 | $9.00 | $0.07 | $0.03 | $0.01
71 | 10R2F | 10R 0.063W 1% 0402 (1005 Metric) SMD | R303, R304 | 2 | ESTIMADO | Supuesto discreto SMD |  | Sin MPN fabricante concreto; precio genérico provisional | $0.07 | $0.03 | $0.01 | $0.07 | $0.03 | $0.01 | $1.50 | $5.00 | $18.00 | $0.15 | $0.05 | $0.02
72 | Resistor 10k +/-1% 0603 100 mW | Chip Resistor, 10 KOhm, +/- 1%, 01 W, -55 to 155 degC, 0603 (1608 Metric) | R305 | 1 | ESTIMADO | Supuesto discreto SMD |  | Sin MPN fabricante concreto; precio genérico provisional | $0.07 | $0.03 | $0.01 | $0.07 | $0.03 | $0.01 | $0.75 | $2.50 | $9.00 | $0.07 | $0.03 | $0.01
73 | res 14.3k 0603 | Fixed Resistor, Thin Film, 0.1W, 14300ohm, 75V, 0.1% +/-Tol, 25ppm/Cel, Surface Mount, 0603 | R306 | 1 | ESTIMADO | Supuesto discreto SMD |  | Sin MPN fabricante concreto; precio genérico provisional | $0.07 | $0.03 | $0.01 | $0.07 | $0.03 | $0.01 | $0.75 | $2.50 | $9.00 | $0.07 | $0.03 | $0.01
74 | M2S050-FG484 | Description | U16 | 1 | WEB / proxy documentado | Mouser (industrial suffix compared) | https://www.mouser.com/ProductDetail/Microchip-Technology/M2S050-FG484I?qs=pU29NIZ4ZwD2tgyTpjfp5g%3D%3D | Proxy M2S050-FG484I: BOM exact lacks I; 1000 tier inferred from FG484 non-stock 60 MOQ | $147.45 | $138.68 | $116.25 | $147.45 | $138.68 | $116.25 | $1474.50 | $13868.00 | $116250.00 | $147.45 | $138.68 | $116.25
75 | TPS3823-33DBVT | Active-low, push-pull, voltage supervisor (reset IC) with 1.6-s watchdog & manual reset | U17 | 1 | ESTIMADO | Sin cotización exacta |  | Estimación presupuestal; solicitar cotización exacta del MPN | $1.45 | $1.15 | $0.90 | $1.45 | $1.15 | $0.90 | $14.50 | $115.00 | $900.00 | $1.45 | $1.15 | $0.90
76 | TPS62903QRYTRQ1 | Automotive, 3-V to 18-V, 3-A low-IQ synchronous buck converter with 165Â°C junction temperature 9-VQFN-HR -40 to 165 | U100, U101, U102 | 3 | WEB | LCSC via DigiPart | https://www.digipart.com/part/TPS62903 | 1000 unit price held at 100 tier due no quote; limited 16 units observed | $7.37 | $5.97 | $5.97 | $7.37 | $5.97 | $5.97 | $221.04 | $1789.80 | $17898.00 | $22.10 | $17.90 | $17.90
77 | TPS22918TDBVRQ1 | 1-ch, 5.5-V, 2-A, 52-mÎ© automotive load switch with adj. rise time and adj. output discharg | U103, U104 | 2 | WEB | DigiKey | https://www.digikey.com/en/products/detail/texas-instruments/TPS22918TDBVRQ1/6164978 | Zero stock noted; prices are reference | $0.53 | $0.42 | $0.36 | $0.53 | $0.42 | $0.36 | $10.66 | $83.86 | $719.28 | $1.07 | $0.84 | $0.72
78 | LT3045IMSE#WPBF | 20V, 500mA, Ultralow Noise, Ultrahigh PSRR Linear Regulator | U105 | 1 | ESTIMADO | Sin cotización exacta |  | Estimación presupuestal; solicitar cotización exacta del MPN | $9.00 | $7.20 | $5.80 | $9.00 | $7.20 | $5.80 | $90.00 | $720.00 | $5800.00 | $9.00 | $7.20 | $5.80
79 | INA226AIDGST | 36V, 16-bit, ultra-precise i2c output current/voltage/power monitor w/alert | U106 | 1 | ESTIMADO | Sin cotización exacta |  | Estimación presupuestal; solicitar cotización exacta del MPN | $3.20 | $2.40 | $1.85 | $3.20 | $2.40 | $1.85 | $32.00 | $240.00 | $1850.00 | $3.20 | $2.40 | $1.85
80 | PE4259 | RF Switch IC General Purpose SPDT 3 GHz 50Ohm SC-70-6 | U200, U300 | 2 | ESTIMADO | Sin cotización exacta |  | Estimación presupuestal; solicitar cotización exacta del MPN | $6.80 | $5.10 | $3.90 | $6.80 | $5.10 | $3.90 | $136.00 | $1020.00 | $7800.00 | $13.60 | $10.20 | $7.80
81 | ADL5324ARKZ-R7 | 400 MHz TO 4000 MHz Â½ Watt RF Driver Amplifier | U201 | 1 | WEB | Mouser | https://www.mouser.com/ProductDetail/Analog-Devices/ADL5324ARKZ-R7?qs=BpaRKvA4VqGlr8vJaaqhsQ%3D%3D | 1000 reel tier may require full reel | $8.59 | $7.41 | $6.64 | $8.59 | $7.41 | $6.64 | $85.90 | $741.00 | $6640.00 | $8.59 | $7.41 | $6.64
82 | ADL5320ARKZ-R7 | 400 MHz TO 2700 MHz Â¼ Watt RF Driver Amplifier | U301 | 1 | WEB | DigiKey | https://www.digikey.com/en/products/detail/analog-devices-inc/ADL5320ARKZ-R7/1894589 | Published tier schedule | $7.10 | $6.20 | $5.46 | $7.10 | $6.20 | $5.46 | $70.97 | $620.12 | $5464.83 | $7.10 | $6.20 | $5.46
83 | MAX2644EXT-T | 2.4GHz SiGe, High IP3 Low-Noise Amplifier | U303 | 1 | WEB | DigiKey (+T suffix proxy) | https://www.digikey.com/en/products/detail/analog-devices-inc-maxim-integrated/MAX2644EXT-T/1867431 | BOM lacks +; optional in text but populated in Altium | $6.45 | $5.63 | $4.96 | $6.45 | $5.63 | $4.96 | $64.50 | $563.25 | $4960.49 | $6.45 | $5.63 | $4.96
84 | AD9364BBCZ | 1 x 1 RF Agile Transceiver | U305 | 1 | ESTIMADO | Sin cotización exacta |  | Estimación presupuestal; solicitar cotización exacta del MPN | $195.00 | $172.00 | $145.00 | $195.00 | $172.00 | $145.00 | $1950.00 | $17200.00 | $145000.00 | $195.00 | $172.00 | $145.00
85 | IS43TR16256A-125KBL | No Description Available | U400 | 1 | ESTIMADO | Sin cotización exacta |  | Estimación presupuestal; solicitar cotización exacta del MPN | $21.00 | $17.00 | $13.00 | $21.00 | $17.00 | $13.00 | $210.00 | $1700.00 | $13000.00 | $21.00 | $17.00 | $13.00
86 | MTFC32GAPALBH-AAT | No Description Available | U401 | 1 | ESTIMADO | Sin cotización exacta |  | Estimación presupuestal; solicitar cotización exacta del MPN | $32.00 | $26.00 | $21.00 | $32.00 | $26.00 | $21.00 | $320.00 | $2600.00 | $21000.00 | $32.00 | $26.00 | $21.00
87 | MR4A16BCYS35R | No Description Available | U402, U403 | 2 | WEB | Mouser | https://www.mouser.com/en/ProductDetail/Everspin-Technologies/MR4A16BCYS35R?qs=lzGMqP3RDOJSuPZIqvmzOw%3D%3D | Tier 1000 reel; qty 20 at 10 boards priced tier 10 | $60.10 | $55.27 | $50.73 | $60.10 | $55.27 | $50.73 | $1202.00 | $11054.00 | $101460.00 | $120.20 | $110.54 | $101.46
88 | S3A33025-50.000-L-X-R | 148 | Y3 | 1 | ESTIMADO | Sin cotización exacta |  | Estimación presupuestal; solicitar cotización exacta del MPN | $4.80 | $3.80 | $3.10 | $4.80 | $3.80 | $3.10 | $48.00 | $380.00 | $3100.00 | $4.80 | $3.80 | $3.10
89 | S733025T-40.000-15-R | 148 | Y300 | 1 | ESTIMADO | Sin cotización exacta |  | Estimación presupuestal; solicitar cotización exacta del MPN | $5.50 | $4.50 | $3.70 | $5.50 | $4.50 | $3.70 | $55.00 | $450.00 | $3700.00 | $5.50 | $4.50 | $3.70
TOTAL |  |  |  |  |  |  |  |  |  |  |  |  |  |  | $6746.67 | $58829.38 | $502316.60 | $674.67 | $588.29 | $502.32

Sheet: Costos 10 100 1000
Lote tarjetas | Costo lote USD | Costo por tarjeta USD | Parte web USD | Parte estimada USD | Cobertura web %
10 | $6746.67 | $674.67 | $3317.27 | $3429.40 | 49.2%
100 | $58829.38 | $588.29 | $30268.78 | $28560.60 | 51.5%
1000 | $502316.60 | $502.32 | $267722.60 | $234594.00 | 53.3%

Sheet: Criterios cotizacion
Campo | Criterio
Fecha referencia | 2026-10-26
Moneda | USD
Configuración | Se presupuestan las 89 líneas de Altium tal como fueron exportadas; MAX2644 incluido pese a anotación opcional
Precios WEB | Datos publicados en enlaces citados, algunos precios por sustituto de sufijo explícitamente documentados
Precios ESTIMADO | Hipótesis de ingeniería; no son cotizaciones verificadas
Escalas | Se aplica tramo de precio según unidades totales por línea: <100, 100-999, >=1000; a falta de tramos se aproxima
Exclusiones | Sin PCB, ensamblaje, flete, IVA, aranceles, merma o MOQ adicional
Riesgos | Micron eMMC obsoleta; SoC sufijo distinto; si se exige compra real, verificar disponibilidad, MOQ y actualización de precios
