juanjodiaz04/Proyecto_Diseno_Productos/Tablas/Especificaciones_Tecnicas_CubeSat.xlsx

Categoría | Componente | Referencia | Parámetro Principal | Valor Principal | Parámetro Secundario | Valor Secundario | Notas
Lógica y Memoria | SoC | Microchip M2S050-FGG484I | Arquitectura | ARM Cortex-M3 + FPGA Flash | Tolerancia a Radiación | Inmune a SEUs | Soporta LPDDR/DDR2/DDR3 con SECDED
Lógica y Memoria | Memoria No Volátil (MRAM) | Everspin MR4A16BCYS35 | Capacidad | 2 MB por chip | Rango de Temperatura | -40 °C a +85 °C | Escrituras infinitas; usar 2 a 4 uds para firmware
Lógica y Memoria | Memoria RAM (DDR3L) | ISSI IS43TR16256A-125KBLI | Capacidad | 4 Gb (512 MB) | Voltaje de Operación | 1.35 V | Búfer de trabajo para la FPGA
Lógica y Memoria | Almacenamiento Masivo (eMMC) | Micron MTFC32GAPALBH-AAT | Capacidad | 32 GB | Grado / Calificación | Automotriz AEC-Q100 | Almacena las fotos multiespectrales en bruto
Lógica y Memoria | Oscilador VCTCXO | Rakon RPT7050A | Frecuencia | 50 MHz | Estabilidad Térmica | Compensado por temperatura | Reloj de sistema para la FPGA
UHF (435-438 MHz) | Transceptor RFIC | Silicon Labs Si4468-A2A-IM | Rango de Frecuencia | 142 a 1050 MHz | Potencia TX / Sensibilidad RX | +20 dBm / -133 dBm | QFN-20. El FEC (Reed-Solomon) se hace en la FPGA
UHF (435-438 MHz) | Amplificador de Potencia (PA) | Analog Devices ADL5324 | Rango de Frecuencia | 400 a 4000 MHz | Potencia de Salida Estimada | ~0.5 W (a 436 MHz) | P1dB de 29.1 dBm (medido a 2.14 GHz)
UHF (435-438 MHz) | LNA de Recepción | Qorvo TQP3M9018 | Figura de Ruido / Ganancia | 1.3 dB / 20.5 dB | Rango de Frecuencia | 0.05 a 4 GHz | Consume 85 mA. Reemplaza al TQP3M9008
UHF (435-438 MHz) | Filtro SAW de RX | RFMi SF2446E | Frecuencia Central | 435 MHz | Ancho de Banda / Pérdida | 23 MHz / 1.9 dB | Solo para RX (Soporta <10 mW)
UHF / S-Band | Switch TX/RX | pSemi PE4259 | Rango de Frecuencia | 10 MHz a 3 GHz | Potencia Máxima RF | Hasta 34 dBm | Tecnología UltraCMOS. SPDT.
Banda S (2.4-2.45 GHz) | Transceptor SDR | Analog Devices AD9364BBCZ | Rango de Frecuencia | 70 MHz a 6 GHz | Potencia de Salida Nativa | ~7.5 dBm | CSP-BGA 144 bolas. Rieles: 1.3V, 1.8V, 3.3V
Banda S (2.4-2.45 GHz) | Driver / Preamplificador | Analog Devices ADL5320 | Rango de Frecuencia | 400 a 2700 MHz | P1dB | 25.4 dBm (a 880 MHz) | Necesario para subir de 7.5 dBm hacia el PA
Banda S (2.4-2.45 GHz) | Amplificador de Potencia (PA) | Analog Devices ADL5324 | Rango de Frecuencia | 400 a 4000 MHz | Potencia de Salida Estimada | 0.4 W a 0.5 W en antena | Mismo PA que UHF pero con red adaptada a 2.4 GHz
Banda S (2.4-2.45 GHz) | Filtro Pasa-Banda TX | Johanson 2450BP15H0100 | Banda de Paso | 2400 a 2500 MHz | Manejo de Potencia / Pérdida | 2 W / 1.8 dB | Filtro pasivo LTCC cerámico
Banda S (2.4-2.45 GHz) | Balun (Transformador RF) | Johanson 2450BL15B100 | Banda de Paso | 2400 a 2500 MHz | Relación de Impedancia | 1:2 | Soporta ráfagas de hasta 3 W
Banda S (2.4-2.45 GHz) | Oscilador TCXO (Referencia) | Rakon 40 MHz | Frecuencia Exacta | 40.000 MHz | - | - | Obligatorio para estabilidad de fase del AD9364
Energía | Reguladores Switching | Texas Instruments TPS62130A-Q1 | Voltaje de Entrada / Salida | Vin 3V-17V / Vout variable | Corriente de Salida | Hasta 3 A | Genera rieles de potencia en bruto (1.2V, 1.8V, 3.3V)
Energía | LDO Ultra Bajo Ruido | Analog Devices LT3042 | Ruido RMS | 0.8 µVrms (10Hz-100kHz) | Corriente de Salida | 200 mA | Crítico para alimentar el núcleo 1.3V de las radios
Energía | Monitor de Corriente / SEL | Texas Instruments INA226 | Interfaz de Comunicación | I2C | Error de Precisión Máximo | 1% | El pin ALERT se cablea por hardware para apagar los rieles
Materiales | Sustrato de PCB (RF) | Rogers RO4350B | Constante Dieléctrica (Dk) | 3.48 | Factor de Disipación (Df) | 0.0037 a 10 GHz | Indispensable para las capas exteriores de Radiofrecuencia
