juanjodiaz04/Proyecto_Diseno_Productos/Lab4_Altium_Files/Project Outputs for Lab4_Altium_Files/Lab4_Altium_Files.xlsx

Line # | Name | Description | Designator | Quantity
1 | ind 5.6nH 0603 | General Purpose Inductor, 0.0056uH, 5%, 1 Element, Film-Core, Reflow soldering, 0603/0201 | 203 | 1
2 | DEA202450BT-1294D1-H | No Description Available | 300 | 1
3 | 2450BL15B100E | RF Balun 2.4GHz ~ 2.5GHz 50 / 100Ohm 0805 (2012 Metric) | 302, U304 | 2
4 | cap 10uf 25v 0805 | 0805 C 10UF Ceramic Multilayer Capacitor, 25 VDC, +85DEGC, X5R Dielec, +/-10% | C1, C3, C5, C10, C11, C18 | 6
5 | cap 3.3nF 0603 16v | Ceramic Capacitor, Multilayer, Ceramic, 16V, 5% +Tol, 5% -Tol, X7R, 15% TC, 0.0033uF, Surface Mount, 0603 | C2, C4, C6 | 3
6 | cap 22uf 0805 | 0805 C0805C 22UF Ceramic Multilayer Capacitor, 6.3V, +85C, X5R Dielectric, +/-10% | C7, C8, C9 | 3
7 | Capacitor 1nF +/-20% 50V 0402 | Chip Capacitor, 1nF +/-20%, 50V, 0402, Thickness 0.33 mm | C12, C13 | 2
8 | Capacitor 1 uF +/- 10% 50 V 0805 | Chip Capacitor, 1 uF, +/- 10%, 50 V, 0805 (2012 Metric) | C14, C15 | 2
9 | Capacitor 4.7µF +/-40% 25V 0805 | Chip Capacitor, 4.7µF +/-40%, 25V, 0805, Thickness 1.45 mm | C16, C17 | 2
10 | Capacitor 100 nF +/-10% 50 V 0805 | Chip Capacitor, 100 nF, +/- 10%, 50 V, 0805 (2012 Metric) | C19, C207, C316 | 3
11 | Capacitor 100nF +/-20% 50V 0402 | Chip Capacitor, 100nF +/-20%, 50V, 0402, Thickness 0.6 mm | C20, C21, C22, C23, C24, C25, C26, C27, C28, C30, C31, C32, C33, C34, C35, C36, C37, C38, C40, C41 | 20
12 | Capacitor 10µF +/-20% 25V 0805 | Chip Capacitor, 10µF +/-20%, 25V, 0805, Thickness 1.45 mm | C29, C39 | 2
13 | Capacitor 1 uF +/- 10% 50 V 0805 | Chip Capacitor, 1 uF, +/- 10%, 50 V, 0805 (2012 Metric) | C42 | 1
14 | Capacitor 100 nF +/-10% 50 V 0805 | Chip Capacitor, 100 nF, +/- 10%, 50 V, 0805 (2012 Metric) | C43, C44, C45, C46, C47, C49, C50, C51, C52 | 9
15 | Capacitor 2,2µF +/-20% 10V 0402 | Chip Capacitor, 2,2µF +/-20%, 10V, 0402, Thickness 0.6 mm | C48, C53 | 2
16 | Capacitor 100 nF +/-10% 50 V 0805 | Chip Capacitor, 100 nF, +/- 10%, 50 V, 0805 (2012 Metric) | C54, C55, C56, C57 | 4
17 | cap 100p | Ceramic Capacitor, Multilayer, Ceramic, 50V, 1% +Tol, 1% -Tol, C0G, 30ppm/Cel TC, 0.0001uF, Surface Mount, 0402 | C200, C204, C205, C206, C208, C209, C301, C302 | 8
18 | Capacitor 0.5 pF +/- 0.1pF 25 V 0402 | Chip Capacitor, 0.5 pF, +/- 0.1pF, 25 V, 0402 (1005 Metric) | C201, C202, C303, C304 | 4
19 | Capacitor 100nF +/-20% 50V 0402 | Chip Capacitor, 100nF +/-20%, 50V, 0402, Thickness 0.6 mm | C203, C305 | 2
20 | Capacitor 10 pF +/- 5% 50 V 0603 | Chip Capacitor, 10 pF, +/- 5%, 50 V, 0603 (1608 Metric) | C211, C220, C318 | 3
21 | cap 20p 0603 | 0603 20 pF 50 V ±10 % Tolerance C0G/NP0 SMT Multilayer Ceramic Capacitor | C212, C216 | 2
22 | cap 100pF 0603 | Ceramic Capacitor, Multilayer, Ceramic, 100V, 10% +Tol, 10% -Tol, C0G, 30ppm/Cel TC, 0.0001uF, Surface Mount, 0603 | C213, C223, C300, C317 | 4
23 | cap 10nF 0603 | Ceramic Capacitor, Multilayer, Ceramic, 50V, 10% +Tol, 10% -Tol, X7R, 15% TC, 0.01uF, Surface Mount, 0603 | C214, C311, C320 | 3
24 | cap 10uF 0603 | 16V 10uF X5R ±10% 0603 Multilayer Ceramic Capacitors MLCC - SMD/SMT ROHS | C215, C312 | 2
25 | cap 6.2pF 0603 | 50V 6.2pF C0G 0603 Multilayer Ceramic Capacitors MLCC - SMD/SMT ROHS | C217 | 1
26 | cap 1.5pF | Ceramic Capacitor, Multilayer, Ceramic, 50V, 16.67% +Tol, 16.67% -Tol, CH, 60ppm/Cel TC, 0.0000015uF, Surface Mount,... | C218, C219 | 2
27 | Capacitor 2,2µF +/-20% 10V 0402 | Chip Capacitor, 2,2µF +/-20%, 10V, 0402, Thickness 0.6 mm | C221 | 1
28 | Capacitor 100 nF +/-10% 50 V 0603 | Chip Capacitor, 100 nF, +/- 10%, 50 V, 0603 (1608 Metric) | C222, C225, C319, C323, C324, C325, C326, C327, C328, C329, C330, C331, C332, C333, C334, C335, C336, C337, C338 | 19
29 | cap 33pF 0603 | Ceramic Capacitor, Multilayer, Ceramic, 50V, 20% +Tol, 20% -Tol, X8R, 15% TC, 3.3e-05uF, Surface Mount, 0603 | C224, C313, C314 | 3
30 | Capacitor 12pF +/-10% 50V 0402 | Chip Capacitor, 12pF +/-10%, 50V, 0402, Thickness 0.33 mm | C306, C310 | 2
31 | cap 1.2pF 0603 | Cap Ceramic 1.2pF 50V C0G 0.5pF SMD 0603 125°C Paper T/R | C307 | 1
32 | cap 2.2pF 0603 | Ceramic Capacitor, Multilayer, Ceramic, 16V, 0% +Tol, 0% -Tol, C0G, 30ppm/Cel TC, 0.0000022uF, Surface Mount, 0603 | C308 | 1
33 | cap 1pF 0603 | Ceramic Capacitor, Multilayer, Ceramic, 50V, 10% +Tol, 10% -Tol, C0G, 30ppm/Cel TC, 1e-06uF, Surface Mount, 0603 | C309 | 1
34 | cap 15pF 0603 | VJ 0603 (1608Metric) Ceramic Capacitor 0.063Lx0.031W 1.60mmx0.80mm C0G NP0 ±10% 15pF | C315 | 1
35 | Capacitor 1uF +/- 10% 16V 0603 | Chip Capacitor, 1 uF, +/- 10%, 16 V, 0603 (1608 Metric) | C321, C322 | 2
36 | SF2421D | No Description Available | FL200 | 1
37 | SI4464-B1B-FMR | IC RF TxRx + MCU General ISM < 1GHz - 119MHz ~ 1.05GHz 20-VFQFN Exposed Pad | IC200 | 1
38 | 18S142-40ML5 | SMP, Mini Connector Plug, Male Pin 50 Ohms Surface Mount Solder | J1, J300 | 2
39 | HTST-105-01-L-DV-A |  | J3 | 1
40 | ESQ-126-14-G-D |  | J4 | 1
41 | PSA4-5043+ | RF Amplifier IC Cellular, GSM, GPS, ISM, LTE, WCDMA, WiMAX, WLAN 50MHz ~ 4GHz MMM1362 | J200 | 1
42 | ind 1uH | Inductor General Purpose Chip Wirewound 1uH 20% 7.96MHz Ferrite 0.69A 0.13Ohm DCR 0806 T/R | L1, L2, L3 | 3
43 | ind 100nH | General Purpose Inductor, 0.1uH, 5%, 1 Element, Ceramic-Core, SMD, 0402 | L200 | 1
44 | ind 47nH | Ind RF Chip Unshielded Multi-Layer 47nH 5% 100MHz 6Q-Factor 200mA 0402 Punched Paper T/R | L201 | 1
45 | ind 120nH | Ind Chip Wirewound 120nH 5% 25MHz 60Q-Factor Ceramic 650mA 1008 T/R | L202 | 1
46 | ind 20nH 0402 | General Purpose Inductor, 0.02uH, 3%, 1 Element, Reflow soldering, 1005/0402 | L204, L205, L206 | 3
47 | ind 15nH 0201 | Inductor RF Chip Thin Film 15nH 3% 500MHz 12Q-Factor 250mA 700mOhm DCR 0201 Paper T/R | L300 | 1
48 | ind 3.3nH 0603 | General Purpose Inductor, 0.0033uH, 9.0909%, 1 Element, Reflow soldering, 1608/0603 | L301 | 1
49 | ind 3.9nH 0603 | General Purpose Inductor, 0.0039uH, 7.6923%, 1 Element, Reflow soldering, 1608/0603 | L302 | 1
50 | RES 32.4K 0805 | Fixed Resistor, Metal Glaze/thick Film, 0.25W, 32400ohm, 150V, 0.5% +/-Tol, 100ppm/Cel, Surface Mount, 0805 | R1, R2, R3 | 3
51 | 16.9k 0805 | Fixed Resistor, Metal Glaze/Thick Film, 0.125W, 16900ohm, 150V, 1% +/-Tol, Surface Mount, 0805 | R4 | 1
52 | res 21k 0805 | 125mW Thin Film Resistor 150V ±0.5% ±25ppm/℃ 21kΩ 0805 Chip Resistor - Surface Mount ROHS | R5 | 1
53 | 68 0805 | Res Thick Film 0805 68 Ohm 5% 0.125W(1/8W) ±200ppm/C Pad SMD T/R Automotive AEC-Q200 | R6, R7 | 2
54 | Resistor 200K +/-1 % 0402 63 mW | Chip Resistor, 200 kOhms, +/-1 %, 63 mW, -55 to 155 degC, 0402 | R8 | 1
55 | res 30.1k 0603 | Res Thick Film 0603 30.1K Ohm 1% 0.1W(1/10W) ±100ppm/C Pad SMD Automotive T/R | R9 | 1
56 | res 249 0603 | 100mW Thin Film Resistor 75V ±25ppm/℃ ±0.1% 249Ω 0603 Chip Resistor - Surface Mount ROHS | R10 | 1
57 | res 402k 0805 | Fixed Resistor, Metal Glaze/Thick Film, 0.125W, 402000ohm, 150V, 1% +/-Tol, Surface Mount, 0805 | R11 | 1
58 | res 49.9k | Res Thick Film 0201 49.9K Ohm 1% 1/20W ±200ppm/°C Molded SMD SMD T/R | R12 | 1
59 | Resistor 4k7 +/-1% 0805 125 mW | Chip Resistor, 4.7 KOhm, +/- 1%, 0.125 W, -55 to 155 degC, 0805 (2012 Metric) | R13, R14, R16 | 3
60 | res 0.02 0603 | Res Thick Film 0603 0.02 Ohm 1% 0.125W ±300ppm/°C Molded SMD Paper T/R | R15 | 1
61 | Resistor 4k7 +/-1% 0603 100 mW | Chip Resistor, 4.7 KOhm, +/- 1%, 0.1 W, -55 to 155 degC, 0603 (1608 Metric) | R17 | 1
62 | Resistor 1K +/-5% 0805 125 mW | Chip Resistor, 1 kOhms, +/-5%, 125 mW, -55 to 155 degC, 0805 | R18, R19, R21, R22 | 4
63 | Resistor 10k +/-1% 0805 125 mW | Chip Resistor, 10 KOhm, +/- 1%, 125 mW, -55 to 155 degC, 0805 (2012 Metric) | R20, R24 | 2
64 | 240R2J | 240R 0.063W 5% 0402 (1005 Metric) SMD | R23 | 1
65 | 22R2J | 22R 0.063W 5% 0402 (1005 Metric) SMD | R25 | 1
66 | Resistor 10k +/-1% 0805 125 mW | Chip Resistor, 10 KOhm, +/- 1%, 125 mW, -55 to 155 degC, 0805 (2012 Metric) | R26, R27, R28, R29, R30, R31, R32, R33, R34, R35, R36, R37, R38, R39, R40, R41, R42, R43, R44, R45 | 20
67 | Resistor 1K +/-5% 0805 125 mW | Chip Resistor, 1 kOhms, +/-5%, 125 mW, -55 to 155 degC, 0805 | R200, R300 | 2
68 | res 2ohms 0603 | Res Thick Film 0603 2 Ohm 5% 0.1W(1/10W) ±200ppm/C Pad SMD Automotive T/R | R201 | 1
69 | Resistor 10k +/-1% 0805 125 mW | Chip Resistor, 10 KOhm, +/- 1%, 125 mW, -55 to 155 degC, 0805 (2012 Metric) | R202, R302 | 2
70 | res 1.2k 0805 | Fixed Resistor, Metal Glaze/thick Film, 0.125W, 1200ohm, 500V, 1% +/-Tol, 100ppm/Cel, Surface Mount, 0805 | R301 | 1
71 | 10R2F | 10R 0.063W 1% 0402 (1005 Metric) SMD | R303, R304 | 2
72 | Resistor 10k +/-1% 0603 100 mW | Chip Resistor, 10 KOhm, +/- 1%, 01 W, -55 to 155 degC, 0603 (1608 Metric) | R305 | 1
73 | res 14.3k 0603 | Fixed Resistor, Thin Film, 0.1W, 14300ohm, 75V, 0.1% +/-Tol, 25ppm/Cel, Surface Mount, 0603 | R306 | 1
74 | M2S050-FG484 | Description | U16 | 1
75 | TPS3823-33DBVT | Active-low, push-pull, voltage supervisor (reset IC) with 1.6-s watchdog & manual reset | U17 | 1
76 | TPS62903QRYTRQ1 | Automotive, 3-V to 18-V, 3-A low-IQ synchronous buck converter with 165Â°C junction temperature 9-VQFN-HR -40 to 165 | U100, U101, U102 | 3
77 | TPS22918TDBVRQ1 | 1-ch, 5.5-V, 2-A, 52-mÎ© automotive load switch with adj. rise time and adj. output discharg | U103, U104 | 2
78 | LT3045IMSE#WPBF | 20V, 500mA, Ultralow Noise, Ultrahigh PSRR Linear Regulator | U105 | 1
79 | INA226AIDGST | 36V, 16-bit, ultra-precise i2c output current/voltage/power monitor w/alert | U106 | 1
80 | PE4259 | RF Switch IC General Purpose SPDT 3 GHz 50Ohm SC-70-6 | U200, U300 | 2
81 | ADL5324ARKZ-R7 | 400 MHz TO 4000 MHz Â½ Watt RF Driver Amplifier | U201 | 1
82 | ADL5320ARKZ-R7 | 400 MHz TO 2700 MHz Â¼ Watt RF Driver Amplifier | U301 | 1
83 | MAX2644EXT-T | 2.4GHz SiGe, High IP3 Low-Noise Amplifier | U303 | 1
84 | AD9364BBCZ | 1 x 1 RF Agile Transceiver | U305 | 1
85 | IS43TR16256A-125KBL | No Description Available | U400 | 1
86 | MTFC32GAPALBH-AAT | No Description Available | U401 | 1
87 | MR4A16BCYS35R | No Description Available | U402, U403 | 2
88 | S3A33025-50.000-L-X-R |  | Y3 | 1
89 | S733025T-40.000-15-R |  | Y300 | 1
