juanjodiaz04/Proyecto_Diseno_Productos/(list of files, drawings)

Other design files:
Lab4_Altium_Files/Borrador_All_Components.SchDoc
Lab4_Altium_Files/Interfaces.SchDoc
Lab4_Altium_Files/Lab4_Altium_Files1.SCHLIB
Lab4_Altium_Files/Lab4_Altium_Files.PrjPcb
Lab4_Altium_Files/Lab4_Altium_Files.SCHLIB
Lab4_Altium_Files/Lab4_Altium_Files_1.SCHLIB
Lab4_Altium_Files/Mem_IS43TR16256A.SchDoc
Lab4_Altium_Files/Memory.SchDoc
Lab4_Altium_Files/MR4A16BCYS35R.SchDoc
Lab4_Altium_Files/MTFC32GAPALBH.SchDoc
Lab4_Altium_Files/Power.SchDoc
Lab4_Altium_Files/S_Band.SchDoc
Lab4_Altium_Files/Sheet1.SchDoc
Lab4_Altium_Files/Sheet2.SchDoc
Lab4_Altium_Files/Soc_SmartFusion2.SchDoc
Lab4_Altium_Files/Top_Board.SchDoc
Lab4_Altium_Files/UHF.SchDoc
