juanjodiaz04/Proyecto_Diseno_Productos/(commit log)

2026-10-07 Subir Referencias y Tabla de Presupuestos
    [CubeSat_UD34_Matrices_Presupuestos.xlsx]
2026-10-07 Tabla de Componentes Preeliminar
    [BOM_CubeSat_1U_OBC_Comms.xlsx]
2026-10-07 Tabla de Especificaciones
    [Especificaciones_Tecnicas_CubeSat.xlsx]
2026-10-07 Datasheets por componentes
    [BOM_CubeSat_1U_OBC_Comms.xlsx]
2026-10-17 Schematic creation
2026-10-17 Add Schematic 2
2026-10-17 Add Second schematic file
2026-10-19 Añadir Jerarquía de Esquemáticos
2026-10-20 Editar componentes en la estructura de archivos
2026-10-20 Distribución final de componentes
2026-10-26 Total UHF connectivity and power
2026-10-26 Readme de la tarjeta
2026-10-27 Archivos de entrega
